pmamatis/The-Body-Synthesizer/UI/e-paper.JPG

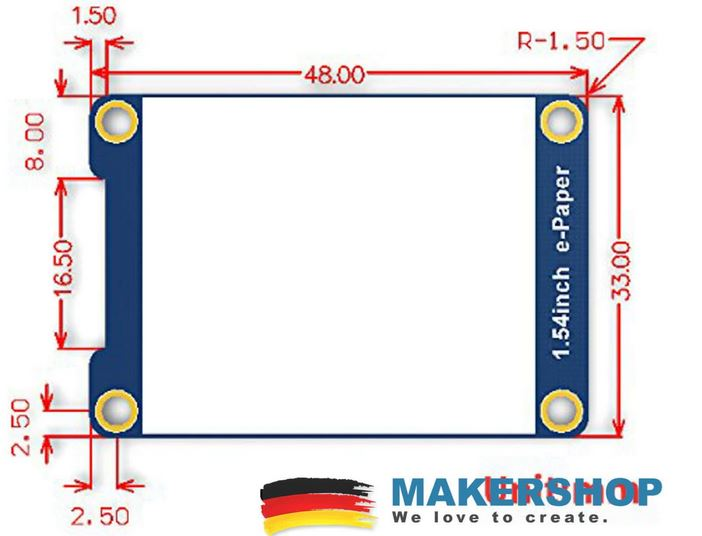
UI/e-paper.JPG
