pmamatis/The-Body-Synthesizer/EMG/pics/EMG_case_1.jpg

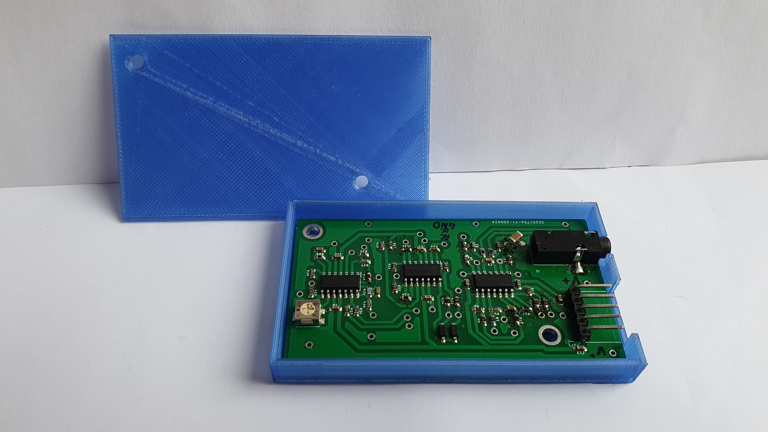
EMG/pics/EMG_case_1.jpg
