pmamatis/The-Body-Synthesizer/ACC/ACC.png

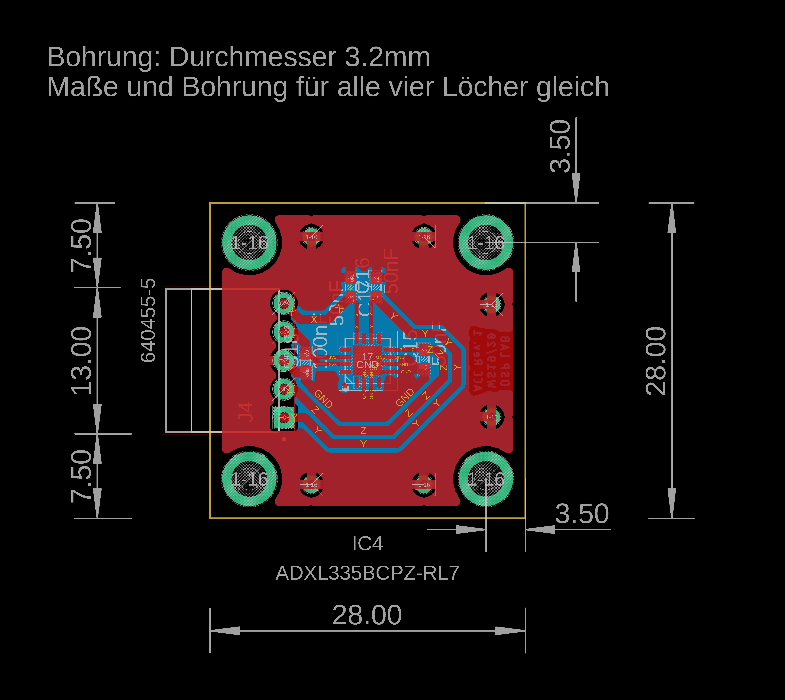
ACC/ACC.png
