pmamatis/The-Body-Synthesizer/EMG/pics/2.jpg

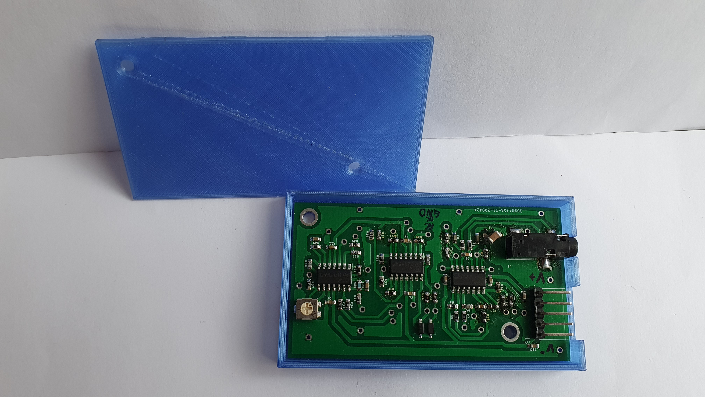
EMG/pics/2.jpg
