pmamatis/The-Body-Synthesizer/EMG/pics/EMG_board_brd_1.png

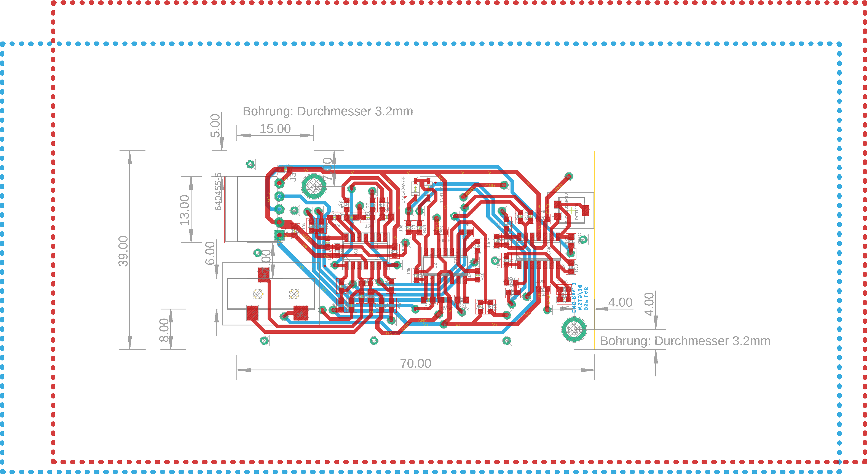
EMG/pics/EMG_board_brd_1.png
