pmamatis/The-Body-Synthesizer/EMG/pics/EMG_board_brd_1_small.png

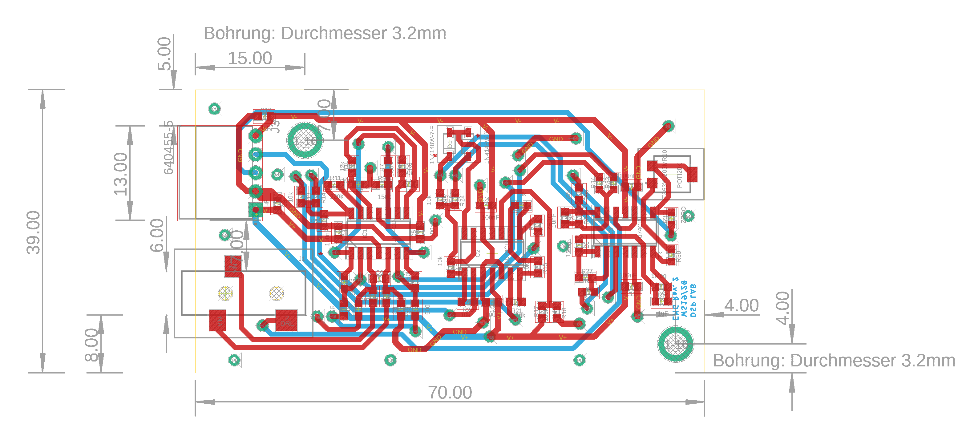
EMG/pics/EMG_board_brd_1_small.png
