pmamatis/The-Body-Synthesizer/EMG/pics/EMG_board_brd_2.png

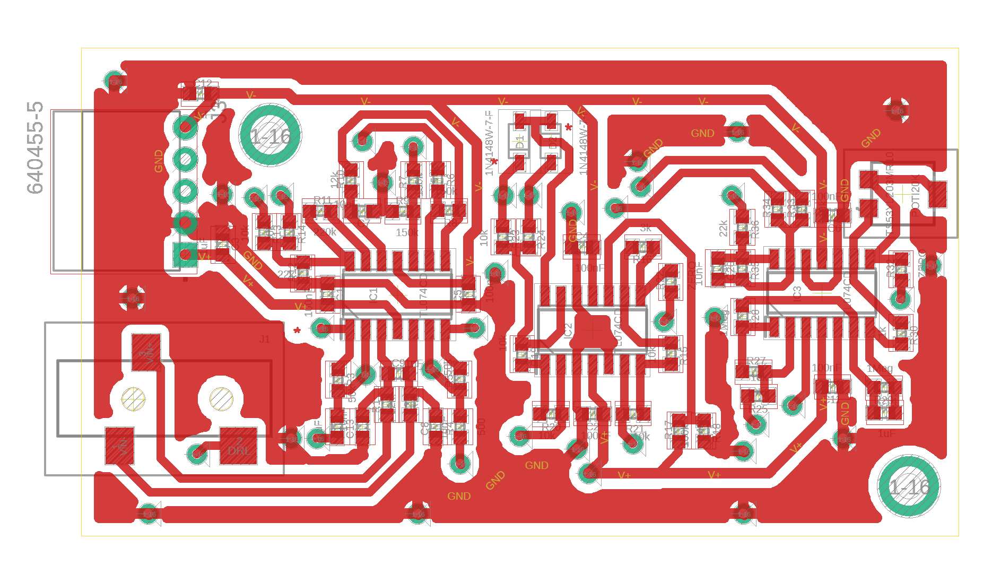
EMG/pics/EMG_board_brd_2.png
