pmamatis/The-Body-Synthesizer/EMG/pics/EMG_board_brd_3.png

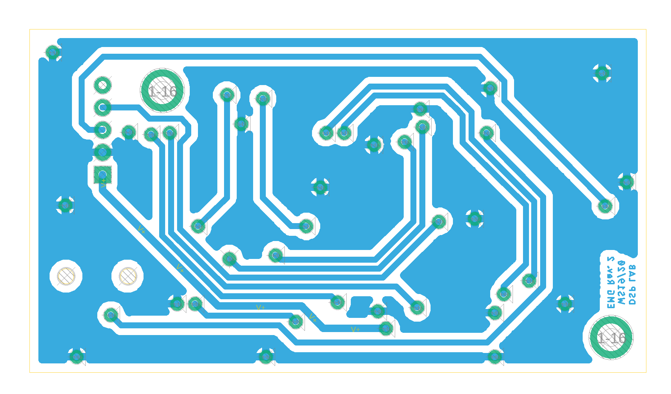
EMG/pics/EMG_board_brd_3.png
