pmamatis/The-Body-Synthesizer/EMG/pics/EMG_board_sch.png

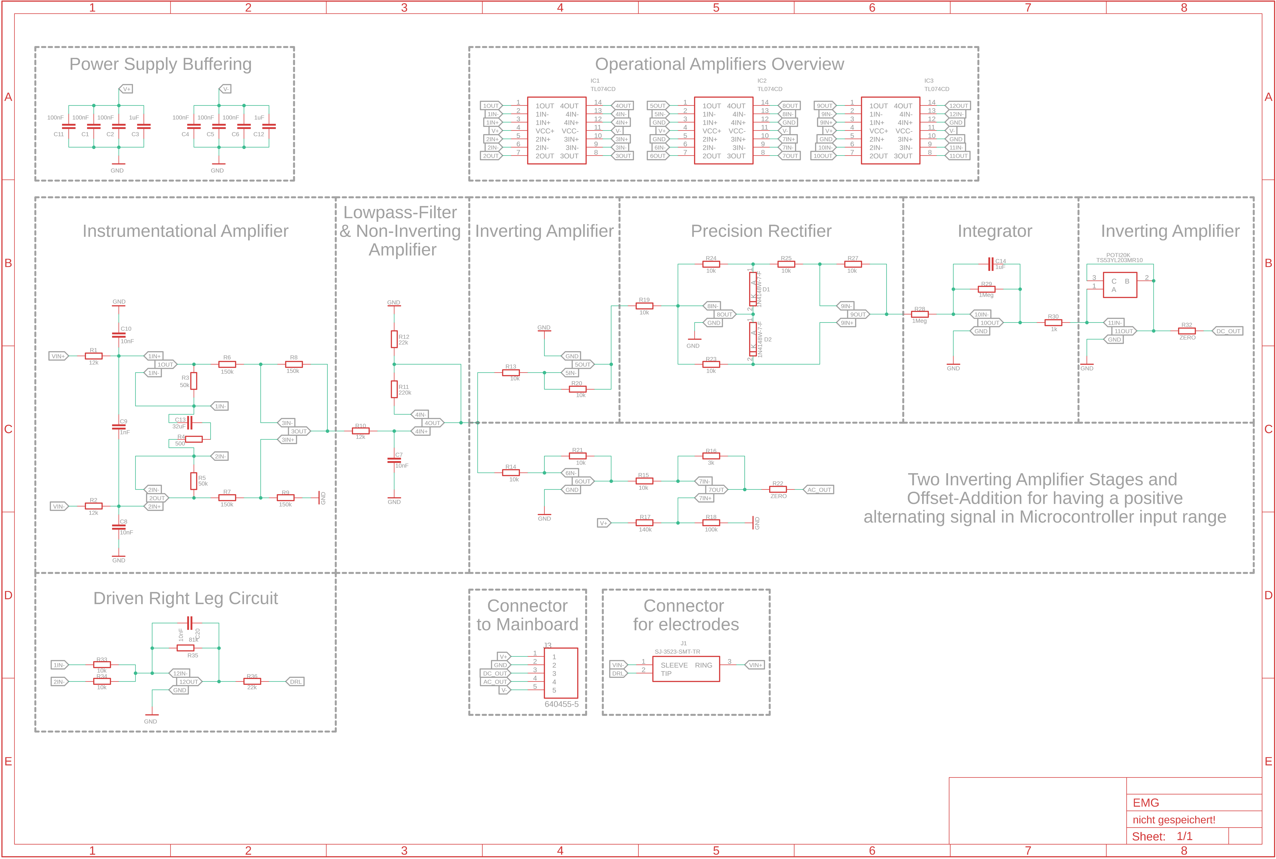
EMG/pics/EMG_board_sch.png
