pmamatis/The-Body-Synthesizer/EMG/pics/EMG_case_2.jpg

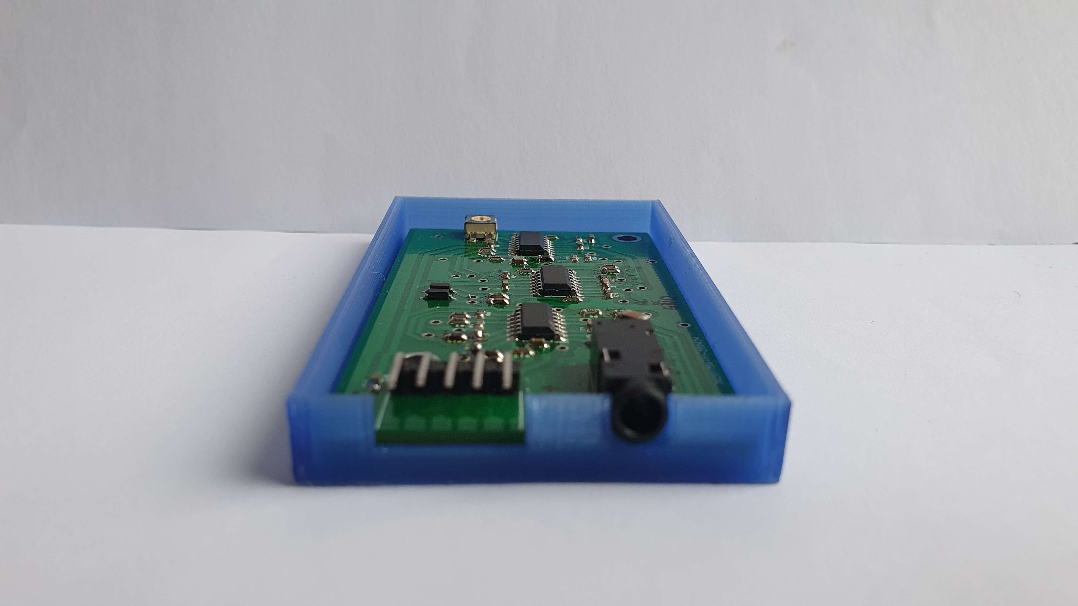
EMG/pics/EMG_case_2.jpg
