pmamatis/The-Body-Synthesizer/EMG/pics/EMG_case_3.jpg

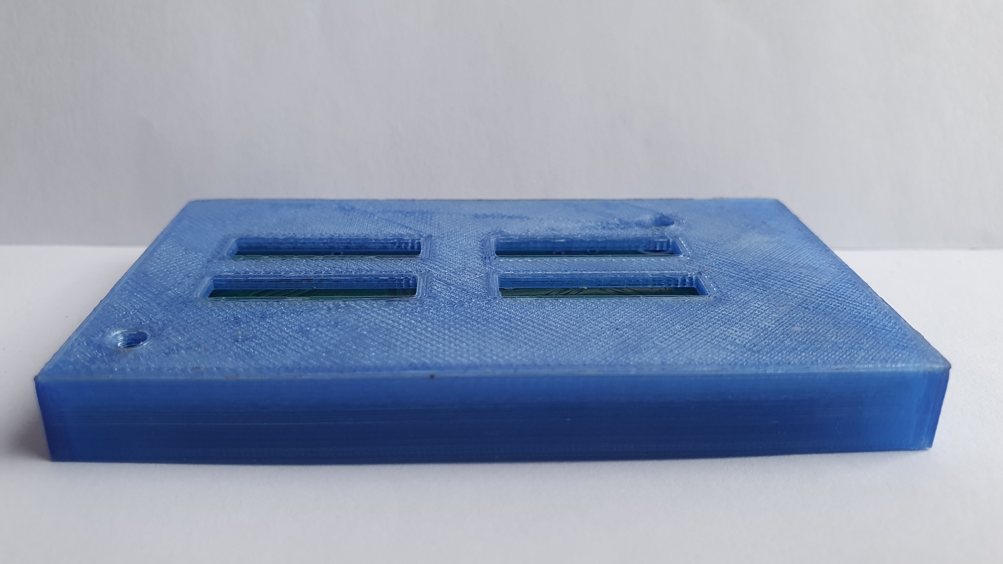
EMG/pics/EMG_case_3.jpg
