pmamatis/The-Body-Synthesizer/EMG/pics/Measurements/bericht/3_EMG_HB1.png

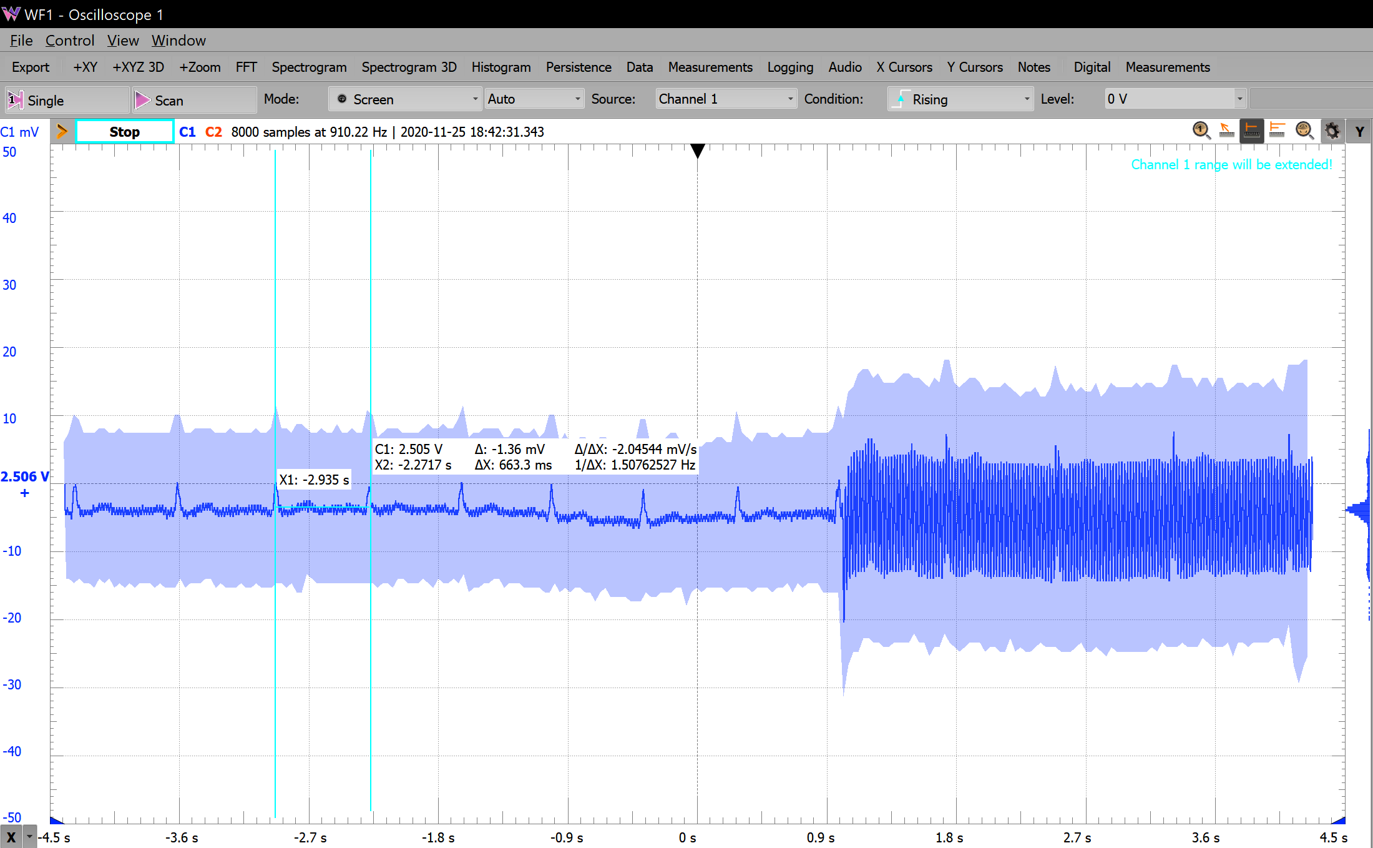
EMG/pics/Measurements/bericht/3_EMG_HB1.png
