pmamatis/The-Body-Synthesizer/EMG/pics/Measurements/bericht/3_EMG_Max_stress_2.png

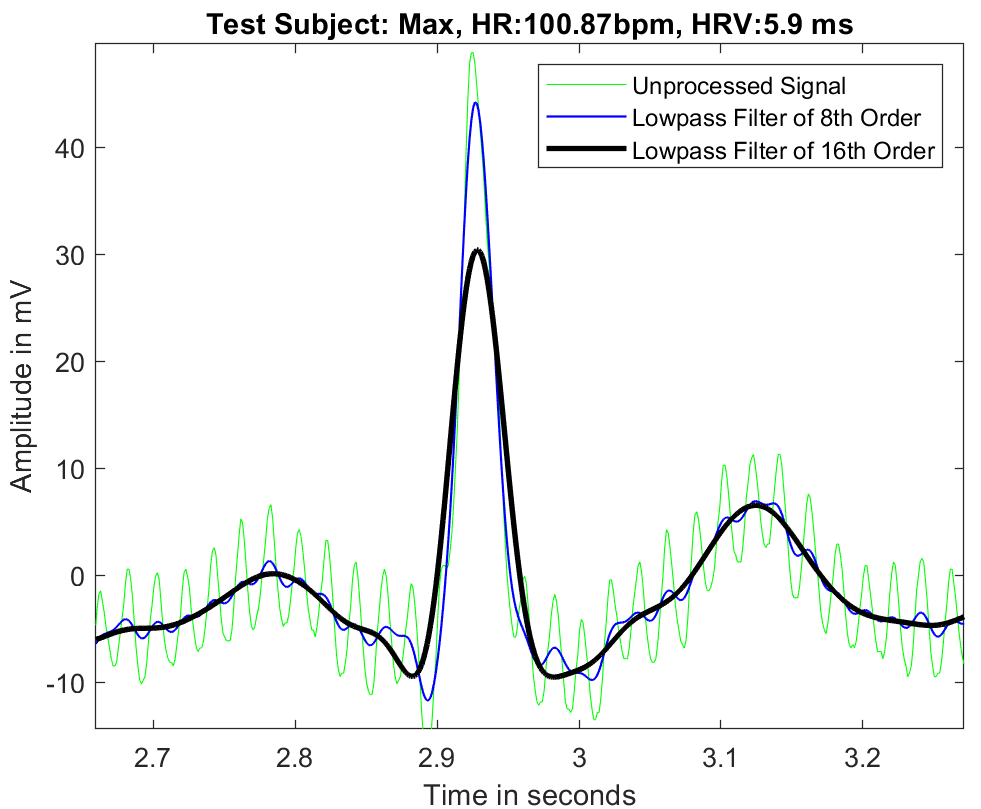
EMG/pics/Measurements/bericht/3_EMG_Max_stress_2.png
