pmamatis/The-Body-Synthesizer/EMG/pics/Measurements/bericht/3_EMG_PEAK.png

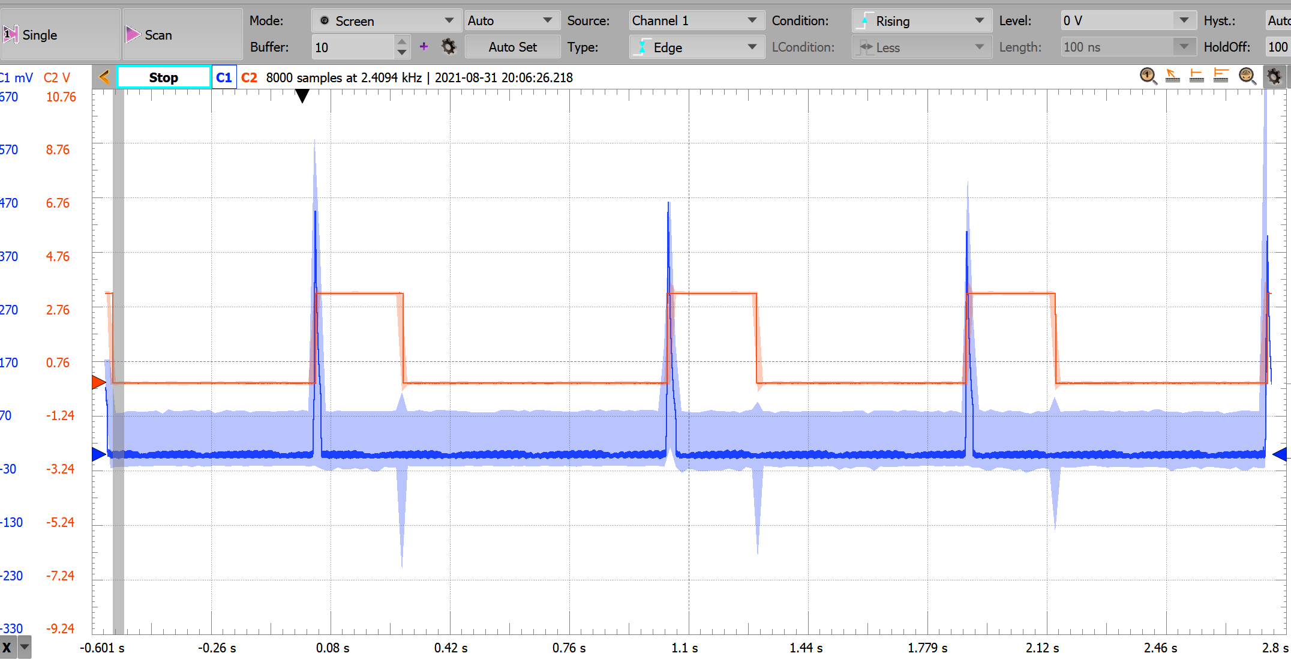
EMG/pics/Measurements/bericht/3_EMG_PEAK.png
