pmamatis/The-Body-Synthesizer/Keyboard/3_Keyboard_brd_V1.png

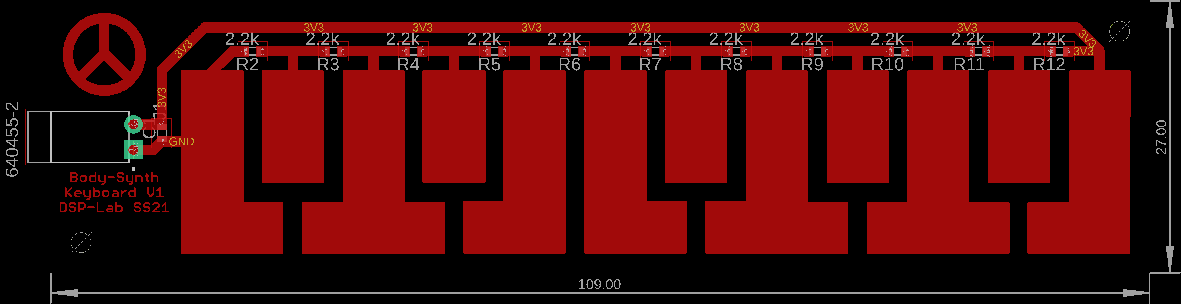
Keyboard/3_Keyboard_brd_V1.png
