pmamatis/The-Body-Synthesizer/Keyboard/3_Keyboard_brd_V2.png

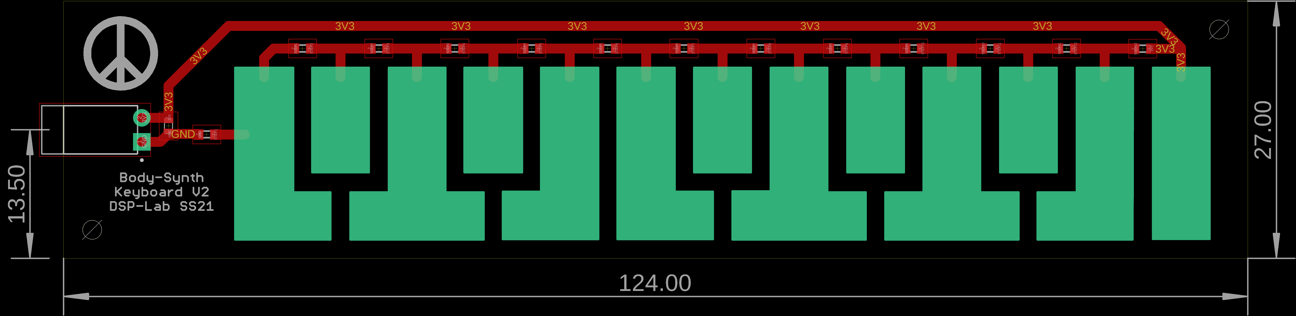
Keyboard/3_Keyboard_brd_V2.png
