pmamatis/The-Body-Synthesizer/Keyboard/3_Keyboard_sch_V2.png

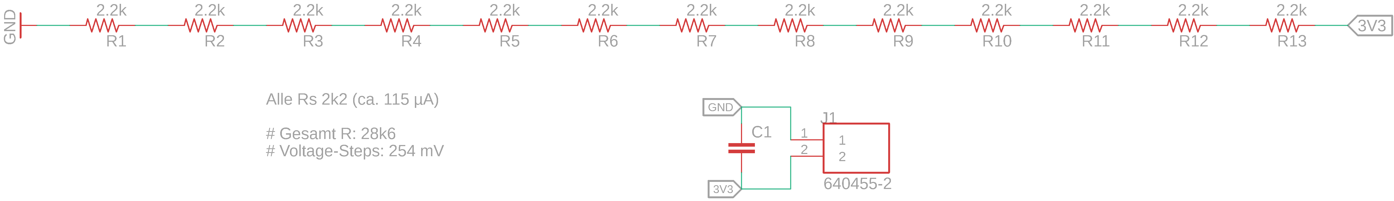
Keyboard/3_Keyboard_sch_V2.png
