pmamatis/The-Body-Synthesizer/Mainboard/pics/Gesamtsystem_pic.png

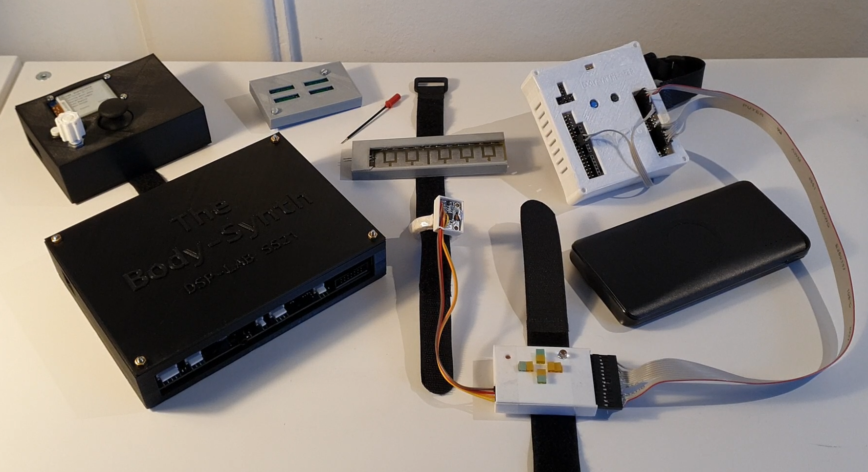
Mainboard/pics/Gesamtsystem_pic.png
