pmamatis/The-Body-Synthesizer/Mainboard/pics/Gyro_pic.png

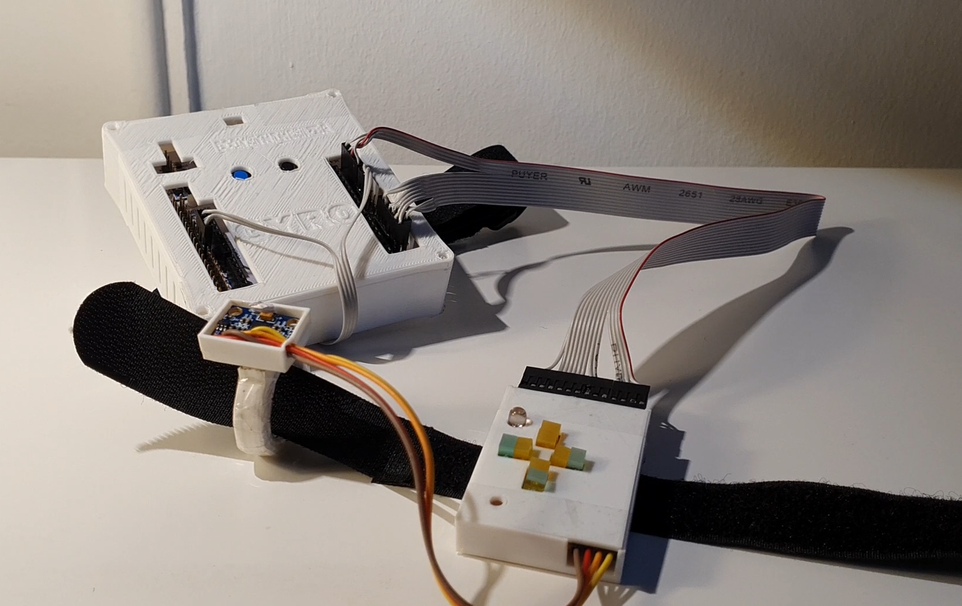
Mainboard/pics/Gyro_pic.png
