pmamatis/The-Body-Synthesizer/Mainboard/pics/Mainboard_brd_1.png

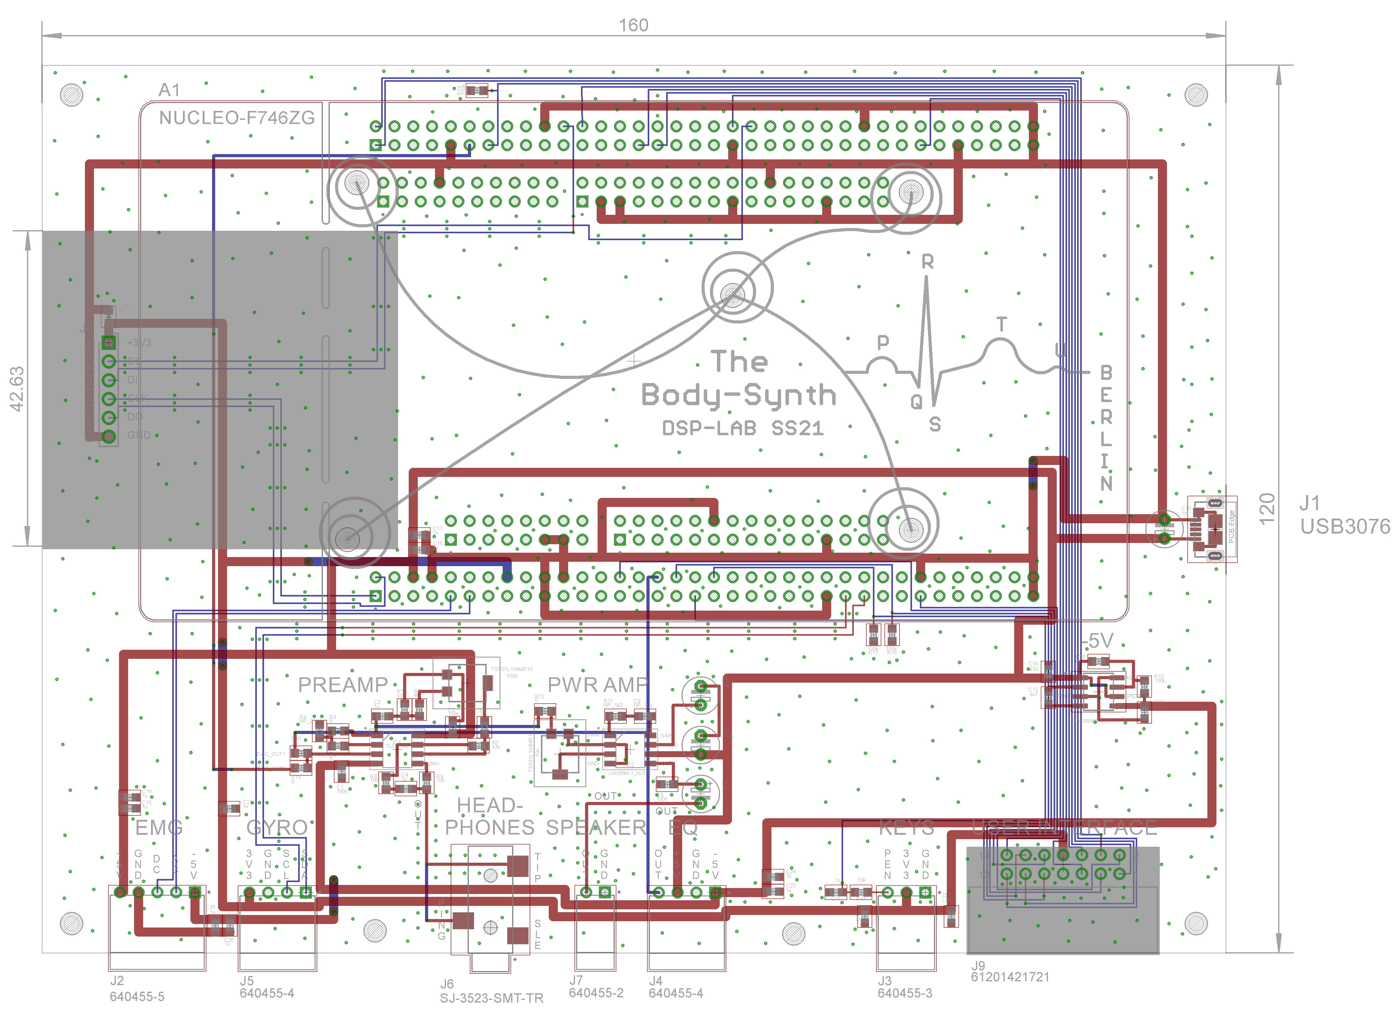
Mainboard/pics/Mainboard_brd_1.png
