pmamatis/The-Body-Synthesizer/Mainboard/pics/Mainboard_brd_2.png

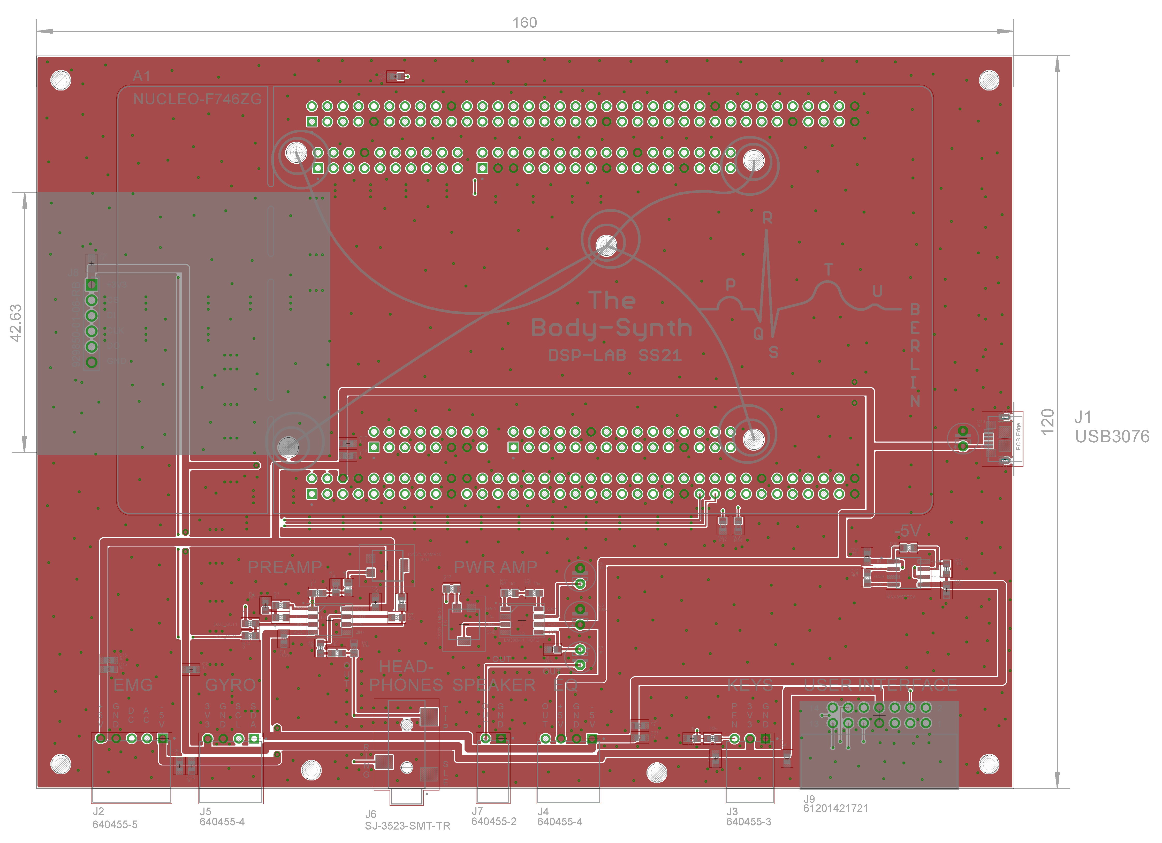
Mainboard/pics/Mainboard_brd_2.png
