pmamatis/The-Body-Synthesizer/Mainboard/pics/Mainboard_brd_3.png

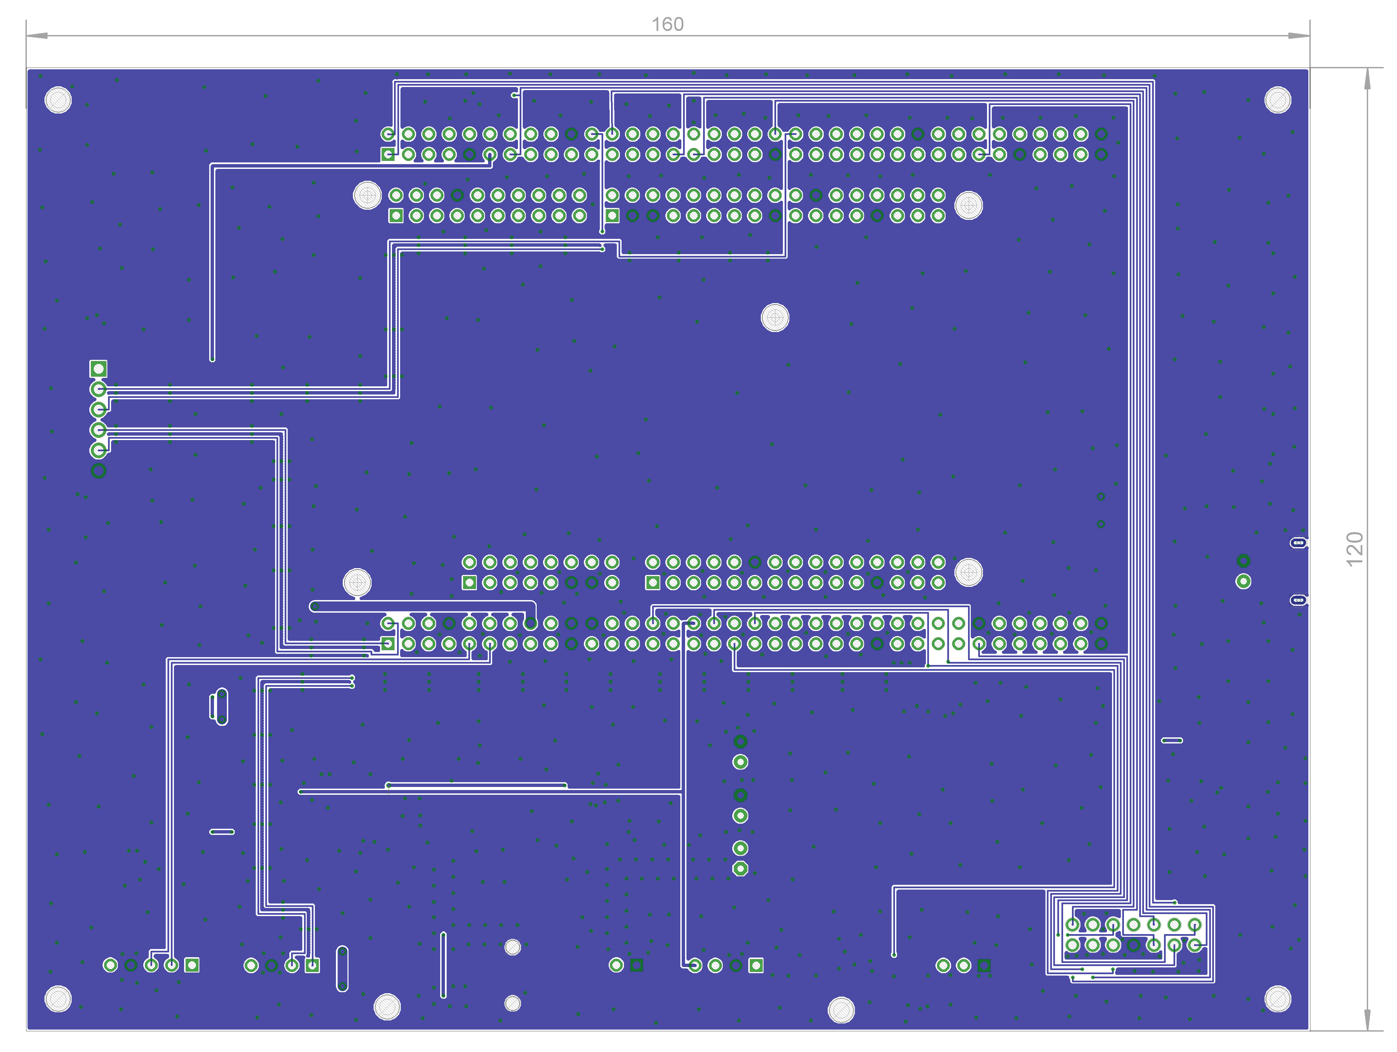
Mainboard/pics/Mainboard_brd_3.png
