pmamatis/The-Body-Synthesizer/Mainboard/pics/Mainboard_pic1.jpg

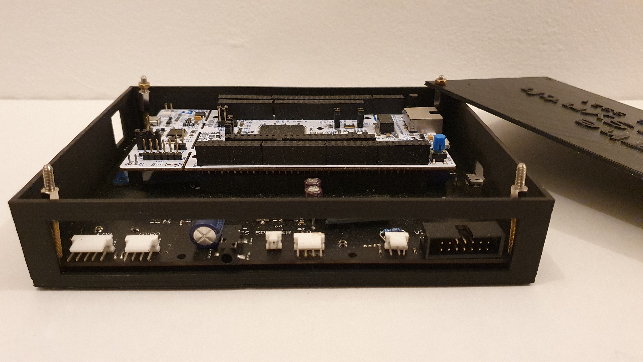
Mainboard/pics/Mainboard_pic1.jpg
