pmamatis/The-Body-Synthesizer/Mainboard/pics/Mainboard_sch_1.png

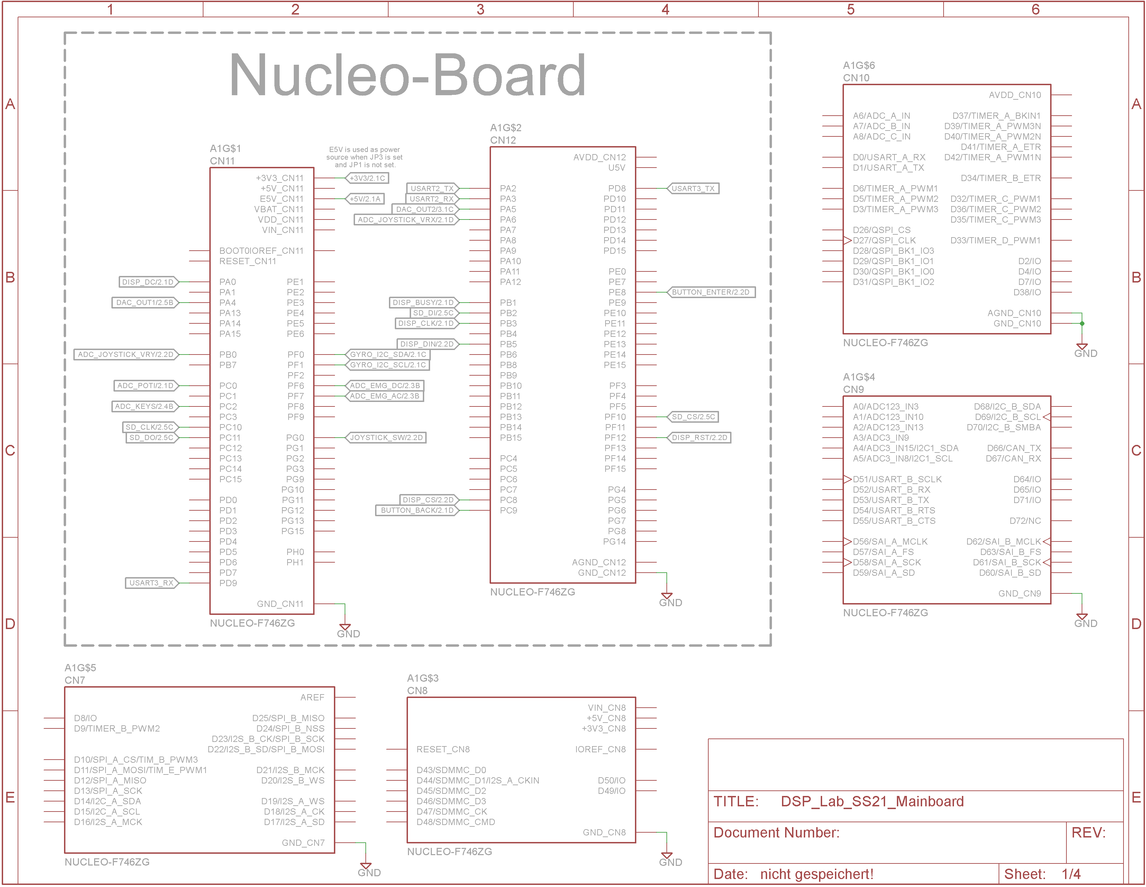
Mainboard/pics/Mainboard_sch_1.png
