pmamatis/The-Body-Synthesizer/Mainboard/pics/Mainboard_sch_2.png

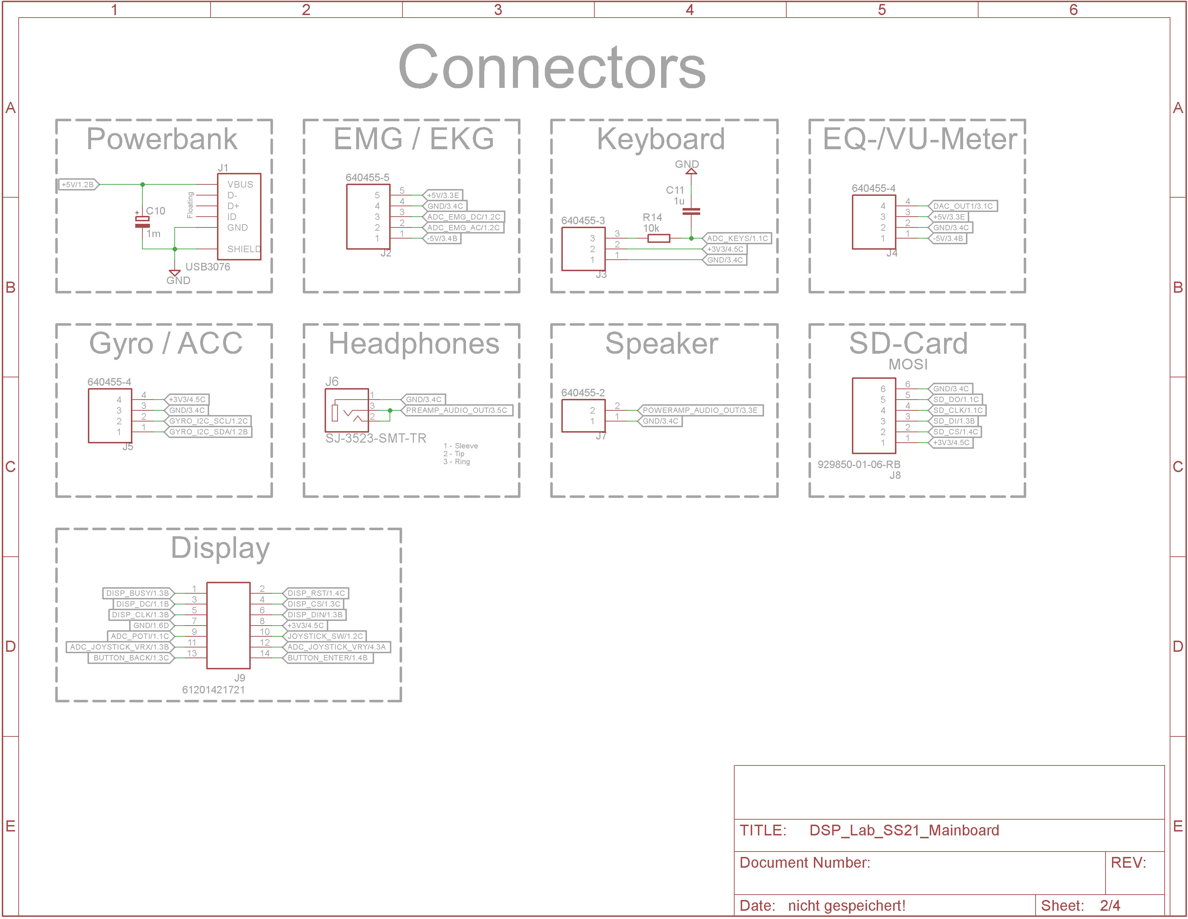
Mainboard/pics/Mainboard_sch_2.png
