pmamatis/The-Body-Synthesizer/Mainboard/pics/Mainboard_sch_3.png

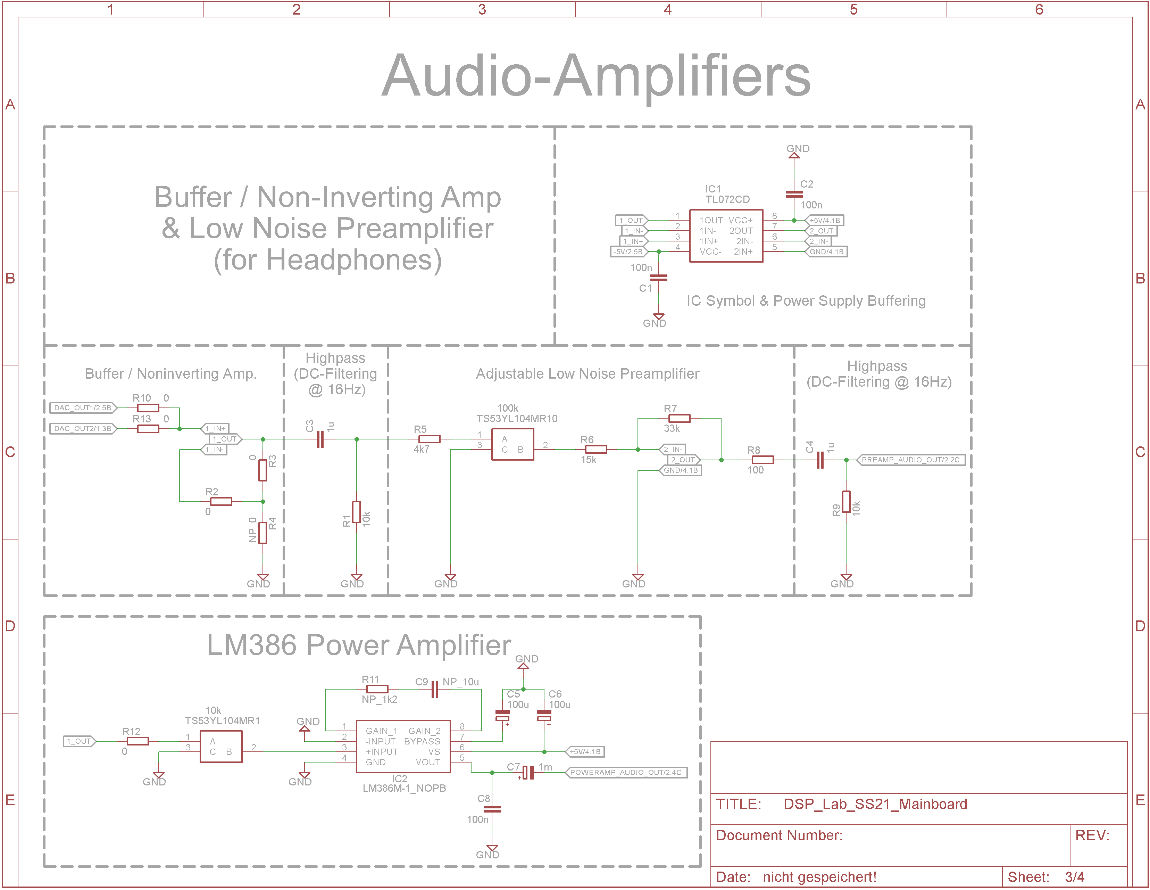
Mainboard/pics/Mainboard_sch_3.png
