pmamatis/The-Body-Synthesizer/Mainboard/pics/Mainboard_sch_4.png

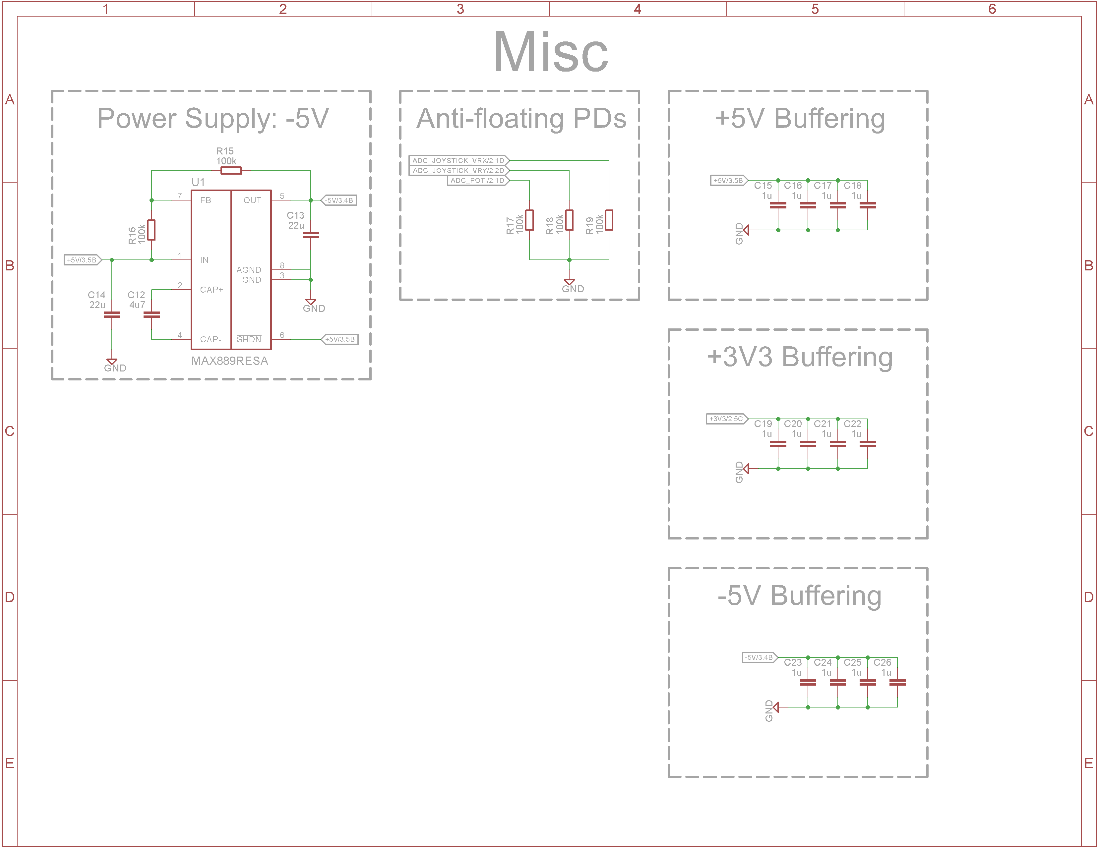
Mainboard/pics/Mainboard_sch_4.png
