pmamatis/The-Body-Synthesizer/UI/displaybild.JPG

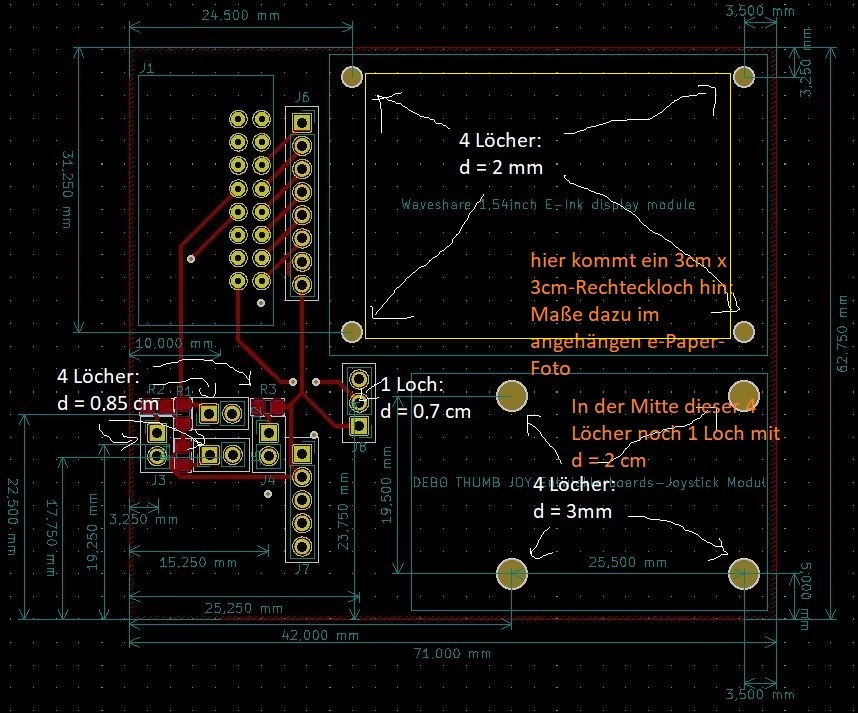
UI/displaybild.JPG
