pmamatis/The-Body-Synthesizer/210720_PRODUCTION/BOMs/BOM_DSP_Lab_SS21_Equalizer_VUMeter_fin.xlsx

Qty | Value | Device | Package | Parts | Description | AVAILABILITY | CENTERLINE_PITCH | COMMENT | DESCRIPTION | MF | MP | NUMBER_OF_POSITIONS | PACKAGE | POPULARITY | PRICE | PRODUCT_TYPE | PURCHASE-URL | SPICEPREFIX
30 |  | LEDCHIP-LED0603 | CHIP-LED0603 | LD1, LD2, LD3, LD4, LD5, LD6, LD7, LD8, LD9, LD10, LD11, LD12, LD13, LD14, LD15, LD16, LD17, LD18, LD19, LD20, LD21, LD22, LD23, LD24, LD25, LD26, LD27, LD28, LD29, LD30 | LED |  |  |  |  |  |  |  |  | 26
2 |  | MMSZ5226B-7-F | SOD3715X135L32X57N | D7, D14 | Diode Zener Single 3.3V 5% 500mW Automotive 2-Pin SOD-123 T/R Check prices | Good |  |  | Zener Diode 3.3V 500mW Â±5% Surface Mount SOD-123 | Diodes Inc. | MMSZ5226B-7-F |  | SOD-123 Diodes Inc. |  | None |  | https://pricing.snapeda.com/search/part/MMSZ5226B-7-F/?ref=eda
5 | 0 | R-EU_R0603 | R0603 | R26, R27, R103, R104, R105 | RESISTOR, European symbol
1 | 1 uF | C-EUC0603 | C0603 | CCUK | CAPACITOR, European symbol |  |  |  |  |  |  |  |  | 73 |  |  |  | C
1 | 1.13K | R-EU_R0603 | R0603 | R37 | RESISTOR, European symbol
1 | 1.54K | R-EU_R0603 | R0603 | R5 | RESISTOR, European symbol
1 | 1.62K | R-EU_R0603 | R0603 | R4 | RESISTOR, European symbol
1 | 1.82K | R-EU_R0603 | R0603 | R34 | RESISTOR, European symbol
3 | 10 uH | ASMCI-0603-100M-T | INDC1608X95N | L1, L2, L3 | MULTILAYER CHIP POWER INDUCTOR, 10UH, 50MA, CERAMIC, Â±20%, SHIELDED, 0.90 OHM, 20MHZ, 0603, SMD Check prices | Good |  |  | 10ÂµH Shielded Multilayer Inductor 50mA 900mOhm 0603 (1608 Metric) | Abracon LLC | ASMCI-0603-100M-T |  | 1608 Taiyo Yuden |  | None |  | https://pricing.snapeda.com/search/part/ASMCI-0603-100M-T/?ref=eda
1 | 10.2K | R-EU_R0603 | R0603 | R33 | RESISTOR, European symbol
1 | 100n | C-EUC0603 | C0603 | C38 | CAPACITOR, European symbol |  |  |  |  |  |  |  |  | 73 |  |  |  | C
18 | 100n | C-EUC0603 | C0603 | C3, C4, C6, C8, C9, C10, C11, C12, C13, C15, C16, C17, C18, C27, C28, C29, C32, C39 | CAPACITOR, European symbol
3 | 100u | C-EUC0603 | C0603 | C34, C35, C36 | CAPACITOR, European symbol
2 | 10K | R-EU_R0603 | R0603 | R7, R8 | RESISTOR, European symbol
8 | 10n | C-EUC0603 | C0603 | C19, C20, C21, C22, C23, C24, C25, C26 | CAPACITOR, European symbol
12 | 10u | C-EUC0603 | C0603 | C14, C40, C41, C42, C43, C44, C45, C46, C47, C48, C49, C50 | CAPACITOR, European symbol
1 | 120K | R-EU_R0603 | R0603 | R23 | RESISTOR, European symbol
1 | 12n | C-EUC0603 | C0603 | C30 | CAPACITOR, European symbol
1 | 13.3K | R-EU_R0603 | R0603 | R35 | RESISTOR, European symbol
1 | 13K | R-EU_R0603 | R0603 | R28 | RESISTOR, European symbol
1 | 15.5K | R-EU_R0603 | R0603 | R39 | RESISTOR, European symbol
1 | 15n | C-EUC0603 | C0603 | C31 | CAPACITOR, European symbol
2 | 18.2K | R-EU_R0603 | R0603 | R13, R38 | RESISTOR, European symbol
60 | 1K | R-EU_R0603 | R0603 | R43, R44, R45, R46, R47, R48, R49, R50, R51, R52, R53, R54, R55, R56, R57, R58, R59, R60, R61, R62, R63, R64, R65, R66, R67, R68, R69, R70, R71, R72, R73, R74, R75, R76, R77, R78, R79, R80, R81, R82, R83, R84, R85, R86, R87, R88, R89, R90, R91, R92, R93, R94, R95, R96, R97, R98, R99, R100, R101, R102 | RESISTOR, European symbol
30 | 1N4148WS | 1N4148WS | SODFL2512X100N | D1, D2, D3, D4, D5, D6, D8, D9, D10, D11, D12, D13, D15, D16, D17, D18, D19, D20, D22, D23, D24, D25, D26, D27, D29, D30, D31, D32, D33, D34 | 1N4148WS Series 75 V 300 mA Surface Mount Small Signal Diodes - SOD-323F Check prices | Good |  |  | Diode Standard 75V 150mA Surface Mount SOD-323F | ON Semiconductor | 1N4148WS |  | SOD-323FL-2 ON Semiconductor |  | None |  | https://pricing.snapeda.com/search/part/1N4148WS/?ref=eda
1 | 2.2 uF | C-EUC0603 | C0603 | C5 | CAPACITOR, European symbol |  |  |  |  |  |  |  |  | 73 |  |  |  | C
2 | 200u | C-EUC0603 | C0603 | C33, C37 | CAPACITOR, European symbol
1 | 20K | R-EU_R0603 | R0603 | R30 | RESISTOR, European symbol
2 | 22 uF | C-EUC0603 | C0603 | CIN, COUT | CAPACITOR, European symbol |  |  |  |  |  |  |  |  | 73 |  |  |  | C
1 | 220 pF | C-EUC0603 | C0603 | CF | CAPACITOR, European symbol |  |  |  |  |  |  |  |  | 73 |  |  |  | C
2 | 220n | C-EUC0603 | C0603 | C1, C2 | CAPACITOR, European symbol
1 | 22K | R-EU_R0603 | R0603 | R24 | RESISTOR, European symbol
1 | 23.2K | R-EU_R0603 | R0603 | R10 | RESISTOR, European symbol
1 | 29.1K | R-EU_R0603 | R0603 | R18 | RESISTOR, European symbol
2 | 29.4K | R-EU_R0603 | R0603 | R40, RFB1 | RESISTOR, European symbol
1 | 2K | R-EU_R0603 | R0603 | R21 | RESISTOR, European symbol
1 | 3,3K | R-EU_R0603 | R0603 | R22 | RESISTOR, European symbol
1 | 3.16K | R-EU_R0603 | R0603 | R17 | RESISTOR, European symbol
4 | 3.3k | R-EU_R0603 | R0603 | R3, R11, R19, R41 | RESISTOR, European symbol
1 | 3.7K | R-EU_R0603 | R0603 | R2 | RESISTOR, European symbol
1 | 3.9K | R-EU_R0603 | R0603 | R1 | RESISTOR, European symbol
1 | 330 pF | C-EUC0603 | C0603 | CFF | CAPACITOR, European symbol |  |  |  |  |  |  |  |  | 73 |  |  |  | C
4 | 35K | R-EU_R0603 | R0603 | R6, R12, R25, R42 | RESISTOR, European symbol
1 | 3K | R-EU_R0603 | R0603 | R9 | RESISTOR, European symbol
1 | 4.7 uF | C-EUC0603 | C0603 | C7 | CAPACITOR, European symbol |  |  |  |  |  |  |  |  | 73 |  |  |  | C
1 | 4K | R-EU_R0603 | R0603 | R20 | RESISTOR, European symbol
1 | 5.23K | R-EU_R0603 | R0603 | R29 | RESISTOR, European symbol
1 | 5.76K | R-EU_R0603 | R0603 | RFB2 | RESISTOR, European symbol
1 | 5.9K | R-EU_R0603 | R0603 | R14 | RESISTOR, European symbol
1 | 51K | R-EU_R0603 | R0603 | R32 | RESISTOR, European symbol
1 | 53,6K | R-EU_R0603 | R0603 | R15 | RESISTOR, European symbol
1 | 6.2K | R-EU_R0603 | R0603 | R36 | RESISTOR, European symbol
1 | 640455-4 | 640455-4 | TE_640455-4 | J2 | Check prices | In Stock | 2.54 mm[.1 in] | 640455-4 | Headers & Receptacles cable a placa 8 POS MONO SHAPE MKII TAB ASS'Y GW 750.N TYCO / TE CONNECTIVITY | TE Connectivity | 640455-4 | 4 | None |  | None | Connector | https://pricing.snapeda.com/search/part/640455-4/?ref=eda
1 | 68 K | R-EU_R0603 | R0603 | R31 | RESISTOR, European symbol
1 | 9.76K | R-EU_R0603 | R0603 | R16 | RESISTOR, European symbol
29 | BC846A | BC846A | SOT23-3 | T1, T2, T3, T4, T5, T6, T7, T8, T9, T11, T12, T13, T14, T15, T16, T17, T18, T19, T20, T21, T22, T23, T24, T25, T26, T27, T28, T29, T30 |  | Unavailable |  |  | Bipolar (BJT) Transistor NPN 65V 100mA 100MHz 300mW Surface Mount SOT-23-3 (TO-236) | ON Semiconductor | BC846A |  | SOT-23-3 Motorola |  | None
1 | BC846A | BC846A | SOT23-3 | T10 |  | Unavailable |  |  | Bipolar (BJT) Transistor NPN 65V 100mA 100MHz 300mW Surface Mount SOT-23-3 (TO-236) | ON Semiconductor | BC846A |  | SOT-23-3 Motorola |  | None |  |  | J
1 | LM2611 | LM2611BMFX/NOPB | SOT95P280X145-5N | U1 | Check prices | Good |  |  | 1.4MHz Cuk Converter 5-SOT-23 -40 to 125 | Texas Instruments | LM2611BMFX/NOPB |  | SOT-23-5 Texas Instruments |  | None |  | https://pricing.snapeda.com/search/part/LM2611BMFX/NOPB/?ref=eda
1 | LMR62014 | LMR62014XMF/NOPB | SOT95P280X145-5N | U2 | Check prices | Good |  |  | SIMPLE SWITCHER&reg | 2.7V to 14V, 1.4A Step-Up Regulator in SOT-23 Package 5-SOT-23 -40 to 125 | Texas Instruments | LMR62014XMF/NOPB |  | SOT-23-5 Texas Instruments |  | None |  | https://pricing.snapeda.com/search/part/LMR62014XMF/NOPB/?ref=eda
5 | MMSZ5226B-7-F | MMSZ5226B-7-F | SOD3715X135L32X57N | D100, D101, D102, D103, D104 | Diode Zener Single 3.3V 5% 500mW Automotive 2-Pin SOD-123 T/R Check prices | Good |  |  | Zener Diode 3.3V 500mW Â±5% Surface Mount SOD-123 | Diodes Inc. | MMSZ5226B-7-F |  | SOD-123 Diodes Inc. |  | None |  | https://pricing.snapeda.com/search/part/MMSZ5226B-7-F/?ref=eda
3 | TL072D | TL072D | SO08 | IC1, IC5, IC7 | OP AMP |  |  |  |  |  |  |  |  | 0
3 | TL074D | TL074D | SO14 | IC2, IC3, IC4 | OP AMP |  |  |  |  |  |  |  |  | 0
