pmamatis/The-Body-Synthesizer/210720_PRODUCTION/BOMs/BOM_DSP_Lab_SS21_Keyboard_V2.xlsx

Qty | Value | Device | Package | Parts | Description | AVAILABILITY | COMMENT | DESCRIPTION | EU_ROHS_COMPLIANCE | MF | MP | PACKAGE | POPULARITY | PRICE | SPICEPREFIX | TE_PURCHASE_URL
1 |  | C-EUC0603 | C0603 | C1 | CAPACITOR, European symbol |  |  |  |  |  |  |  | 73 |  | C
13 | 2.2k | R-US_R0603 | R0603 | R1, R2, R3, R4, R5, R6, R7, R8, R9, R10, R11, R12, R13 | RESISTOR, American symbol
1 | 640455-2 | 640455-2 | TE_640455-2 | J1 |  | Unavailable | 640455-2 | MTA-100 2 Position 2.54 mm Single Row Right Angle Wire to Board Header | Compliant | TE Connectivity | 640455-2 | None |  | None |  | https://www.te.com/usa-en/product-640455-2.html?te_bu=Cor&te_type=disp&elqCampaignId=32493
