pmamatis/The-Body-Synthesizer/210720_PRODUCTION/BOMs/BOM_DSP_Lab_SS21_Mainboard.xlsx

Qty | Value | Device | Package | Parts | Description | AVAILABILITY | COMMENT | CUI_PURCHASE_URL | DESCRIPTION | DIGI-KEY_PART_NUMBER | DIGI-KEY_PURCHASE_URL | EU_ROHS_COMPLIANCE | HEIGHT | MANUFACTURER_NAME | MANUFACTURER_PART_NUMBER | MF | MOUSER_PART_NUMBER | MOUSER_PRICE-STOCK | MP | PACKAGE | PRICE | PURCHASE-URL | TE_PURCHASE_URL
5 | 0 | R-EU_R0603 | R0603 | R2, R3, R10, R12, R13 | RESISTOR, European symbol
1 | 100 | R-EU_R0603 | R0603 | R8 | RESISTOR, European symbol
2 | 100k | R-EU_R0603 | R0603 | R15, R16 | RESISTOR, European symbol
1 | 100k | TS53YL203MR10 | TS53YL203MR10 | TS53YL104MR10 | Vishay TS53YL Series SMD Trimmer Resistor with Gull Wing Terminations, 20k +/-20% 1/4W +/-100ppm/C Top Adjust |  |  |  | Vishay TS53YL Series SMD Trimmer Resistor with Gull Wing Terminations, 20k +/-20% 1/4W +/-100ppm/C Top Adjust |  |  |  | 2.7mm | Vishay | TS53YL203MR10 |  | 72-TS53YL-20K | https://www.mouser.com/Search/Refine.aspx?Keyword=72-TS53YL-20K
3 | 100n | C-EUC0603 | C0603 | C1, C2, C8 | CAPACITOR, European symbol
2 | 100u | CPOL-EUE2.5-5 | E2,5-5 | C5, C6 | POLARIZED CAPACITOR, European symbol
3 | 10k | R-EU_R0603 | R0603 | R1, R9, R14 | RESISTOR, European symbol
1 | 10k | TS53YL203MR10 | TS53YL203MR10 | TS53YL104MR1 | Vishay TS53YL Series SMD Trimmer Resistor with Gull Wing Terminations, 20k +/-20% 1/4W +/-100ppm/C Top Adjust |  |  |  | Vishay TS53YL Series SMD Trimmer Resistor with Gull Wing Terminations, 20k +/-20% 1/4W +/-100ppm/C Top Adjust |  |  |  | 2.7mm | Vishay | TS53YL203MR10 |  | 72-TS53YL-20K | https://www.mouser.com/Search/Refine.aspx?Keyword=72-TS53YL-20K
1 | 15k | R-EU_R0603 | R0603 | R6 | RESISTOR, European symbol
3 | 1Meg | R-EU_R0603 | R0603 | R17, R18, R19 | RESISTOR, European symbol
2 | 1m | CPOL-EUE2.5-5 | E2,5-5 | C7, C10 | POLARIZED CAPACITOR, European symbol
15 | 1u | C-EUC0603 | C0603 | C3, C4, C11, C15, C16, C17, C18, C19, C20, C21, C22, C23, C24, C25, C26 | CAPACITOR, European symbol
2 | 22u | C-EUC0603 | C0603 | C13, C14 | CAPACITOR, European symbol
1 | 33k | R-EU_R0603 | R0603 | R7 | RESISTOR, European symbol
1 | 4k7 | R-EU_R0603 | R0603 | R5 | RESISTOR, European symbol
1 | 4u7 | C-EUC0603 | C0603 | C12 | CAPACITOR, European symbol
1 | 61201421721 | 61201421721 | 61201421721 | J9 | WR-BHD 2.54mm Male Angled Box Header, 14 Pins=>Code : Con_WTB_BHD_2.54_Male_THT_WS_61201421721 | In Stock |  |  | Connector Header Through Hole, Right Angle 14 position 0.100 (2.54mm) |  |  |  |  |  |  | Würth Elektronik |  |  | 61201421721 | None | None
1 | 640455-2 | 640455-2 | TE_640455-2 | J7 | Check prices | In Stock | 640455-2 |  | MTA-100 2 Position 2.54 mm Single Row Right Angle Wire to Board Header |  |  | Compliant |  |  |  | TE Connectivity |  |  | 640455-2 | None | None | https://pricing.snapeda.com/search/part/640455-2/?ref=eda
1 | 640455-3 | 640455-3 | TE_640455-3 | J3 | Check prices | In Stock | 640455-3 |  | Connector Header Through Hole, Right Angle 3 position 0.100 (2.54mm) |  |  | Compliant |  |  |  | TE Connectivity |  |  | 640455-3 | None | None | https://pricing.snapeda.com/search/part/640455-3/?ref=eda
2 | 640455-4 | 640455-4 | TE_640455-4 | J4, J5 | Check prices | In Stock | 640455-4 |  | Headers & Receptacles cable a placa 8 POS MONO SHAPE MKII TAB ASS'Y GW 750.N TYCO / TE CONNECTIVITY |  |  | Compliant |  |  |  | TE Connectivity |  |  | 640455-4 | None | None
1 | 640455-5 | 640455-5 | TE_640455-5 | J2 |  |  | 640455-5 |  | MTA-100 5 Position Through Hole Single Row Right Angle Wire to Board Header | A19453-ND | https://www.digikey.de/product-detail/en/te-connectivity-amp-connectors/640455-5/A19453-ND/259000 |  |  |  |  | TE Connectivity |  |  | 640455-5 | None |  |  | https://www.te.com/usa-en/product-640455-5.html?te_bu=Cor&te_type=disp&elqCampaignId=32493
1 | 929850-01-06-RB | 929850-01-06-RB | RHDR6W76P0X254_1X6_1524X254X82 | J8 | Headers & Wire Housings 6P STRT BRD MNT SKT 1 ROW 30MICRO AU" |  |  |  | Headers & Wire Housings 6P STRT BRD MNT SKT 1 ROW 30MICRO AU" |  |  |  | 8.26mm | 3M | 929850-01-06-RB |  | 517-929850-01-06-RB | https://www.mouser.co.uk/ProductDetail/3M-Electronic-Solutions-Division/929850-01-06-RB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
1 | LM386M-1_NOPB | LM386M-1_NOPB | SOIC127P600X175-8N | IC2 | Wide Input Voltage Low Power Audio Amplifier with Internal Gain |  |  |  | Wide Input Voltage Low Power Audio Amplifier with Internal Gain |  |  |  | 1.75mm | Texas Instruments | LM386M-1/NOPB |  | 926-LM386M-1/NOPB | https://www.mouser.co.uk/ProductDetail/Texas-Instruments/LM386M-1-NOPB?qs=QbsRYf82W3GaJvrwUmrW3g%3D%3D
1 | MAX889RESA | MAX889RESA | SOIC127P600X175-8N | U1 | Check prices | In Stock |  |  | Charge Pump Switching Regulator IC Negative Adjustable -2.5V 1 Output 200mA 8-SOIC (0.154, 3.90mm Width) |  |  |  |  |  |  | Maxim Integrated |  |  | MAX889RESA+ | SOIC-8 Maxim | None
1 | NP_0 | R-EU_R0603 | R0603 | R4 | RESISTOR, European symbol
1 | NP_10u | C-EUC0603 | C0603 | C9 | CAPACITOR, European symbol
1 | NP_1k2 | R-EU_R0603 | R0603 | R11 | RESISTOR, European symbol
1 | NUCLEO-F746ZG | NUCLEO-F746ZG | MODULE_NUCLEO-F746ZG | A1 | STM32 Nucleo-144 development board with STM32F746ZG MCU, supports Arduino, ST Zio and morpho connectivity Check prices | In Stock |  |  | STM32F746ZG, mbed-Enabled Development Nucleo-144 STM32F7 ARM® Cortex®-M7 MCU 32-Bit Embedded Evaluation Board |  |  |  |  |  |  | STMicroelectronics |  |  | NUCLEO-F746ZG | None | None
1 | SJ-3523-SMT-TR | SJ-3523-SMT-TR | CUI_SJ-3523-SMT-TR | J6 | Audio Jack Connector 3.5 mm Low Profile Surface Mount Stereo Jack, 3 Pin Right-Angle Check prices | In Stock |  | https://www.cuidevices.com/product/interconnect/connectors/audio-connectors/jacks/sj-352x-smt-series | 3.5 mm, Stereo, Right Angle, Surface Mount (SMT), 3 Conductors, 0~1 Internal Switches, Audio Jack Connector |  |  |  |  |  |  | CUI Devices |  |  | SJ-3523-SMT-TR | LGA-10 STMicroelectronics | None
1 | TL072CD | TL072CD | SOIC127P600X175-8N | IC1 | Dual Low-Noise JFET-Input General-Purpose Operational Amplifier |  |  |  | Dual Low-Noise JFET-Input General-Purpose Operational Amplifier |  |  |  | 1.75mm | Texas Instruments | TL072CD |  | 595-TL072CD | https://www.mouser.com/Search/Refine.aspx?Keyword=595-TL072CD
1 | USB3076 | USB3076-XX-X_REVC | GCT_USB3076-XX-X_REVC | J1 | Micro USB Receptacle, Type B, SMT, Horizontal, Bottom Mount w/out Peg, w/out Shell Stakes, w/out Mating Face Lead-In Check prices | In Stock |  |  | USB - micro B USB 2.0 Receptacle Connector 5 Position Surface Mount, Right Angle | Through Hole, 2.35mm profile, 5 Pins, Horizontal, Bottom mount |  |  |  |  |  |  | Global Connector Technology |  |  | USB3076-30-A | None | None
