pmamatis/The-Body-Synthesizer/Mainboard/Case/Mainboard Bottom.stl

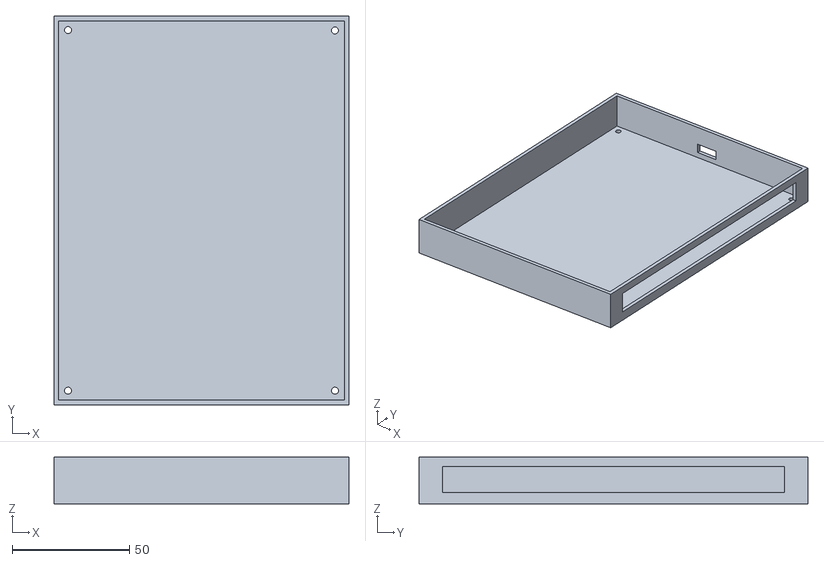
[picture p33: CAD file, 2021-08-12]
Mainboard/Case/Mainboard Bottom.stl
126.0 x 166.0 x 20.0
