pmamatis/The-Body-Synthesizer/Mainboard/Case/Mainboard Top.stl

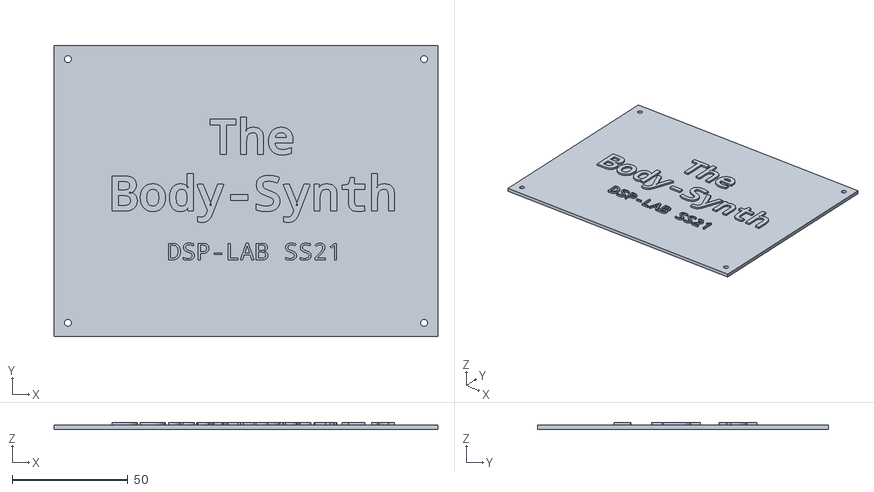
[picture p34: CAD file, 2021-08-12]
Mainboard/Case/Mainboard Top.stl
166.0 x 126.0 x 3.00
