pmamatis/The-Body-Synthesizer/EMG/pics/Measurements/7_stefan_1.png

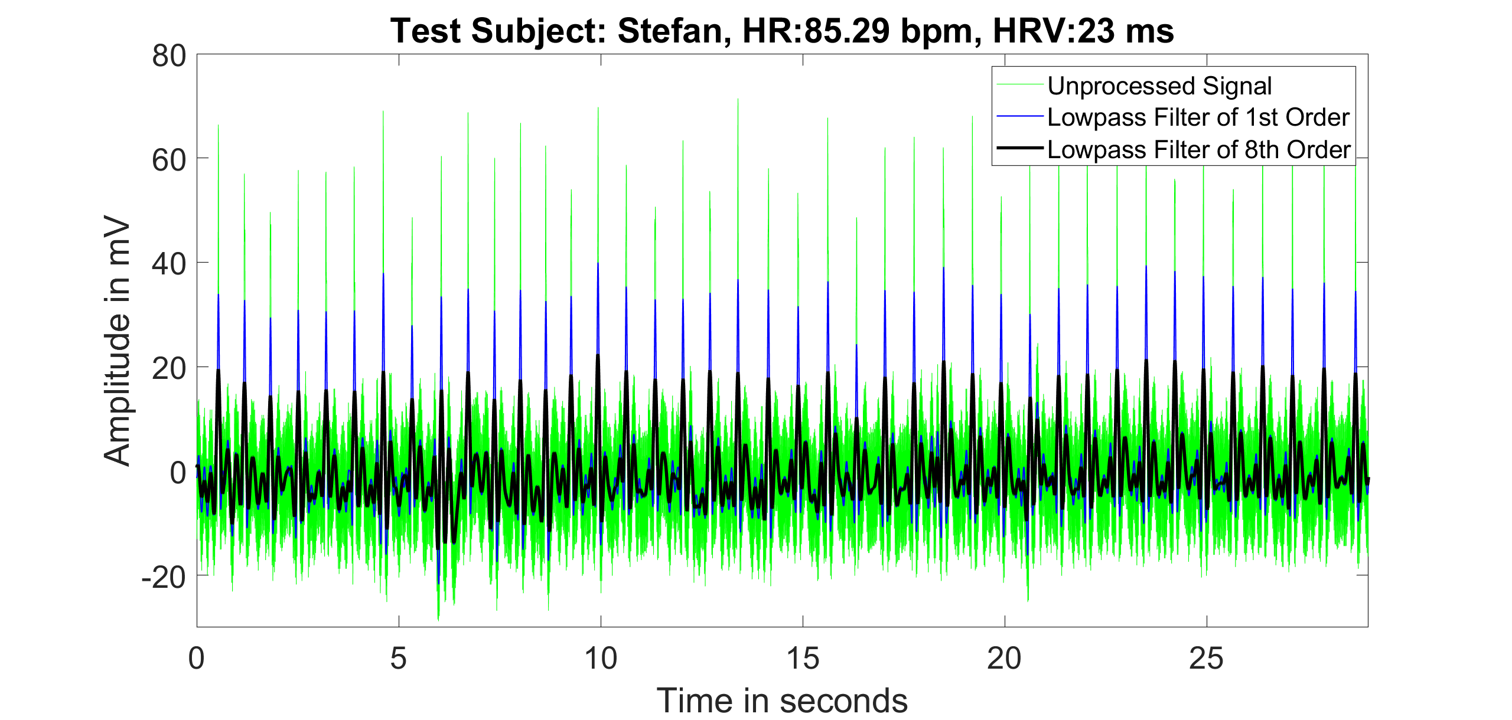
EMG/pics/Measurements/7_stefan_1.png
