pmamatis/The-Body-Synthesizer/EMG/pics/Measurements/heartbeat.png

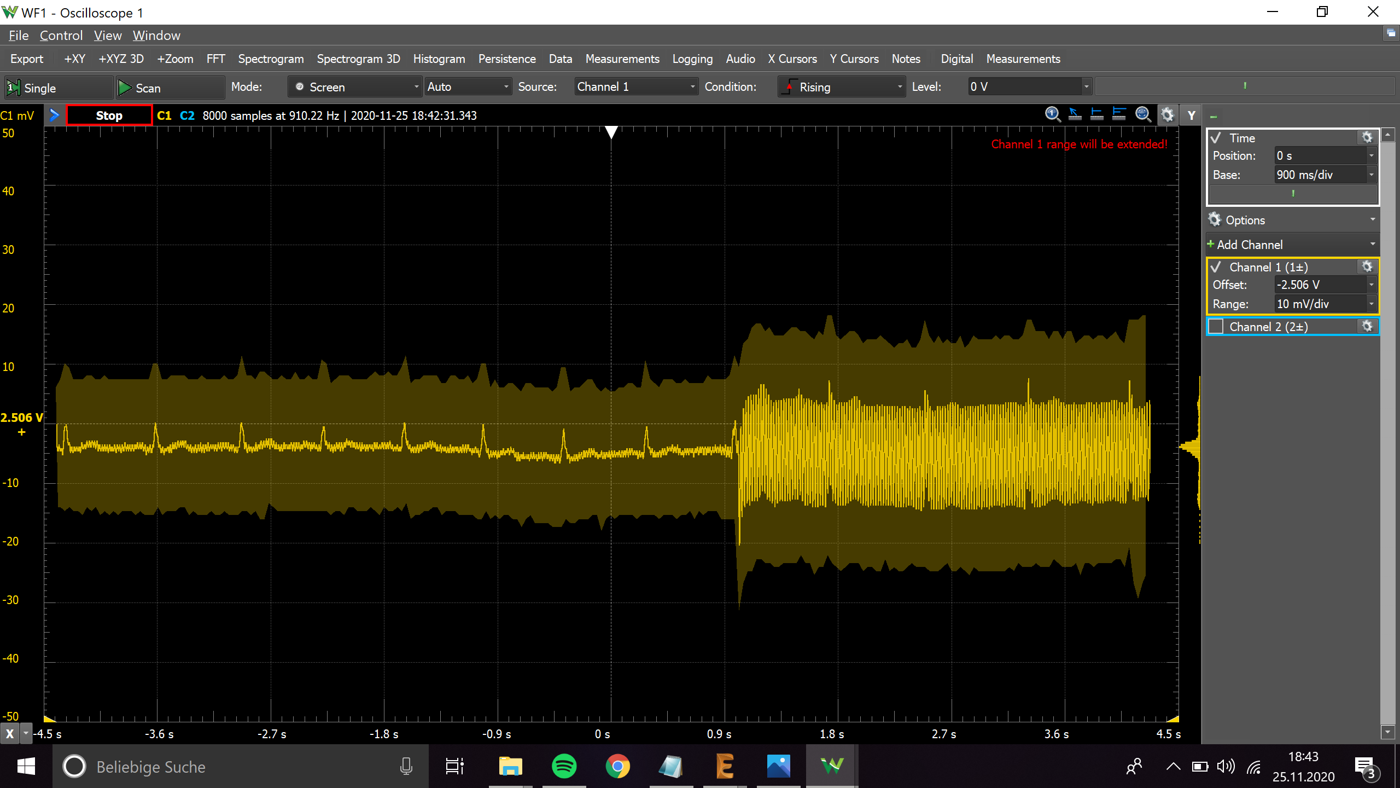
EMG/pics/Measurements/heartbeat.png
