pmamatis/The-Body-Synthesizer/EMG/pics/Measurements/heartbeat_3.png

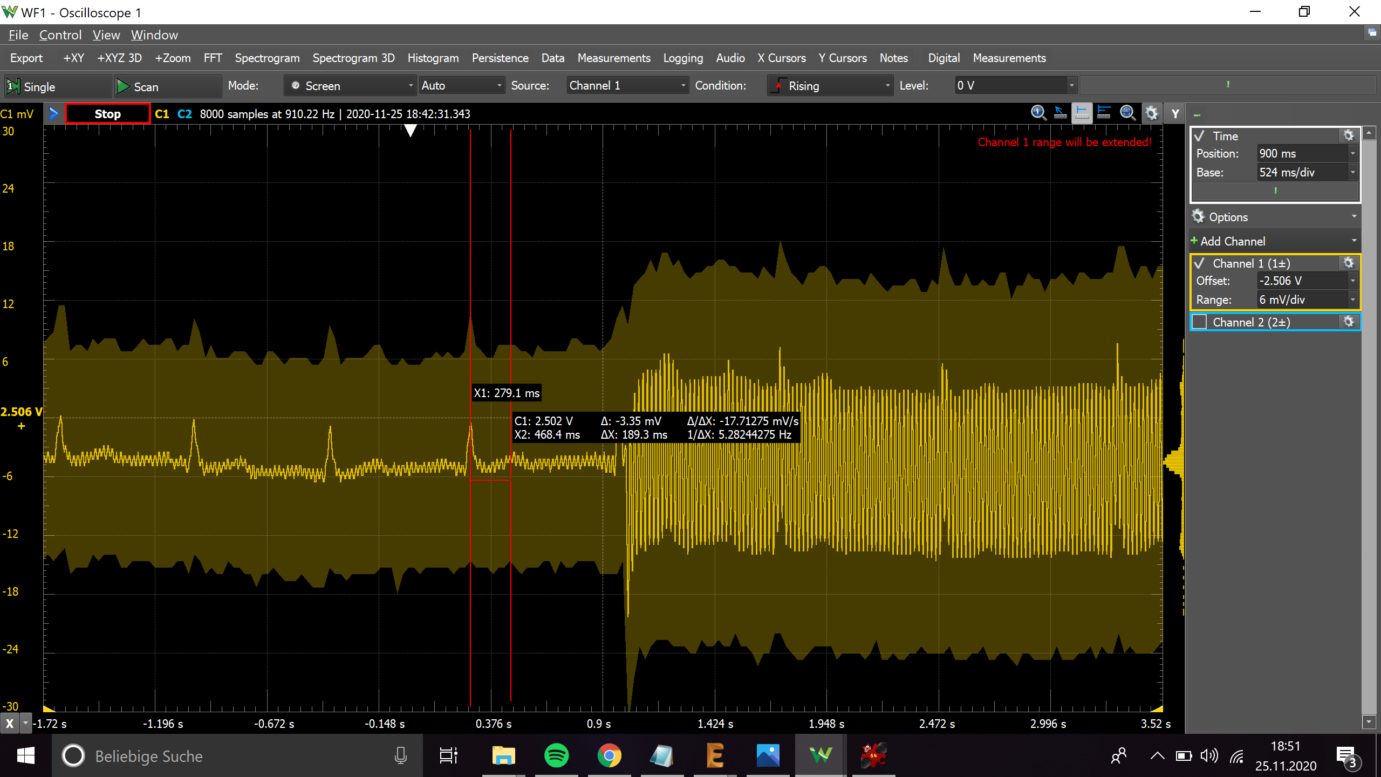
EMG/pics/Measurements/heartbeat_3.png
