pmamatis/The-Body-Synthesizer/EMG/pics/Measurements/heartbeat_dsp_1.png

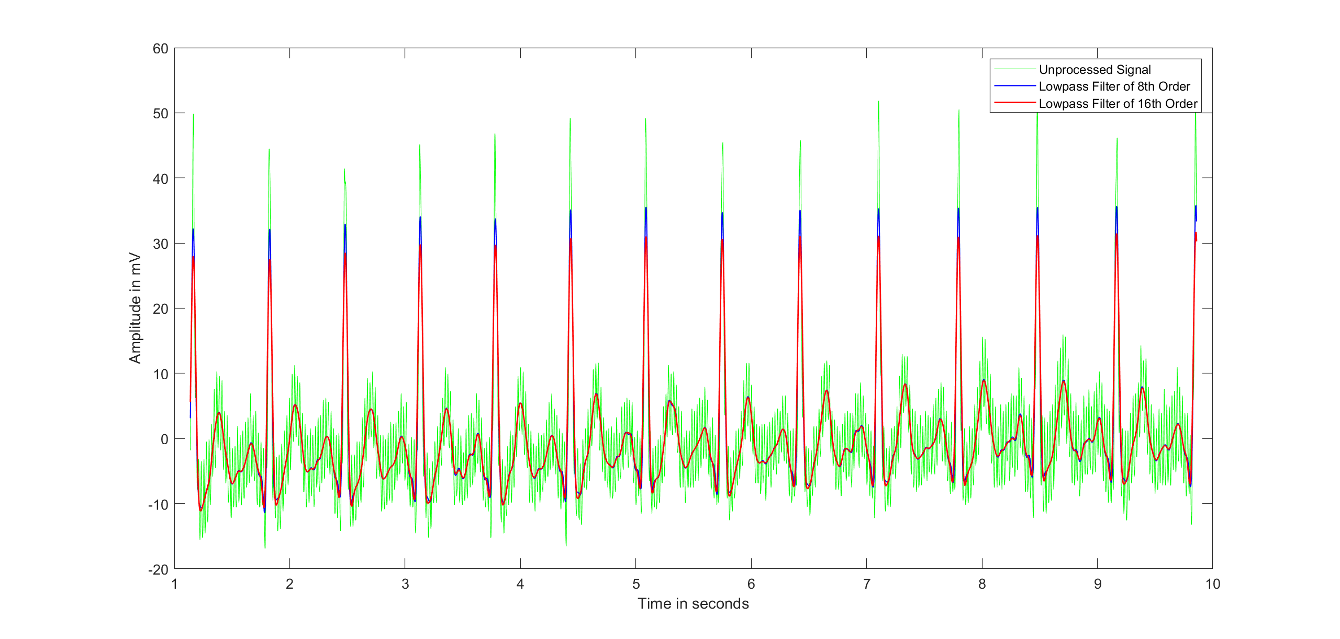
EMG/pics/Measurements/heartbeat_dsp_1.png
