pmamatis/The-Body-Synthesizer/EMG/pics/Measurements/heartbeat_dsp_2.png

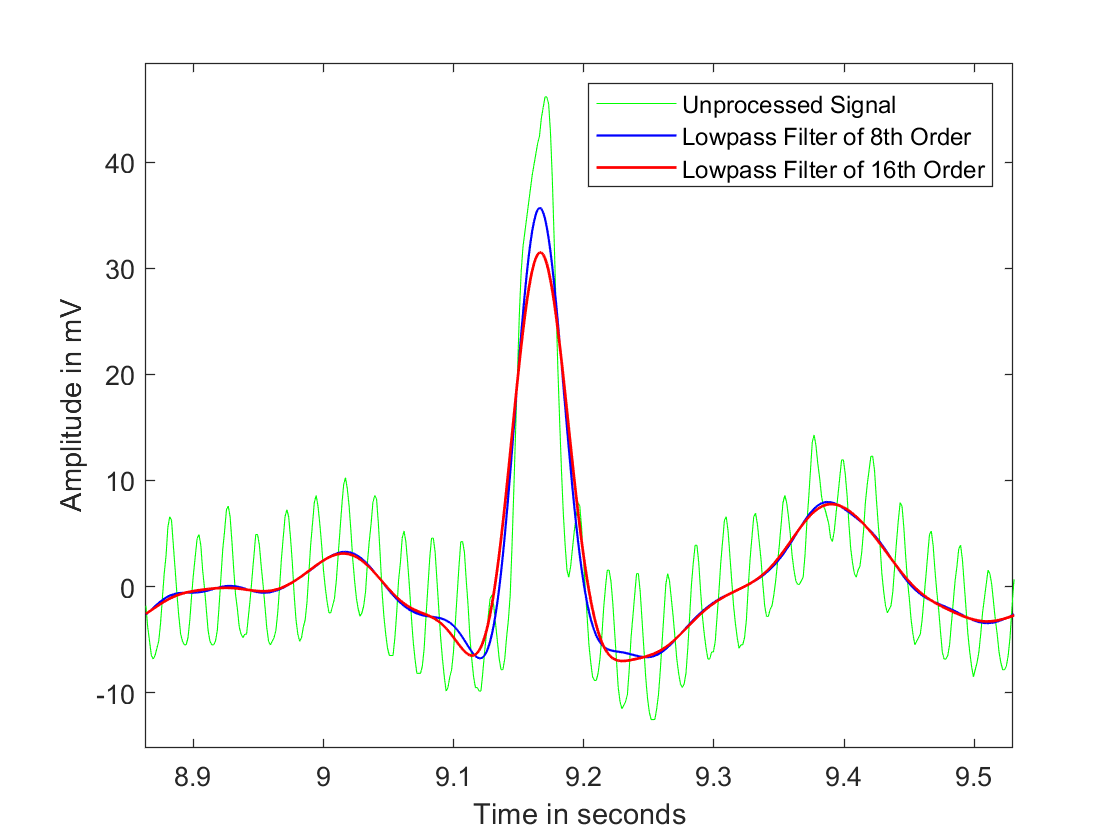
EMG/pics/Measurements/heartbeat_dsp_2.png
