pmamatis/The-Body-Synthesizer/EMG/pics/Measurements/heartbeat_lp2nd.png

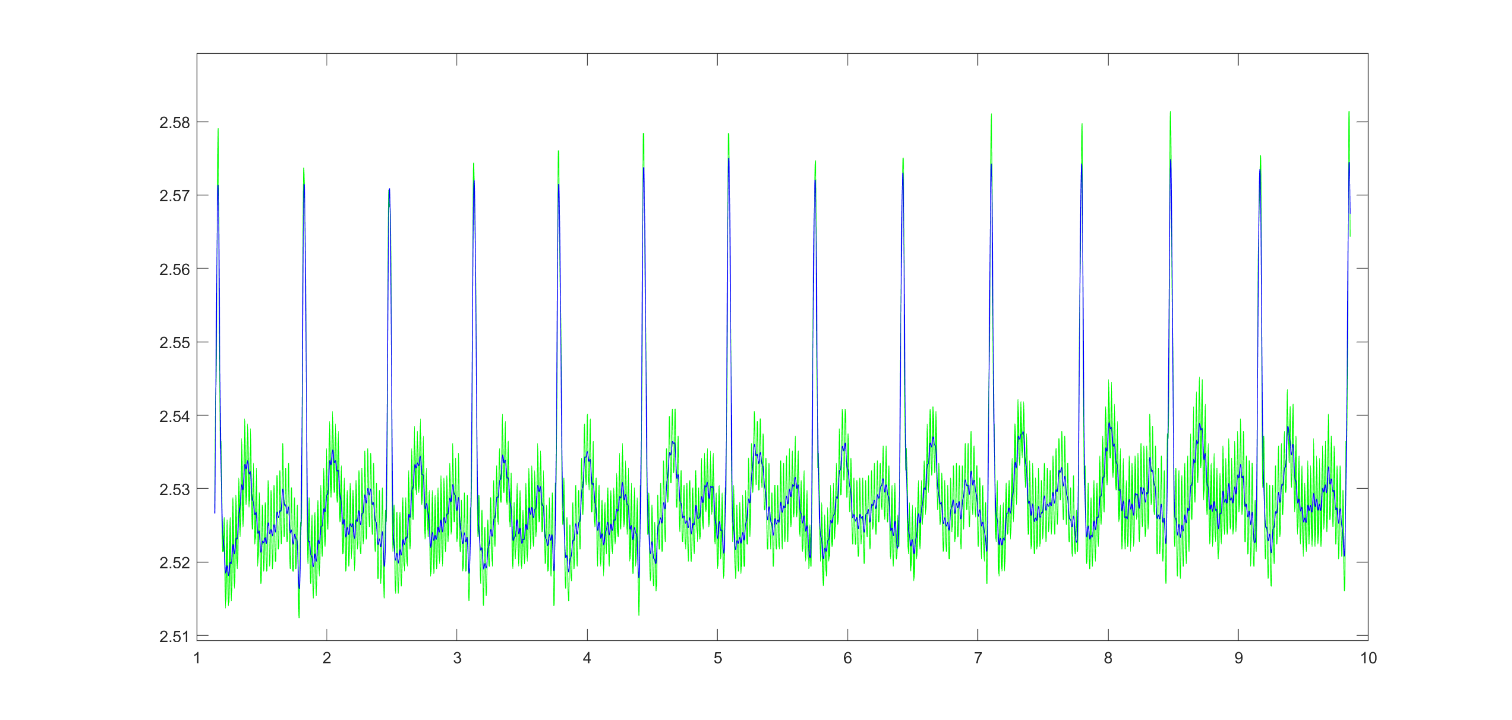
EMG/pics/Measurements/heartbeat_lp2nd.png
