pmamatis/The-Body-Synthesizer/EMG/pics/Measurements/heartbeat_lp2nd_2.png

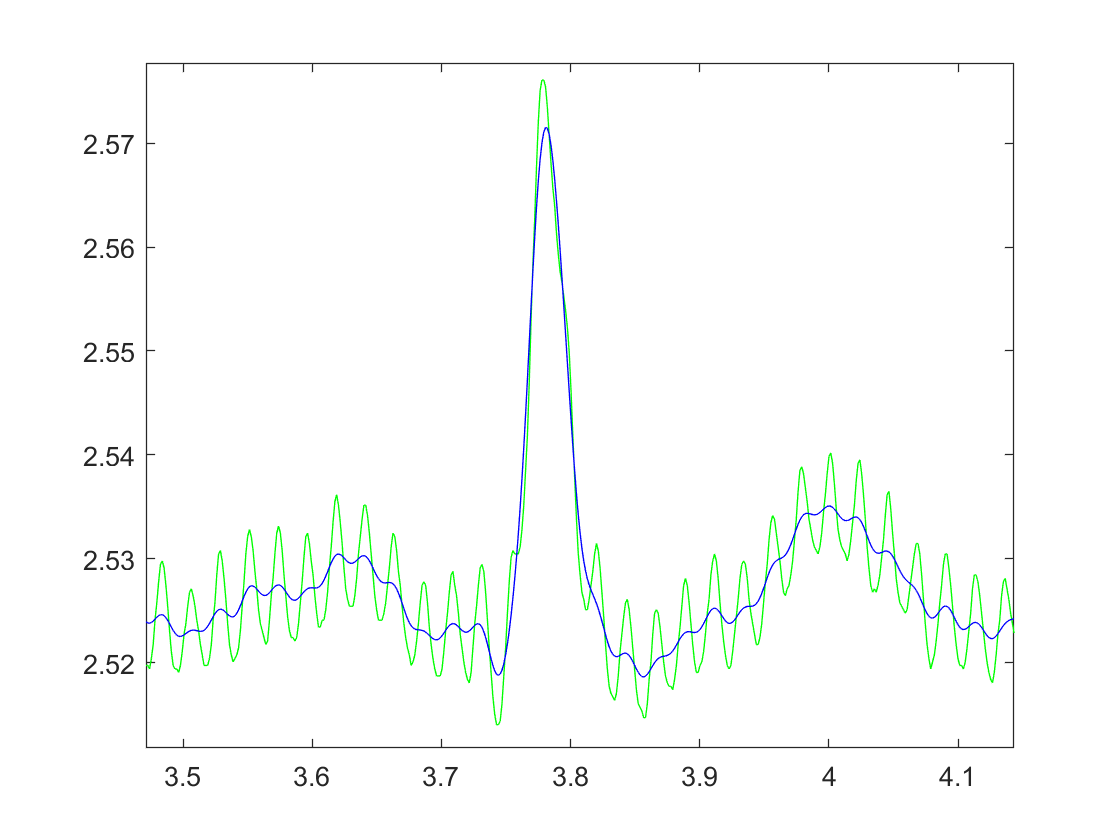
EMG/pics/Measurements/heartbeat_lp2nd_2.png
