pmamatis/The-Body-Synthesizer/EMG/pics/Measurements/heartbeat_lp16.png

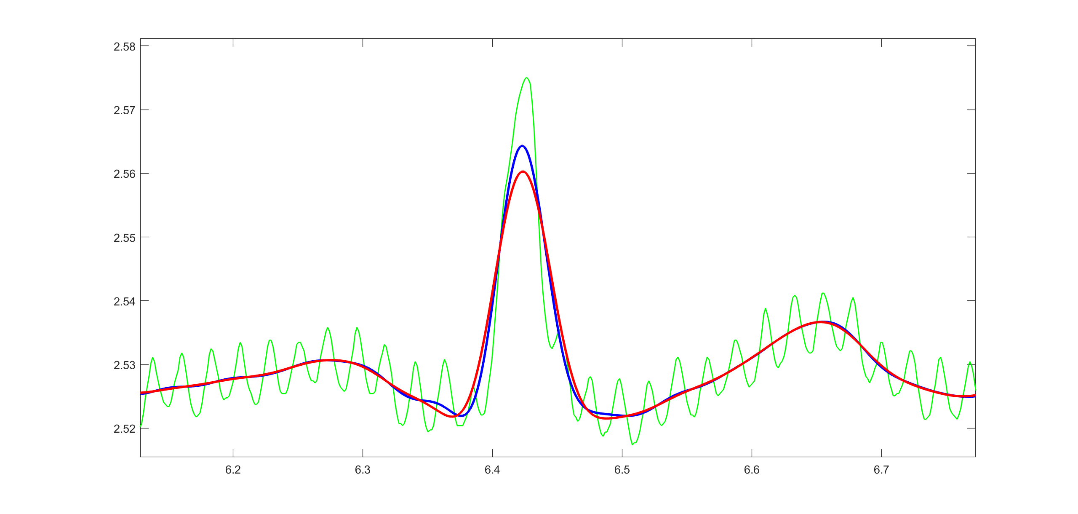
EMG/pics/Measurements/heartbeat_lp16.png
