pmamatis/The-Body-Synthesizer/EMG/pics/Measurements/Marco_nostress_1.png

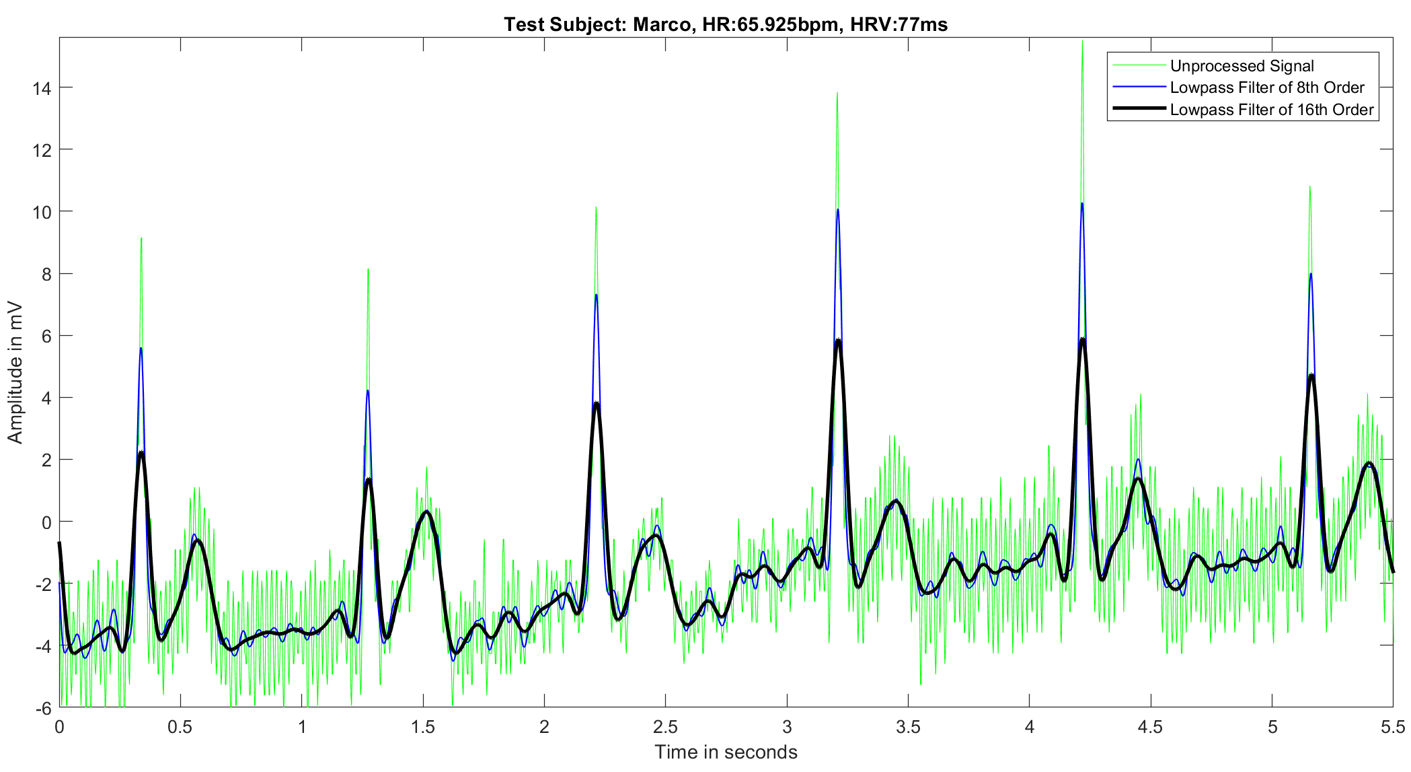
EMG/pics/Measurements/Marco_nostress_1.png
