pmamatis/The-Body-Synthesizer/EMG/pics/Measurements/Marco_nostress_2.png

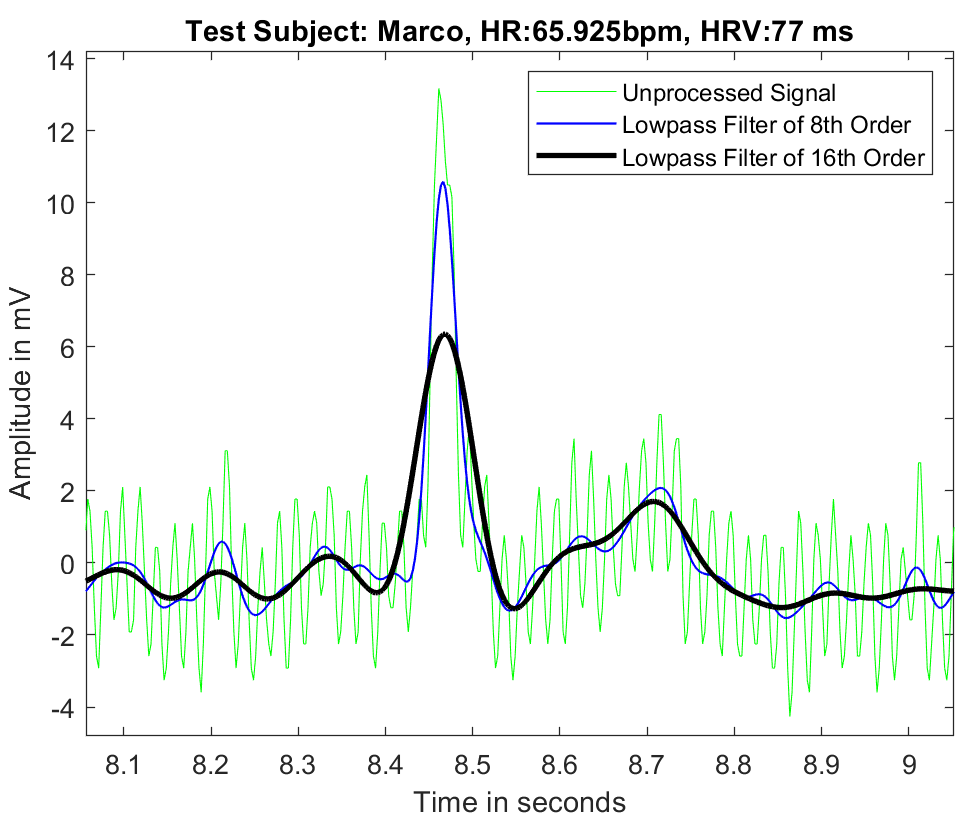
EMG/pics/Measurements/Marco_nostress_2.png
