pmamatis/The-Body-Synthesizer/EMG/pics/Measurements/mybeat.png

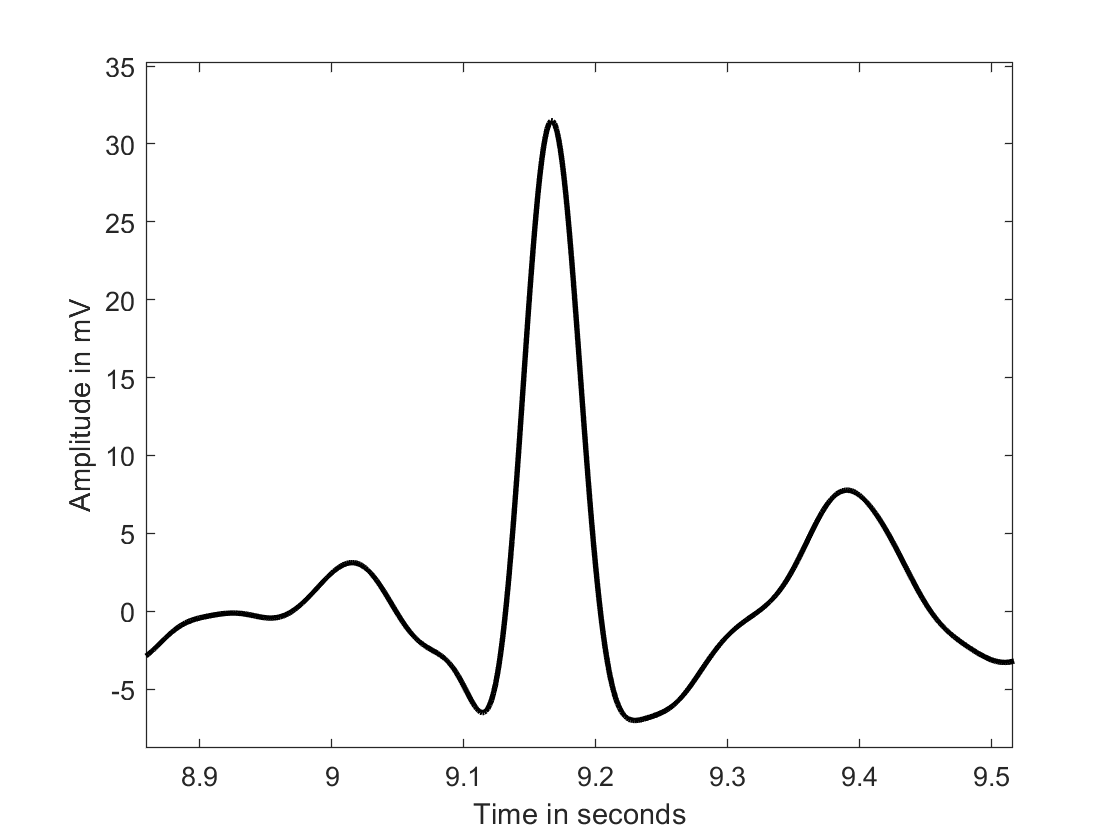
EMG/pics/Measurements/mybeat.png
