pmamatis/The-Body-Synthesizer/EQ + VU-Meter/DSP_Lab_SS21_Equalizer_VUMeter_fin.pdf

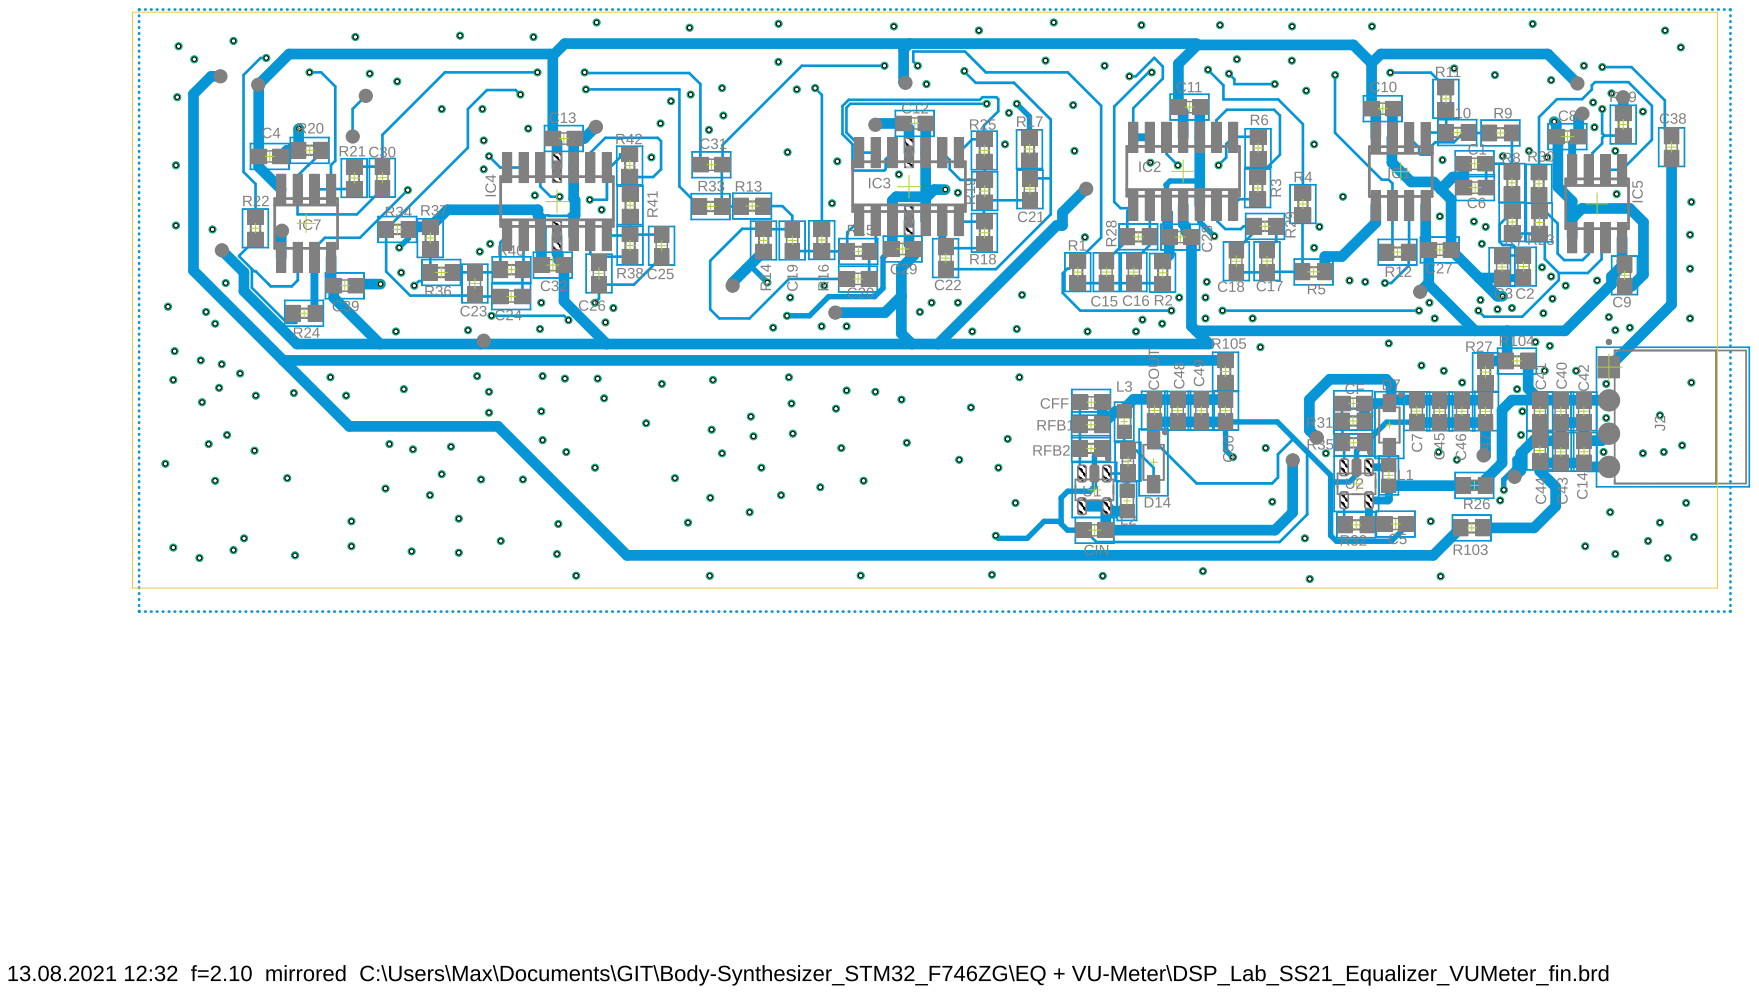
[picture p46: page 1]
