pmamatis/The-Body-Synthesizer/UI/Kicad/User_Interface_Board.kicad_pcb

## KiCad design UI/Kicad/User_Interface_Board.kicad_pcb (2021-06-28)

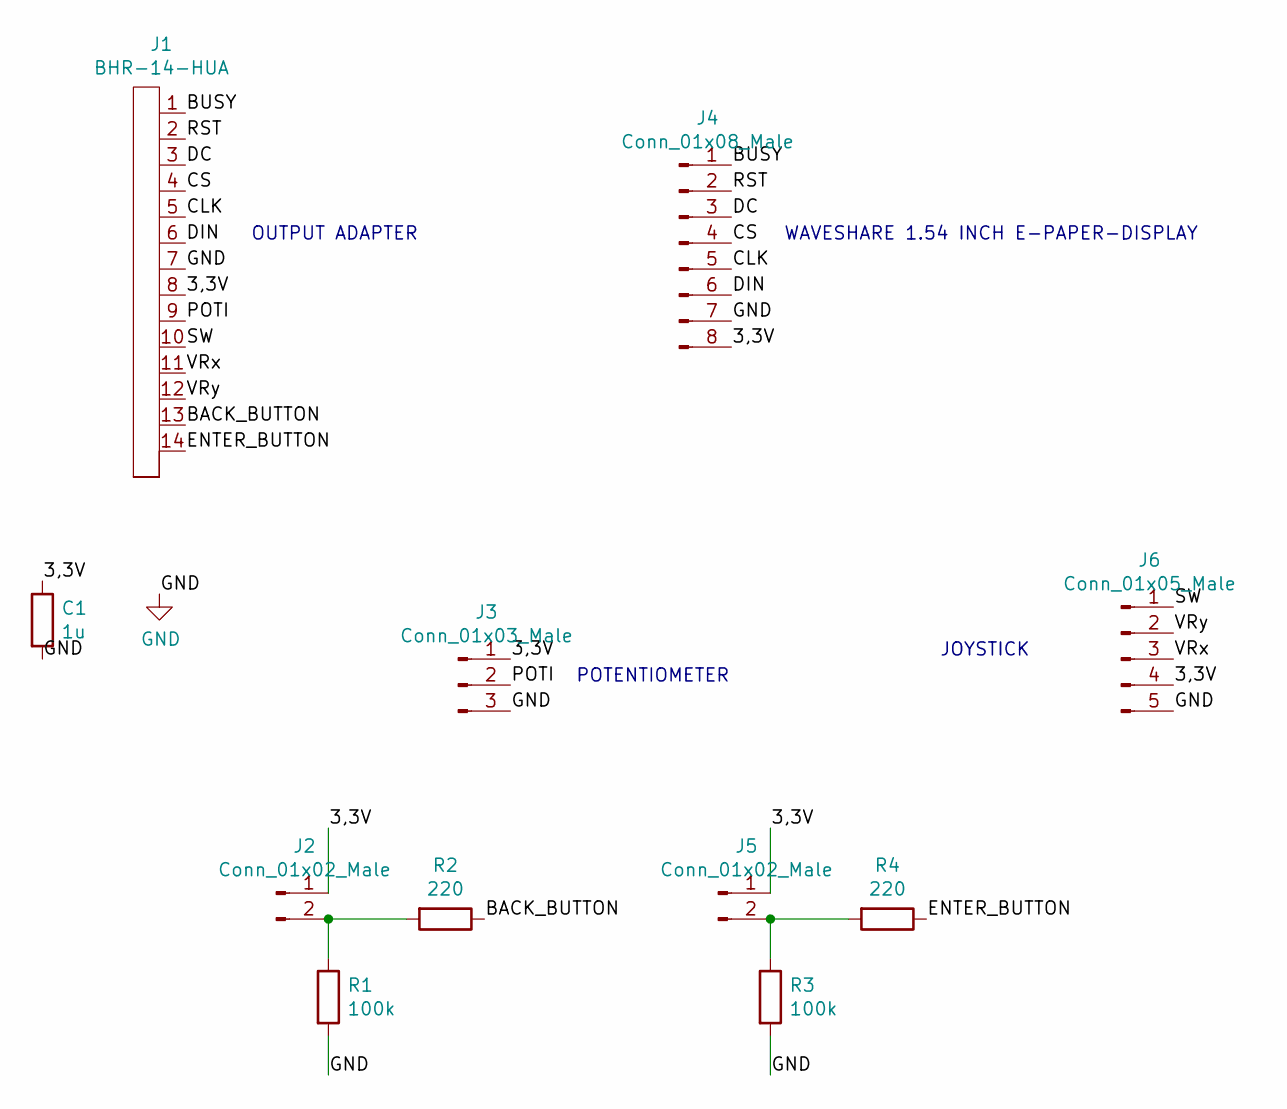
[picture p47: schematic User_Interface_Board.sch]

Parts:
C1: 1u; C_0805_2012Metric
J1: BHR-14-HUA
J2, J5: Conn_01x02_Male; PinHeader_1x02_P2.54mm_Vertical
J3: Conn_01x03_Male; PinHeader_1x03_P2.54mm_Vertical
J4: Conn_01x08_Male; PinSocket_1x08_P2.54mm_Vertical
J6: Conn_01x05_Male; PinSocket_1x05_P2.54mm_Vertical
R1, R3: 100k; R_0805_2012Metric
R2, R4: 220; R_0805_2012Metric

Connections:
/3,3V: C1.1, J1.8, J2.1, J3.1, J4.8, J5.1, J6.4
/BACK_BUTTON: J1.13, R2.1
/BUSY: J1.1, J4.1
/CLK: J1.5, J4.5
/CS: J1.4, J4.4
/DC: J1.3, J4.3
/DIN: J1.6, J4.6
/ENTER_BUTTON: J1.14, R4.1
/POTI: J1.9, J3.2
/RST: J1.2, J4.2
/SW: J1.10, J6.1
/VRx: J1.11, J6.3
/VRy: J1.12, J6.2
GND: C1.2, J1.7, J3.3, J4.7, J6.5, R1.2, R3.2
unnamed: J2.2, R1.1, R2.2
unnamed: J5.2, R3.1, R4.2

Notes on the sheet:
WAVESHARE 1.54 INCH E-PAPER-DISPLAY
JOYSTICK
POTENTIOMETER
OUTPUT ADAPTER

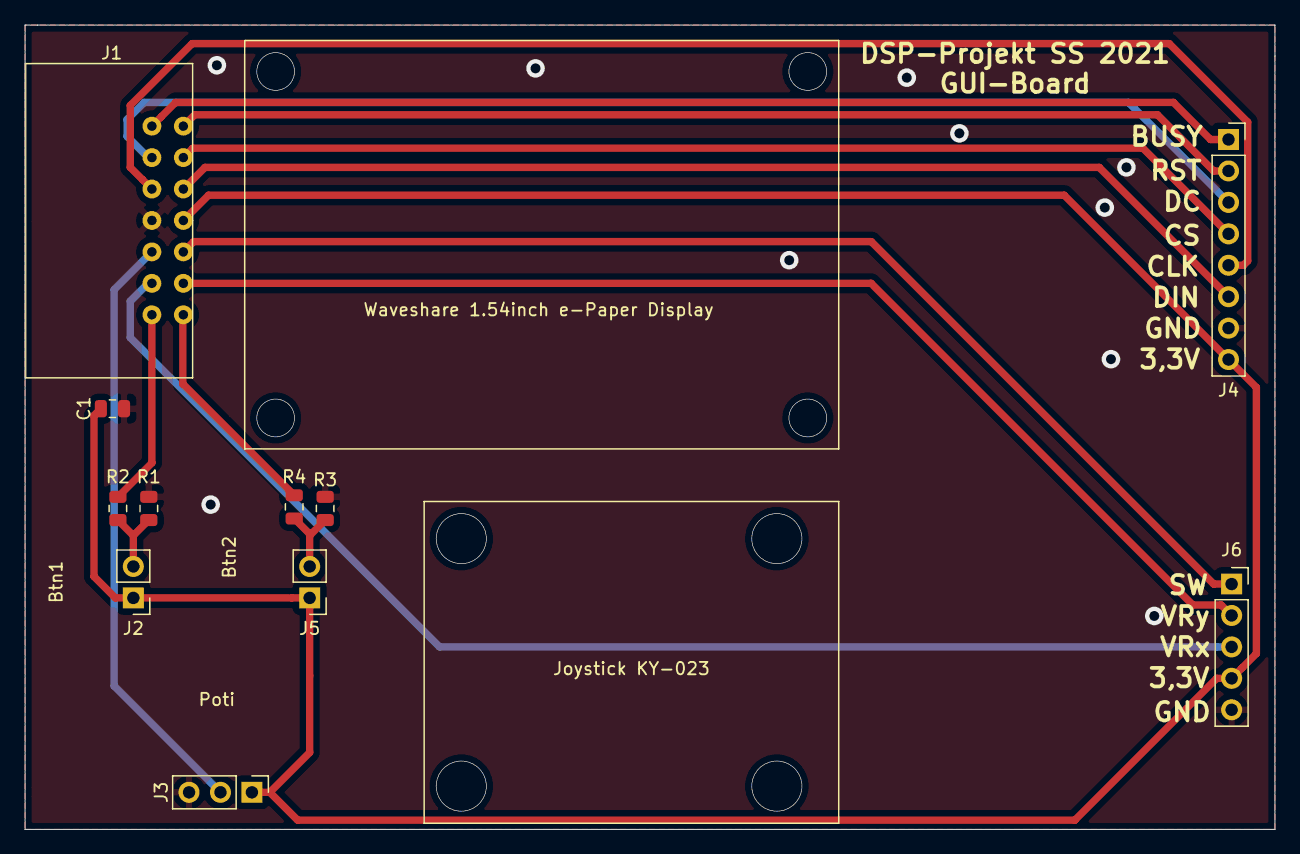
[picture p48: board User_Interface_Board.kicad_pcb from above]

Board: 2 copper layers, 101.0 x 65.0 mm, 11 parts (0 on the bottom side), 16 nets.
