pmamatis/The-Body-Synthesizer/EMG/EMG.brd

## EAGLE design EMG/EMG.brd (2021-09-02)

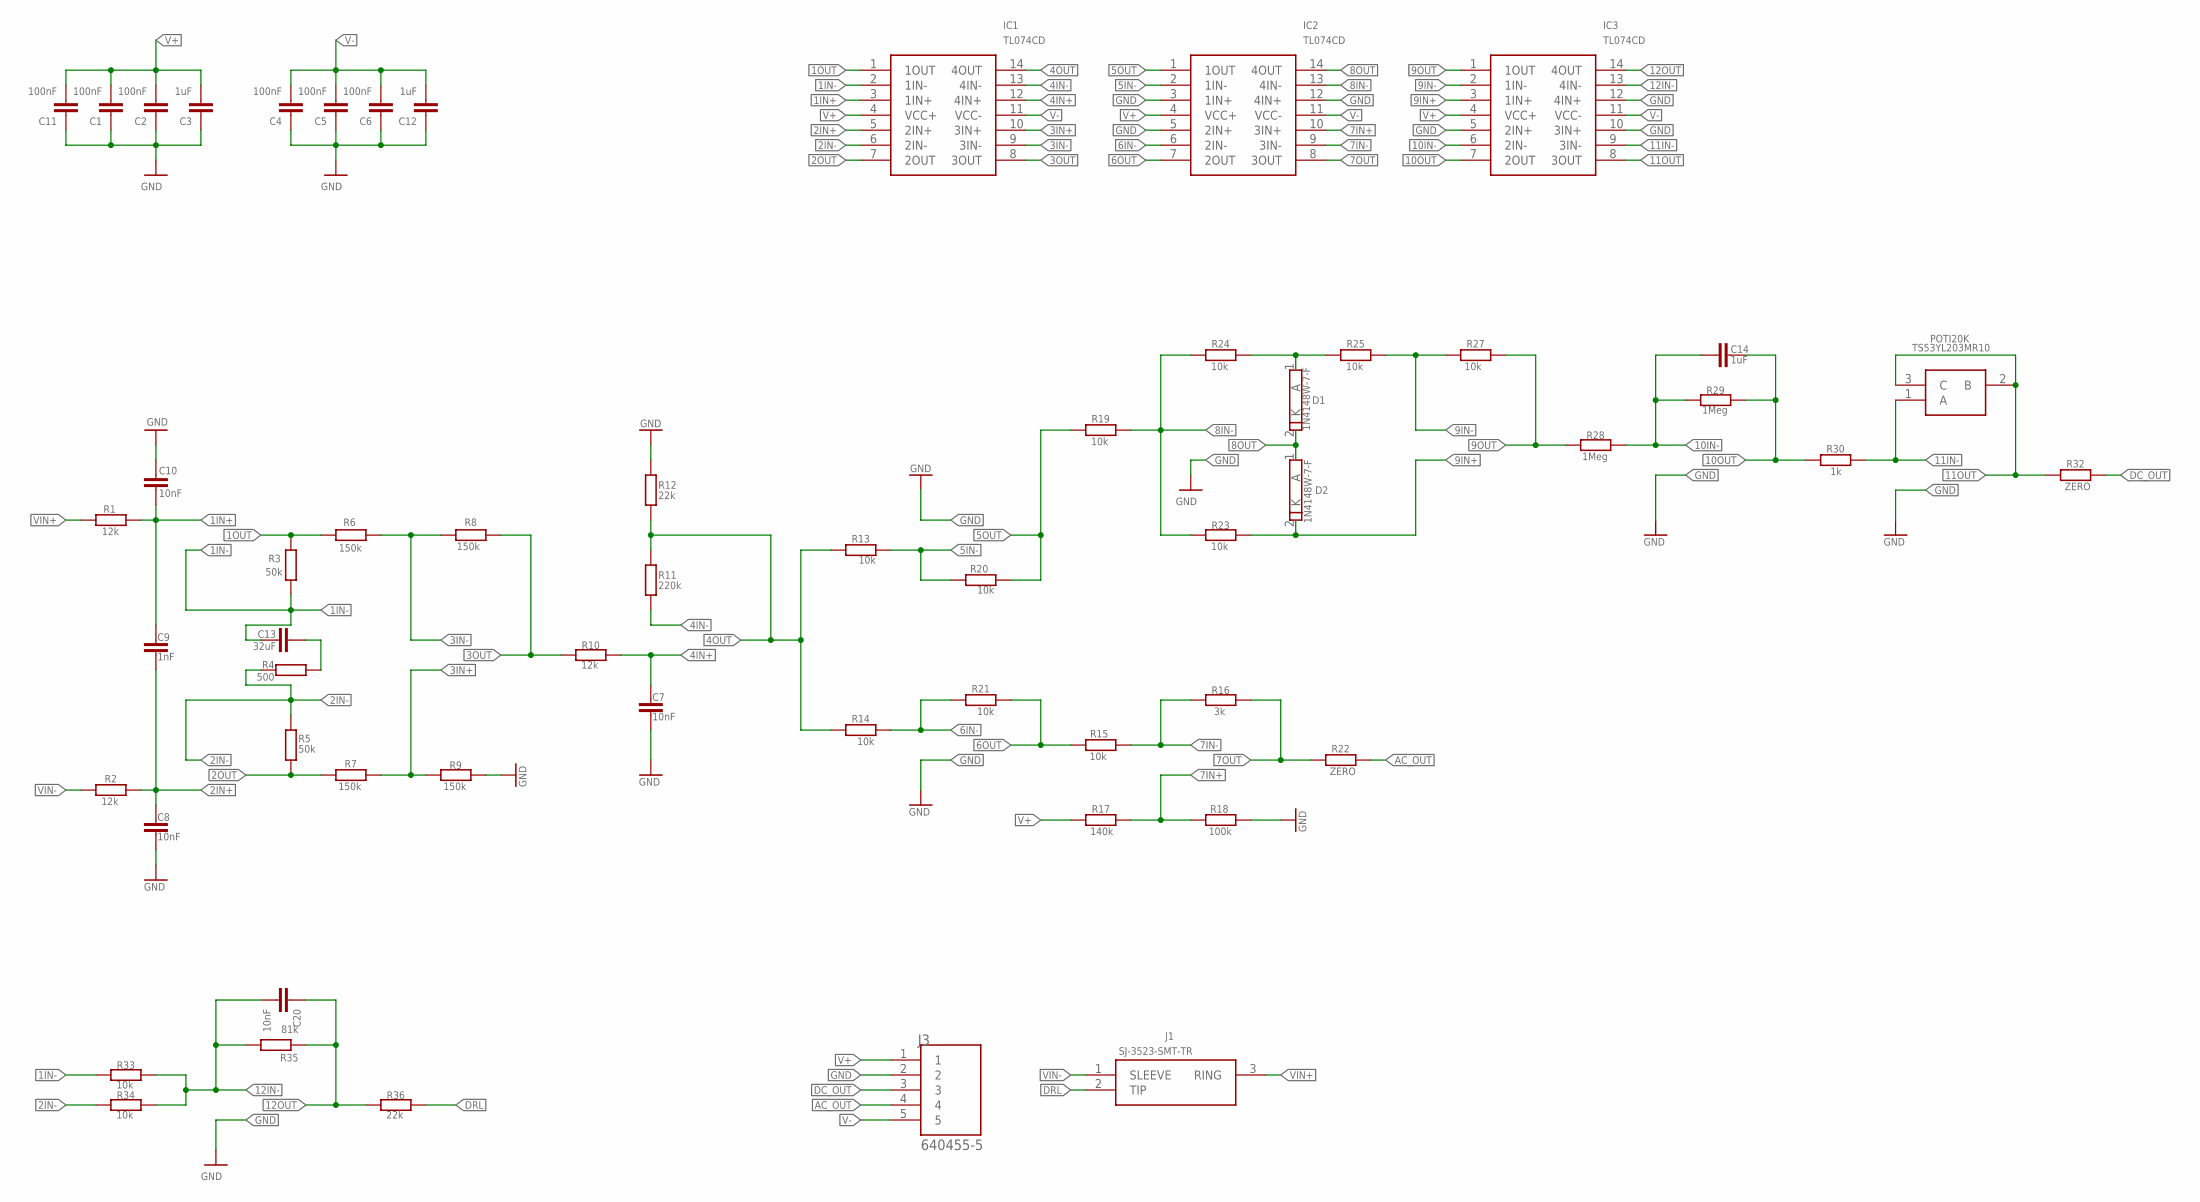
[picture p49: schematic EMG.sch]

Parts:
C1, C2, C4, C5, C6, C11: 100nF; C0603
C3, C12, C14: 1uF; C0603
C7, C8, C10, C20: 10nF; C0603
C9: 1nF; C0603
C13: 32uF; C0603
D1, D2: 1N4148W-7-F; SOD3716X115N
IC1, IC2, IC3: TL074CD; SOIC127P600X175-14N
J1: SJ-3523-SMT-TR; SJ3523SMTTR
J3: 640455-5; TE_640455-5
POTI20K: TS53YL203MR10
R1, R2, R10: 12k; R0603
R3, R5: 50k; R0603
R4: 500; R0603
R6, R7, R8, R9: 150k; R0603
R11: 220k; R0603
R12, R36: 22k; R0603
R13, R14, R15, R19, R20, R21, R23, R24, R25, R27, R33, R34: 10k; R0603
R16: 3k; R0603
R17: 140k; R0603
R18: 100k; R0603
R22, R32: ZERO; R0603
R28, R29: 1Meg; R0603
R30: 1k; R0603
R35: 81k; R0603

Connections:
1IN+: C9.1, C10.1, IC1.3 (1IN+), R1.2
1IN-: C13.1, IC1.2 (1IN-), R3.2, R33.2
1OUT: IC1.1 (1OUT), R3.1, R6.1
2IN+: C8.2, C9.2, IC1.5 (2IN+), R2.1
2IN-: IC1.6 (2IN-), R4.2, R5.1, R34.2
2OUT: IC1.7 (2OUT), R5.2, R7.2
3IN+: IC1.10 (3IN+), R7.1, R9.2
3IN-: IC1.9 (3IN-), R6.2, R8.2
3OUT: IC1.8 (3OUT), R8.1, R10.2
4IN+: C7.2, IC1.12 (4IN+), R10.1
4IN-: IC1.13 (4IN-), R11.2
4OUT: IC1.14 (4OUT), R11.1, R12.2, R13.2, R14.2
5IN-: IC2.2 (1IN-), R13.1, R20.2
5OUT: IC2.1 (1OUT), R19.2, R20.1
6IN-: IC2.6 (2IN-), R14.1, R21.2
6OUT: IC2.7 (2OUT), R15.2, R21.1
7IN+: IC2.10 (3IN+), R17.2, R18.1
7IN-: IC2.9 (3IN-), R15.1, R16.2
7OUT: IC2.8 (3OUT), R16.1, R22.2
8IN-: IC2.13 (4IN-), R19.1, R23.2, R24.2
8OUT: D1.2 (K), D2.1 (A), IC2.14 (4OUT)
9IN+: D2.2 (K), IC3.3 (1IN+), R23.1
9IN-: IC3.2 (1IN-), R25.1, R27.2
9OUT: IC3.1 (1OUT), R27.1, R28.2
10IN-: C14.1, IC3.6 (2IN-), R28.1, R29.2
10OUT: C14.2, IC3.7 (2OUT), R29.1, R30.2
11IN-: IC3.9 (3IN-), POTI20K.1 (A), R30.1
11OUT: IC3.8 (3OUT), POTI20K.2 (B), POTI20K.3 (C), R32.2
12IN-: C20.2, IC3.13 (4IN-), R33.1, R34.1, R35.2
12OUT: C20.1, IC3.14 (4OUT), R35.1, R36.2
AC_OUT: J3.4, R22.1
DC_OUT: J3.3, R32.1
DRL: J1.2 (TIP), R36.1
GND: C1.1, C2.1, C3.1, C4.1, C5.1, C6.1, C7.1, C8.1, C10.2, C11.1, C12.1, IC2.3 (1IN+), IC2.5 (2IN+), IC2.12 (4IN+), IC3.5 (2IN+), IC3.10 (3IN+), IC3.12 (4IN+), J3.2, R9.1, R12.1, R18.2
unnamed: D1.1 (A), R24.1, R25.2
unnamed: C13.2, R4.1
V+: C1.2, C2.2, C3.2, C11.2, IC1.4 (VCC+), IC2.4 (VCC+), IC3.4 (VCC+), J3.1, R17.1
V-: C4.2, C5.2, C6.2, C12.2, IC1.11 (VCC-), IC2.11 (VCC-), IC3.11 (VCC-), J3.5
VIN+: J1.3 (RING), R1.1
VIN-: J1.1 (SLEEVE), R2.2

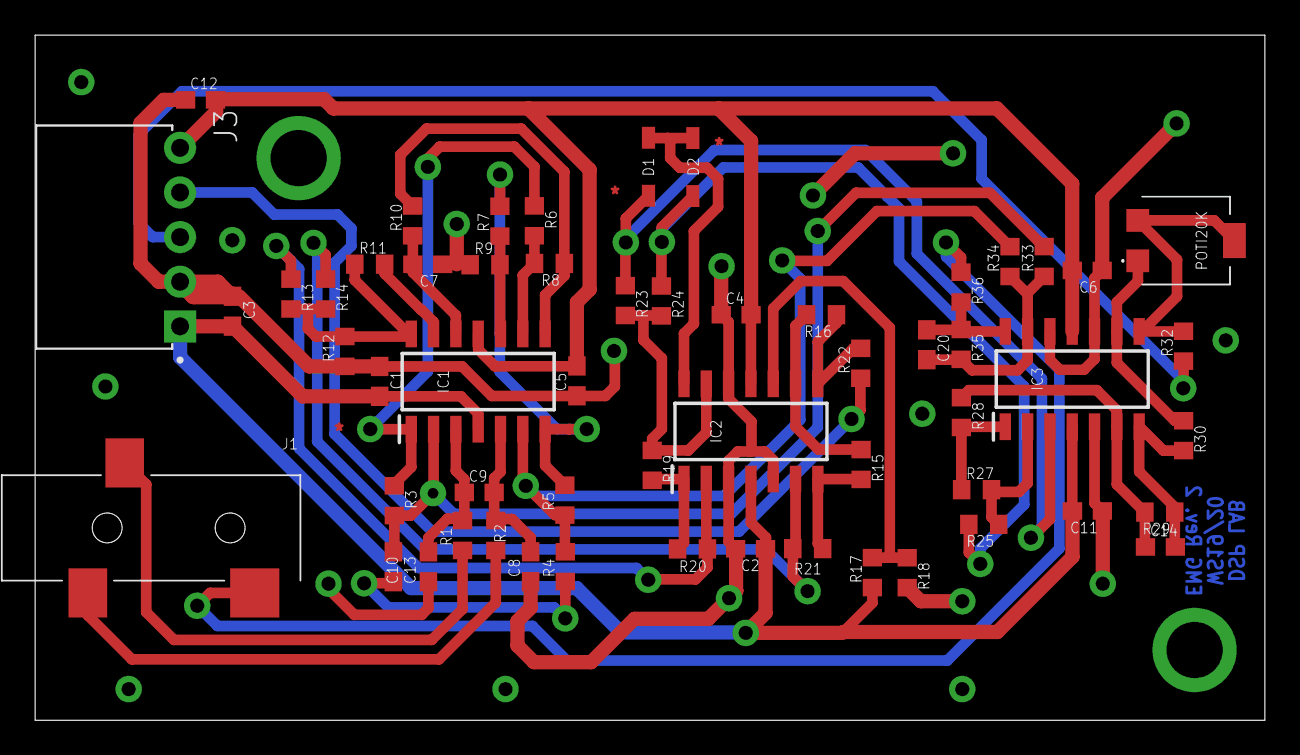
[picture p50: board EMG.brd from above]

Board: 2 copper layers, 70.0 x 39.0 mm, 57 parts (0 on the bottom side), 40 nets.
