pmamatis/The-Body-Synthesizer/Mainboard/DSP_Lab_SS21_Mainboard.brd

## EAGLE design Mainboard/DSP_Lab_SS21_Mainboard.brd (2021-09-02)

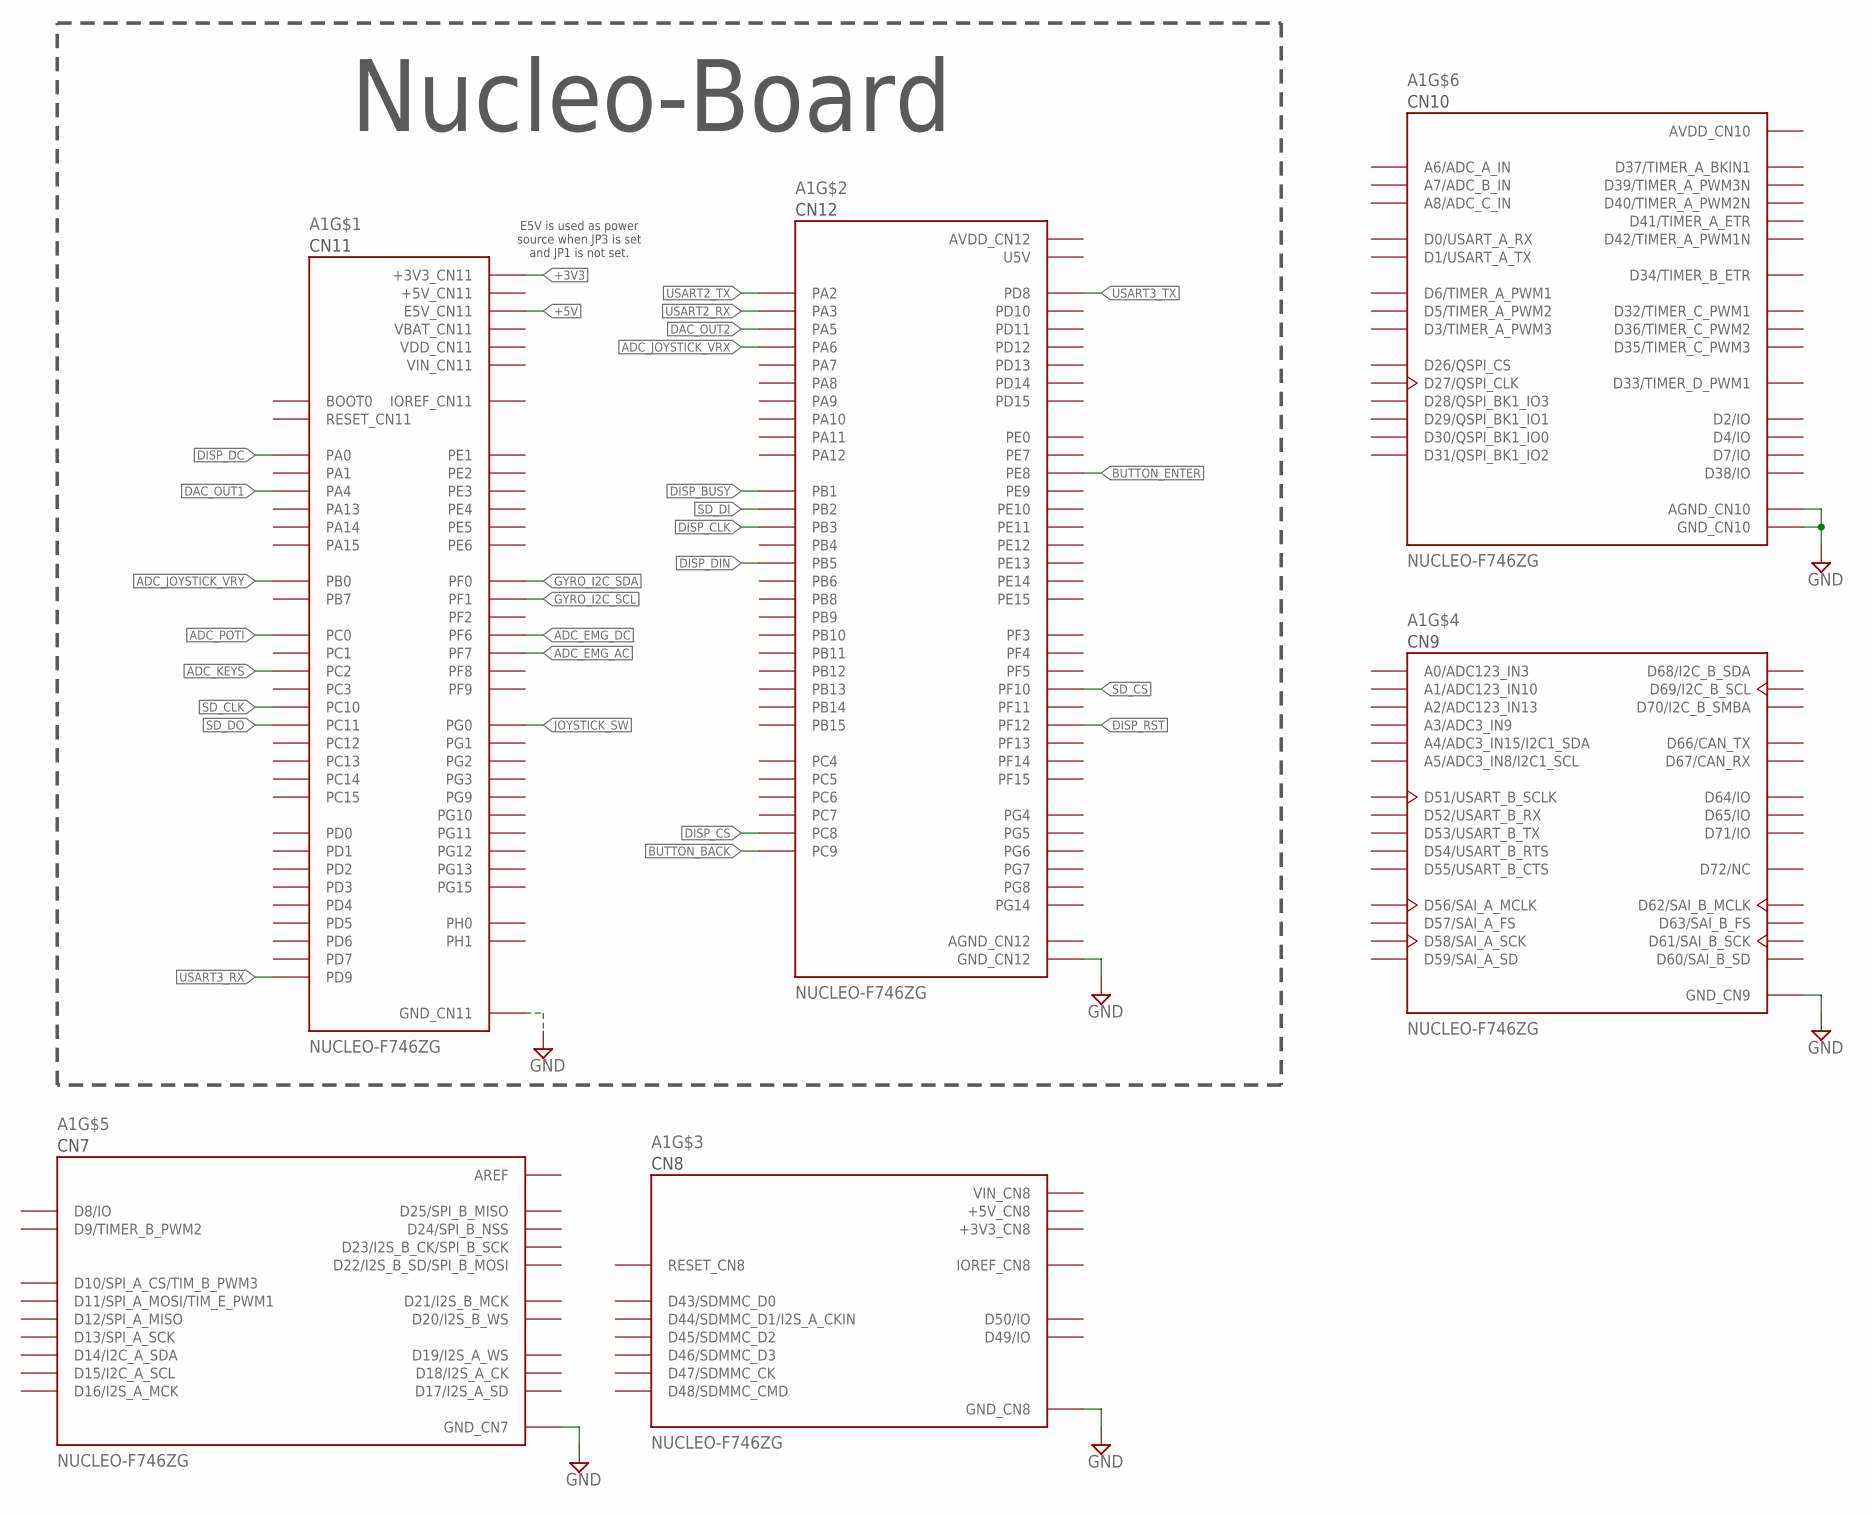
[picture p51: schematic DSP_Lab_SS21_Mainboard.sch, sheet 1]

Parts:
A1: NUCLEO-F746ZG; MODULE_NUCLEO-F746ZG

Connections:
+3V3: A1.CN11_16 (+3V3_CN11); also elsewhere on the board
+3V3_CN8: A1.CN8_7 (+3V3_CN8)
+5V: A1.CN11_6 (E5V_CN11); also elsewhere on the board
+5V_CN8: A1.CN8_9 (+5V_CN8)
+5V_CN11: A1.CN11_18 (+5V_CN11)
ADC_EMG_AC: A1.CN11_11 (PF7); also elsewhere on the board
ADC_EMG_DC: A1.CN11_9 (PF6); also elsewhere on the board
ADC_JOYSTICK_VRX: A1.CN12_13 (PA6); also elsewhere on the board
ADC_JOYSTICK_VRY: A1.CN11_34 (PB0); also elsewhere on the board
ADC_KEYS: A1.CN11_35 (PC2); also elsewhere on the board
ADC_POTI: A1.CN11_38 (PC0); also elsewhere on the board
AGND_CN12: A1.CN12_32 (AGND_CN12)
AREF: A1.CN7_6 (AREF)
AVDD_CN10: A1.CN10_1 (AVDD_CN10)
AVDD_CN12: A1.CN12_7 (AVDD_CN12)
BUTTON_BACK: A1.CN12_1 (PC9); also elsewhere on the board
BUTTON_ENTER: A1.CN12_40 (PE8); also elsewhere on the board
DAC_OUT1: A1.CN11_32 (PA4); also elsewhere on the board
DAC_OUT2: A1.CN12_11 (PA5); also elsewhere on the board
DISP_BUSY: A1.CN12_24 (PB1); also elsewhere on the board
DISP_CLK: A1.CN12_31 (PB3); also elsewhere on the board
DISP_CS: A1.CN12_2 (PC8); also elsewhere on the board
DISP_DC: A1.CN11_28 (PA0); also elsewhere on the board
DISP_DIN: A1.CN12_29 (PB5); also elsewhere on the board
DISP_RST: A1.CN12_59 (PF12); also elsewhere on the board
GND: A1.CN7_8 (GND_CN7), A1.CN8_11 (GND_CN8), A1.CN8_13 (GND_CN8), A1.CN9_12 (GND_CN9), A1.CN9_23 (GND_CN9), A1.CN10_3 (AGND_CN10), A1.CN10_5 (GND_CN10), A1.CN10_17 (GND_CN10), A1.CN10_22 (GND_CN10), A1.CN10_27 (GND_CN10), A1.CN11_8 (GND_CN11), A1.CN11_19 (GND_CN11), A1.CN11_20 (GND_CN11), A1.CN11_22 (GND_CN11), A1.CN11_49 (GND_CN11), A1.CN11_60 (GND_CN11), A1.CN11_71 (GND_CN11), A1.CN11_72 (GND_CN11), A1.CN12_9 (GND_CN12), A1.CN12_20 (GND_CN12), A1.CN12_39 (GND_CN12), A1.CN12_54 (GND_CN12), A1.CN12_63 (GND_CN12), A1.CN12_71 (GND_CN12), A1.CN12_72 (GND_CN12); also elsewhere on the board
GYRO_I2C_SCL: A1.CN11_51 (PF1); also elsewhere on the board
GYRO_I2C_SDA: A1.CN11_53 (PF0); also elsewhere on the board
JOYSTICK_SW: A1.CN11_59 (PG0); also elsewhere on the board
SD_CLK: A1.CN11_1 (PC10); also elsewhere on the board
SD_CS: A1.CN12_42 (PF10); also elsewhere on the board
SD_DI: A1.CN12_22 (PB2); also elsewhere on the board
SD_DO: A1.CN11_2 (PC11); also elsewhere on the board
U5V: A1.CN12_8 (U5V)
USART2_RX: A1.CN12_37 (PA3)
USART2_TX: A1.CN12_35 (PA2)
USART3_RX: A1.CN11_69 (PD9)
USART3_TX: A1.CN12_10 (PD8)
VBAT_CN11: A1.CN11_33 (VBAT_CN11)
VDD_CN11: A1.CN11_5 (VDD_CN11)
VIN_CN8: A1.CN8_15 (VIN_CN8)
VIN_CN11: A1.CN11_24 (VIN_CN11)

Notes on the sheet:
Nucleo-Board
E5V is used as power source when JP3 is set and JP1 is not set.

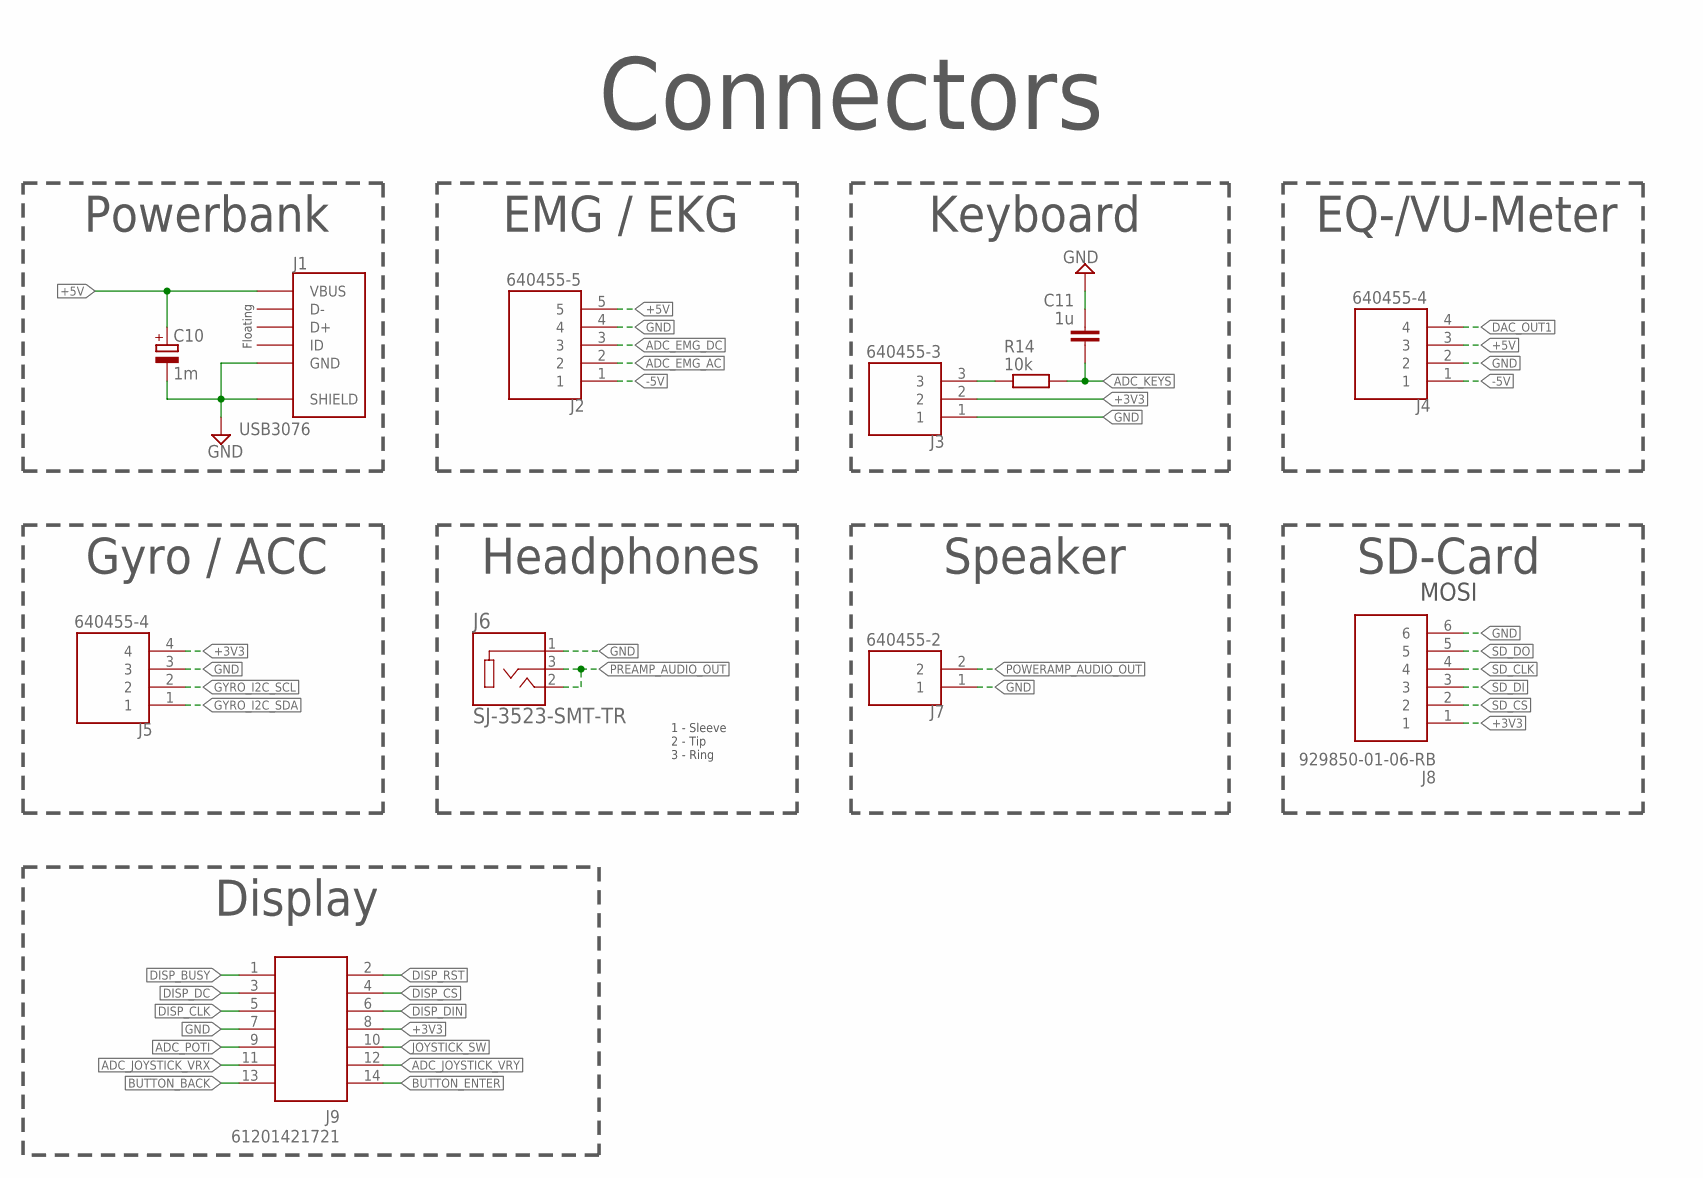
[picture p52: schematic DSP_Lab_SS21_Mainboard.sch, sheet 2]

Parts:
C10: 1m; E2,5-5
C11: 1u; C0603
J1: USB3076; GCT_USB3076-XX-X_REVC
J2: 640455-5; TE_640455-5
J3: 640455-3; TE_640455-3
J4, J5: 640455-4; TE_640455-4
J6: SJ-3523-SMT-TR; CUI_SJ-3523-SMT-TR
J7: 640455-2; TE_640455-2
J8: 929850-01-06-RB; RHDR6W76P0X254_1X6_1524X254X82
J9: 61201421721
R14: 10k; R0603

Connections:
+3V3: J3.2, J5.4, J8.1, J9.8; also elsewhere on the board
+5V: C10.+, J1.1 (VBUS), J2.5, J4.3; also elsewhere on the board
-5V: J2.1, J4.1; also elsewhere on the board
ADC_EMG_AC: J2.2; also elsewhere on the board
ADC_EMG_DC: J2.3; also elsewhere on the board
ADC_JOYSTICK_VRX: J9.11; also elsewhere on the board
ADC_JOYSTICK_VRY: J9.12; also elsewhere on the board
ADC_KEYS: C11.1, R14.2; also elsewhere on the board
ADC_POTI: J9.9; also elsewhere on the board
BUTTON_BACK: J9.13; also elsewhere on the board
BUTTON_ENTER: J9.14; also elsewhere on the board
DAC_OUT1: J4.4; also elsewhere on the board
DISP_BUSY: J9.1; also elsewhere on the board
DISP_CLK: J9.5; also elsewhere on the board
DISP_CS: J9.4; also elsewhere on the board
DISP_DC: J9.3; also elsewhere on the board
DISP_DIN: J9.6; also elsewhere on the board
DISP_RST: J9.2; also elsewhere on the board
GND: C10.-, C11.2, J1.5 (GND), J1.6 (SHIELD), J1.7 (SHIELD), J1.8 (SHIELD), J1.9 (SHIELD), J1.10 (SHIELD), J1.11 (SHIELD), J2.4, J3.1, J4.2, J5.3, J6.1, J7.1, J8.6, J9.7; also elsewhere on the board
GYRO_I2C_SCL: J5.2; also elsewhere on the board
GYRO_I2C_SDA: J5.1; also elsewhere on the board
JOYSTICK_SW: J9.10; also elsewhere on the board
unnamed: J3.3, R14.1
POWERAMP_AUDIO_OUT: J7.2; also elsewhere on the board
PREAMP_AUDIO_OUT: J6.2, J6.3; also elsewhere on the board
SD_CLK: J8.4; also elsewhere on the board
SD_CS: J8.2; also elsewhere on the board
SD_DI: J8.3; also elsewhere on the board
SD_DO: J8.5; also elsewhere on the board

Notes on the sheet:
Floating
Connectors
Powerbank
Display
EMG / EKG
Keyboard
EQ-/VU-Meter
Gyro / ACC
Headphones
Speaker
SD-Card
1 - Sleeve 2 - Tip 3 - Ring
MOSI

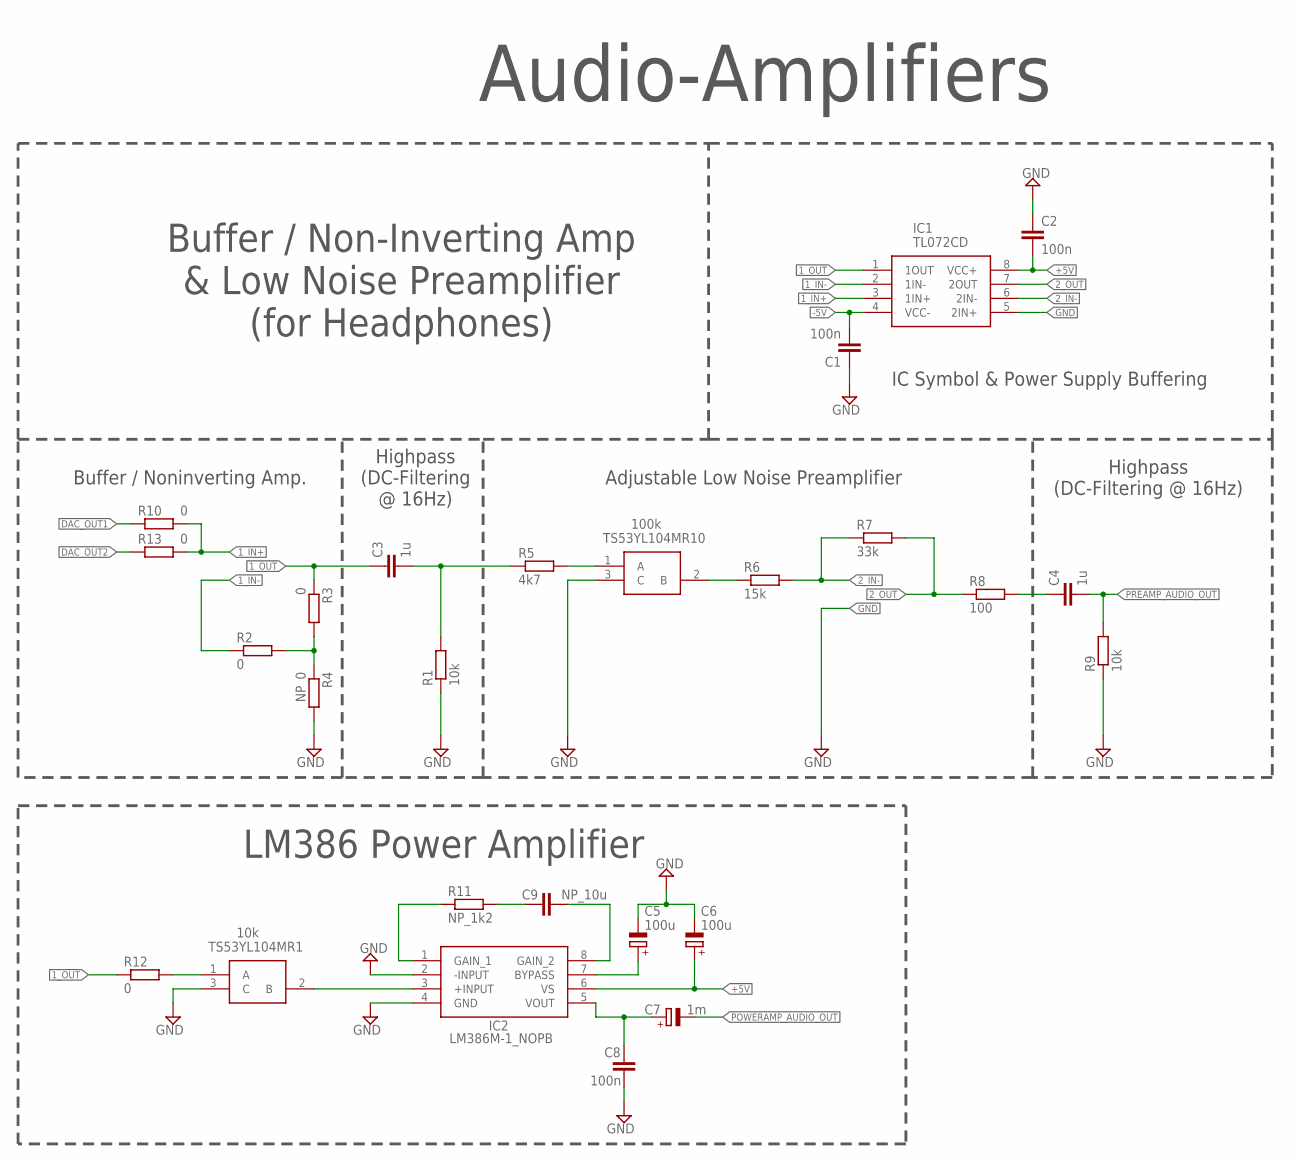
[picture p53: schematic DSP_Lab_SS21_Mainboard.sch, sheet 3]

Parts:
C1, C2, C8: 100n; C0603
C3, C4: 1u; C0603
C5, C6: 100u; E2,5-5
C7: 1m; E2,5-5
C9: NP_10u; C0603
IC1: TL072CD; SOIC127P600X175-8N
IC2: LM386M-1_NOPB; SOIC127P600X175-8N
R1, R9: 10k; R0603
R2, R3, R10, R12, R13: 0; R0603
R4: NP_0; R0603
R5: 4k7; R0603
R6: 15k; R0603
R7: 33k; R0603
R8: 100; R0603
R11: NP_1k2; R0603
TS53YL104MR1: 10k; TS53YL203MR10
TS53YL104MR10: 100k; TS53YL203MR10

Connections:
1_IN+: IC1.3 (1IN+), R10.2, R13.2
1_IN-: IC1.2 (1IN-), R2.1
1_OUT: C3.1, IC1.1 (1OUT), R3.1, R12.1
2_IN-: IC1.6 (2IN-), R6.2, R7.1
2_OUT: IC1.7 (2OUT), R7.2, R8.1
+5V: C2.2, C6.+, IC1.8 (VCC+), IC2.6 (VS); also elsewhere on the board
-5V: C1.2, IC1.4 (VCC-); also elsewhere on the board
DAC_OUT1: R10.1; also elsewhere on the board
DAC_OUT2: R13.1; also elsewhere on the board
GND: C1.1, C2.1, C5.-, C6.-, C8.2, IC1.5 (2IN+), IC2.2 (-INPUT), IC2.4 (GND), R1.1, R4.2, R9.1, TS53YL104MR1.3 (C), TS53YL104MR10.3 (C); also elsewhere on the board
unnamed: C3.2, R1.2, R5.1
unnamed: R2.2, R3.2, R4.1
unnamed: R5.2, TS53YL104MR10.1 (A)
unnamed: R6.1, TS53YL104MR10.2 (B)
unnamed: C4.1, R8.2
unnamed: IC2.1 (GAIN_1), R11.1
unnamed: IC2.3 (+INPUT), TS53YL104MR1.2 (B)
unnamed: C9.1, R11.2
unnamed: C9.2, IC2.8 (GAIN_2)
unnamed: R12.2, TS53YL104MR1.1 (A)
unnamed: C5.+, IC2.7 (BYPASS)
unnamed: C7.+, C8.1, IC2.5 (VOUT)
POWERAMP_AUDIO_OUT: C7.-; also elsewhere on the board
PREAMP_AUDIO_OUT: C4.2, R9.2; also elsewhere on the board

Notes on the sheet:
Audio-Amplifiers
Buffer / Non-Inverting Amp & Low Noise Preamplifier (for Headphones)
Highpass (DC-Filtering @ 16Hz)
Highpass (DC-Filtering @ 16Hz)
Buffer / Noninverting Amp.
Adjustable Low Noise Preamplifier
IC Symbol & Power Supply Buffering
LM386 Power Amplifier

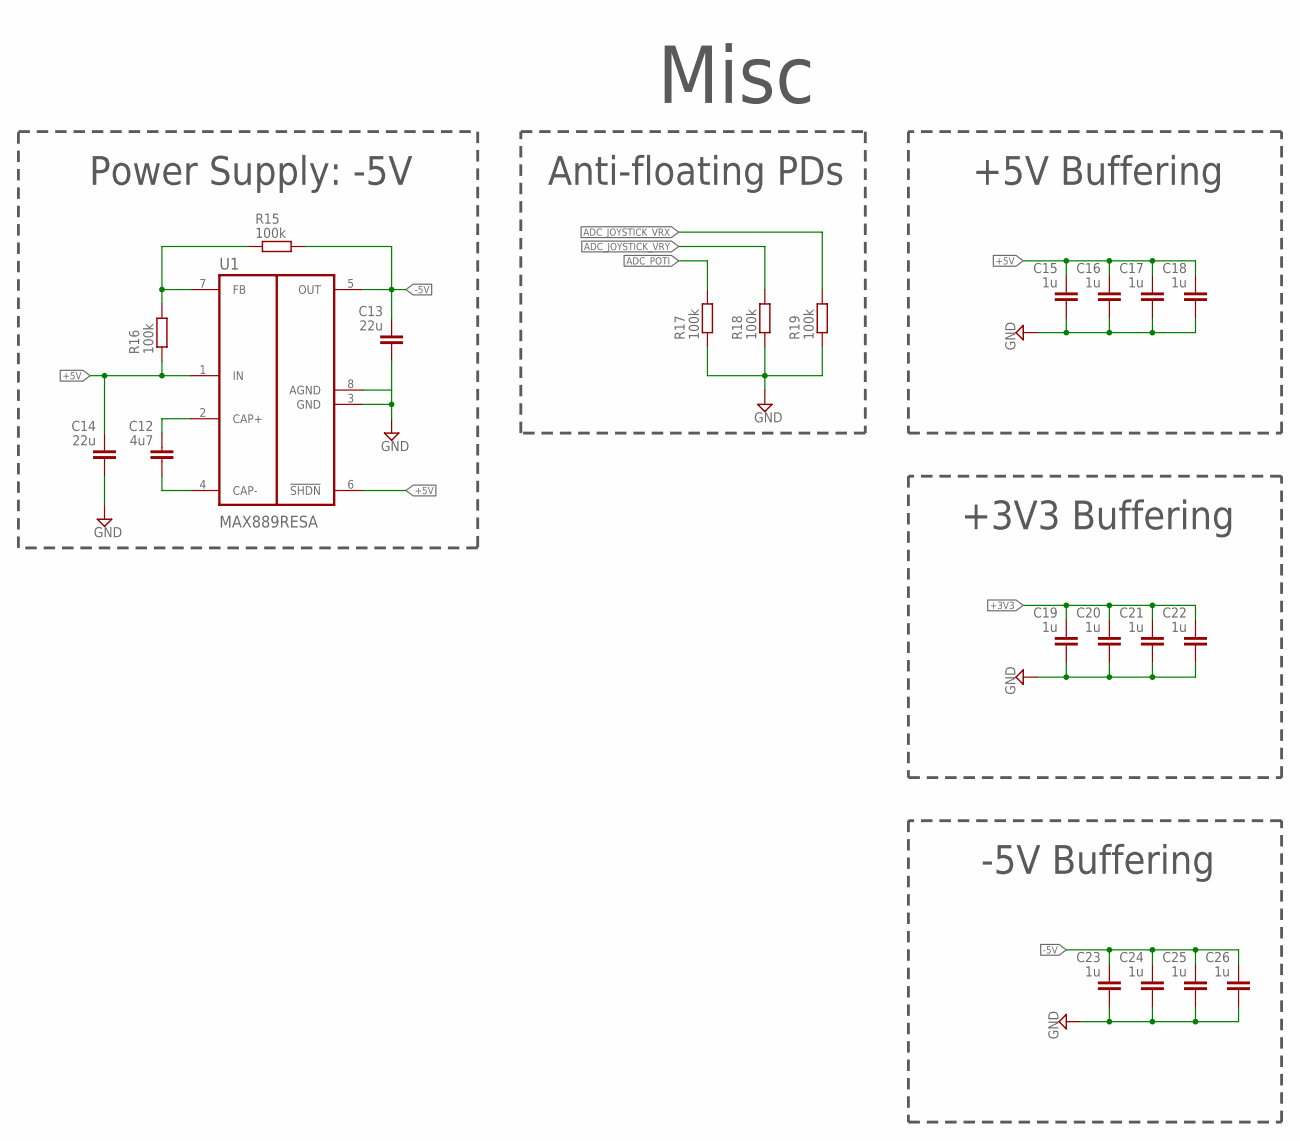
[picture p54: schematic DSP_Lab_SS21_Mainboard.sch, sheet 4]

Parts:
C12: 4u7; C0603
C13, C14: 22u; C0603
C15, C16, C17, C18, C19, C20, C21, C22, C23, C24, C25, C26: 1u; C0603
R15, R16, R17, R18, R19: 100k; R0603
U1: MAX889RESA; SOIC127P600X175-8N

Connections:
+3V3: C19.2, C20.2, C21.2, C22.2; also elsewhere on the board
+5V: C14.2, C15.2, C16.2, C17.2, C18.2, R16.1, U1.1 (IN), U1.6 (!SHDN); also elsewhere on the board
-5V: C13.2, C23.2, C24.2, C25.2, C26.2, R15.2, U1.5 (OUT); also elsewhere on the board
ADC_JOYSTICK_VRX: R19.2; also elsewhere on the board
ADC_JOYSTICK_VRY: R18.2; also elsewhere on the board
ADC_POTI: R17.2; also elsewhere on the board
GND: C13.1, C14.1, C15.1, C16.1, C17.1, C18.1, C19.1, C20.1, C21.1, C22.1, C23.1, C24.1, C25.1, C26.1, R17.1, R18.1, R19.1, U1.3 (GND), U1.8 (AGND); also elsewhere on the board
unnamed: R15.1, R16.2, U1.7 (FB)
unnamed: C12.2, U1.2 (CAP+)
unnamed: C12.1, U1.4 (CAP-)

Notes on the sheet:
Anti-floating PDs
Misc
Power Supply: -5V
+5V Buffering
+3V3 Buffering
-5V Buffering

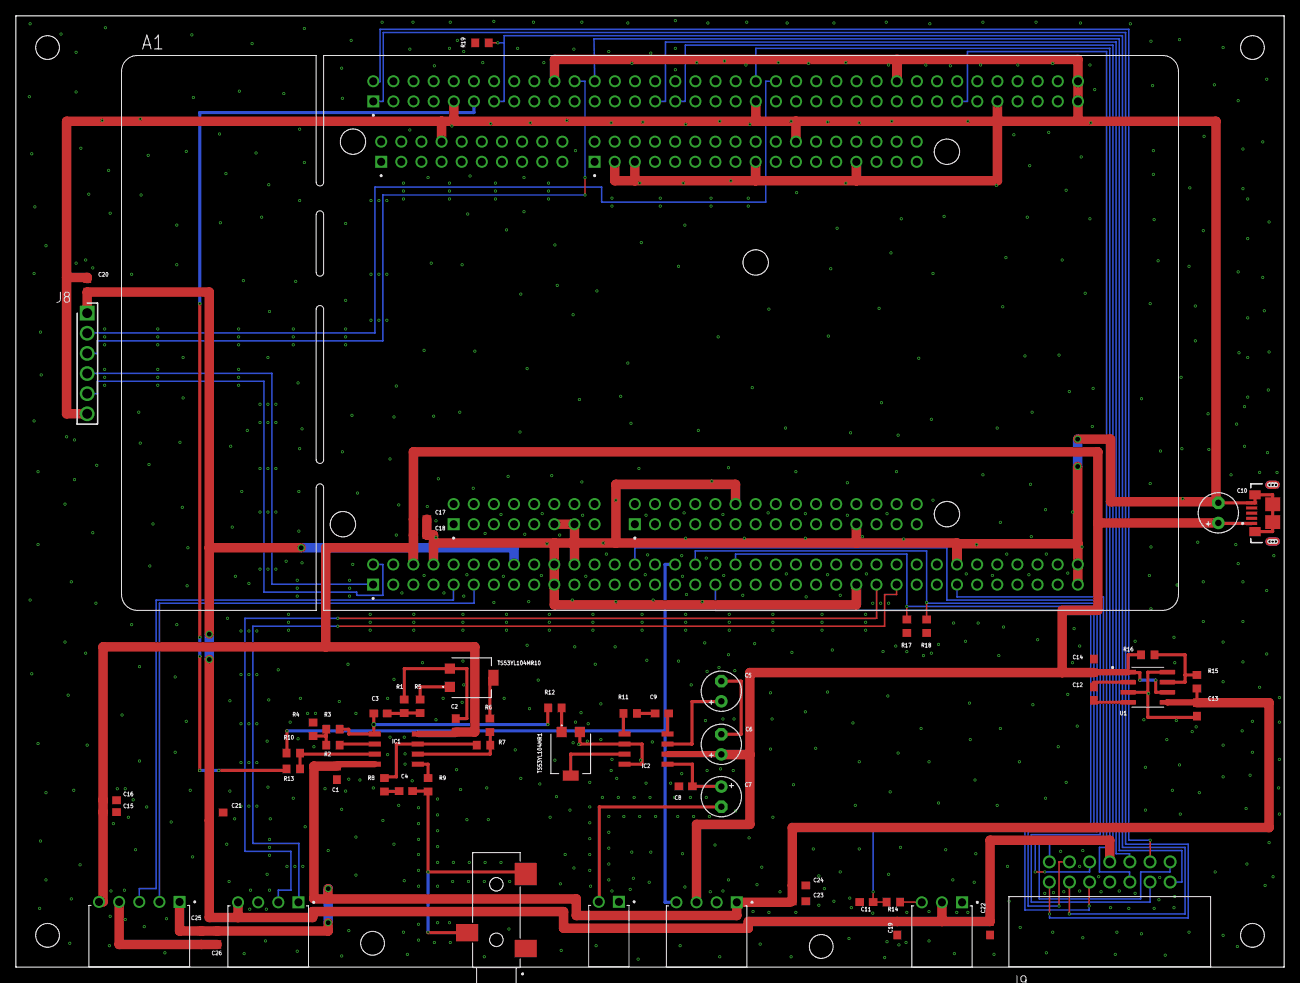
[picture p55: board DSP_Lab_SS21_Mainboard.brd from above]

Board: 2 copper layers, 160.0 x 120.0 mm, 60 parts (0 on the bottom side), 50 nets.
