pmamatis/The-Body-Synthesizer/EQ + VU-Meter/DSP_Lab_SS21_Equalizer_VUMeter_fin.brd

## EAGLE design EQ + VU-Meter/DSP_Lab_SS21_Equalizer_VUMeter_fin.brd (2021-08-13)

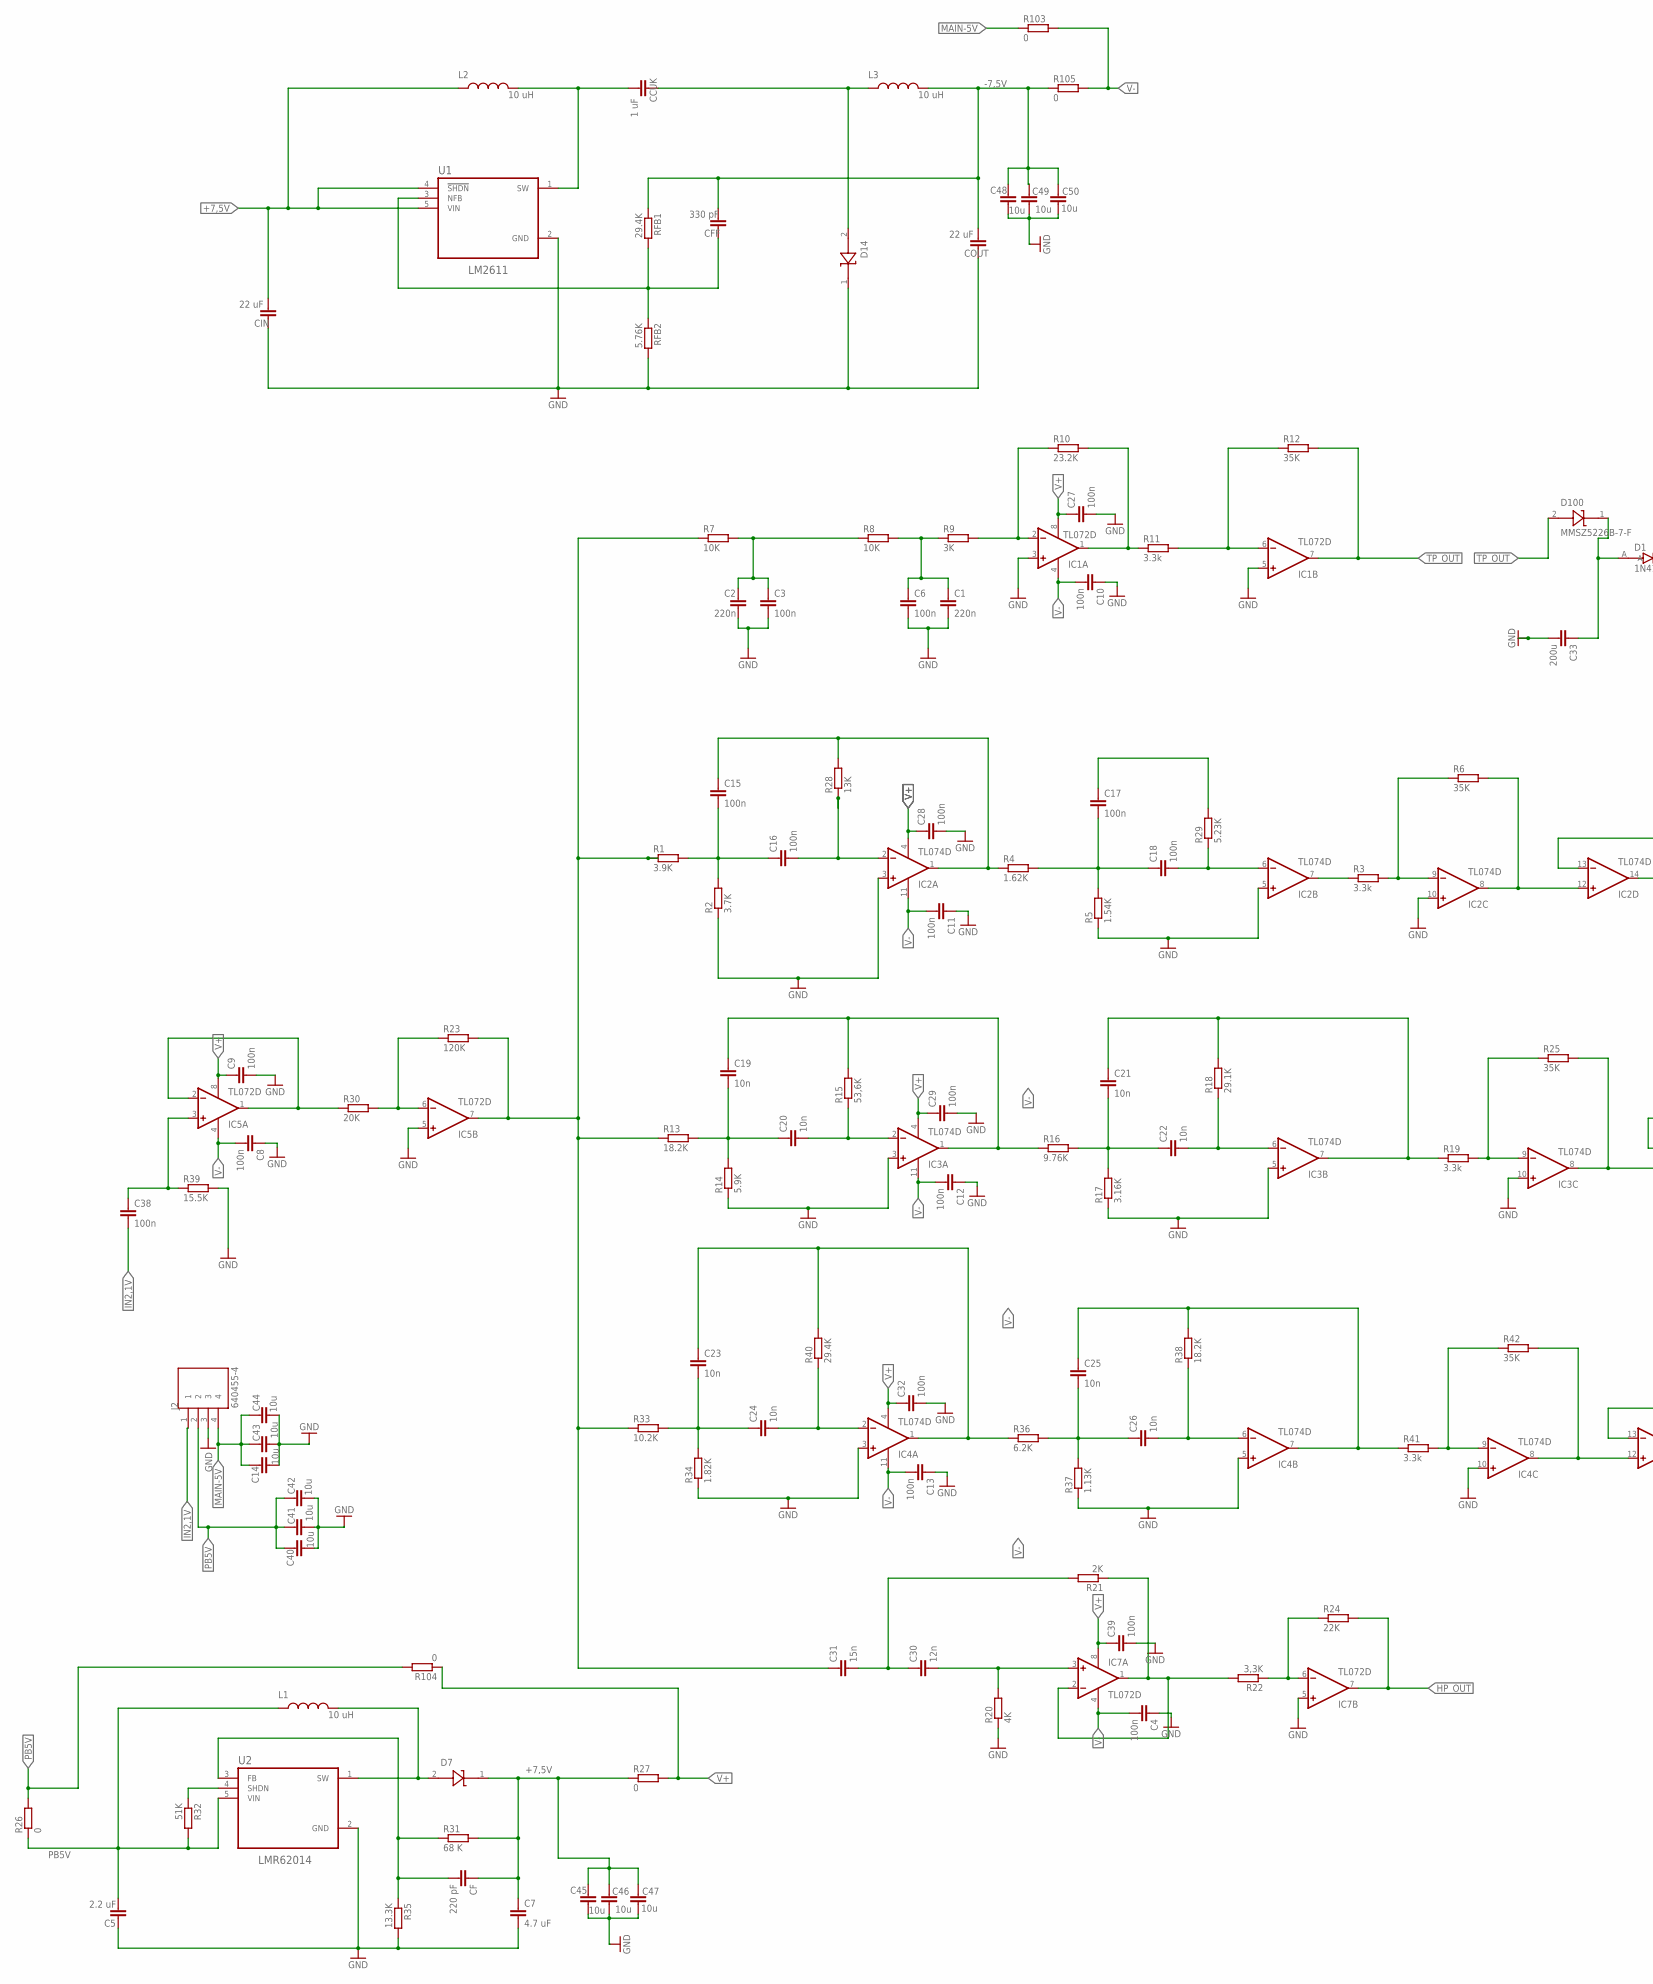
[picture p56: schematic DSP_Lab_SS21_Equalizer_VUMeter_fin.sch, part in row 1, column 1]

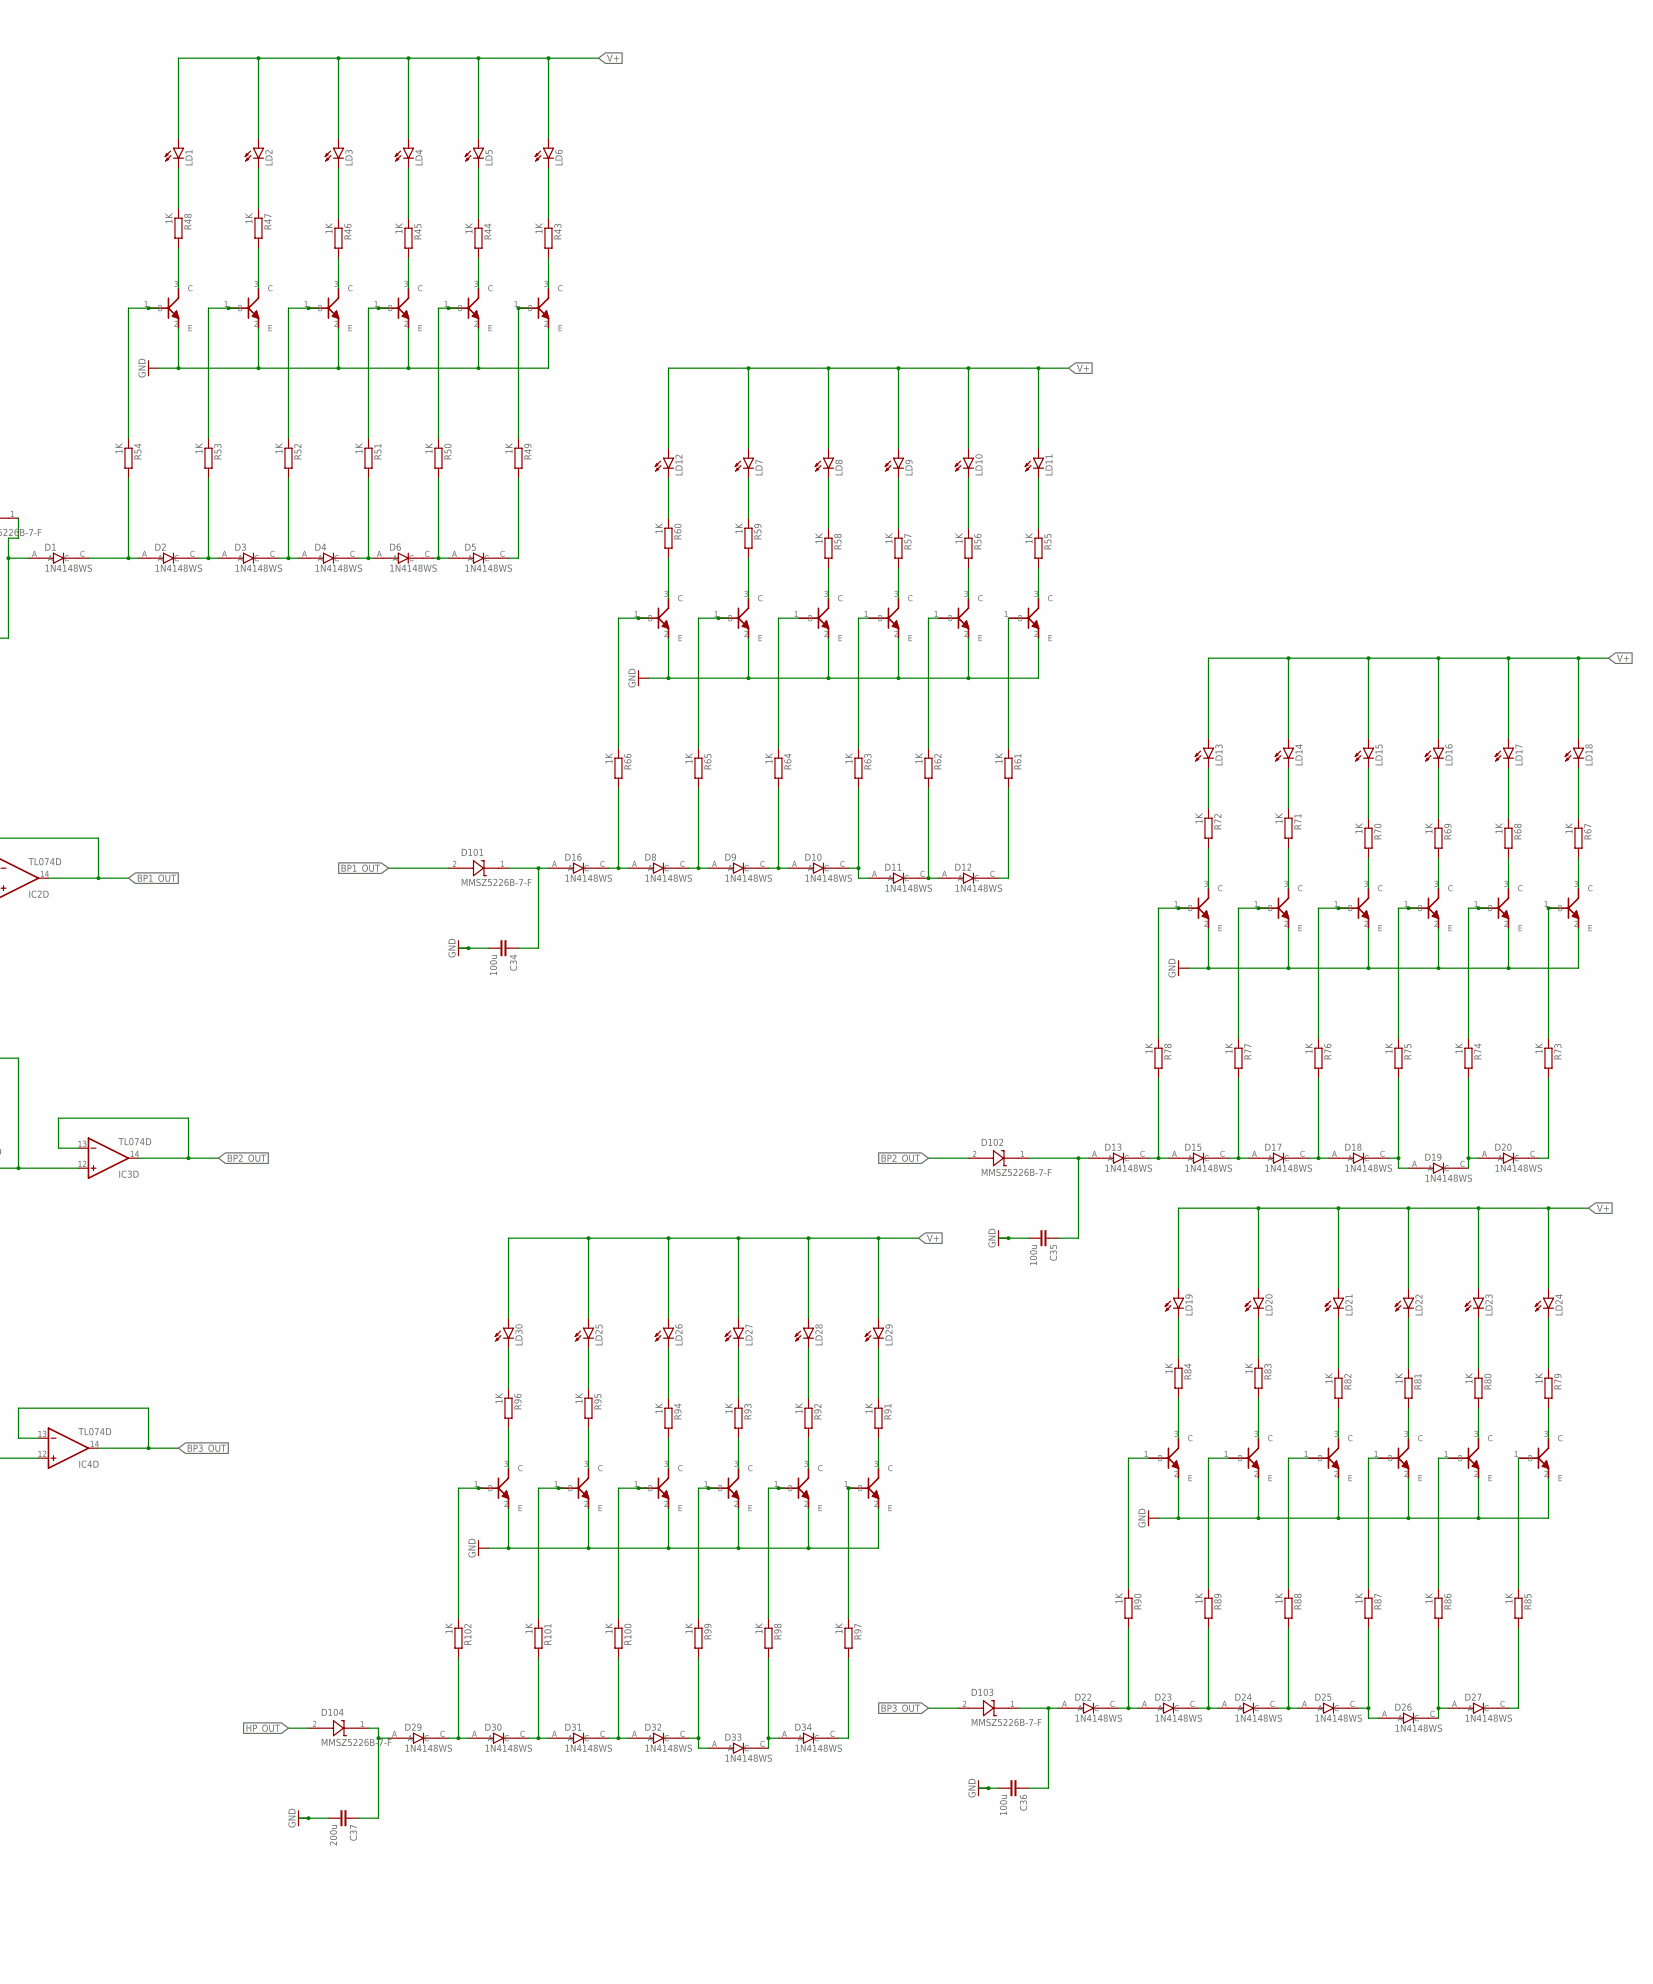
[picture p57: schematic DSP_Lab_SS21_Equalizer_VUMeter_fin.sch, part in row 1, column 2]

Parts:
C1, C2: 220n; C0603
C3, C4, C6, C8, C9, C10, C11, C12, C13, C15, C16, C17, C18, C27, C28, C29, C32, C38, C39: 100n; C0603
C5: 2.2 uF; C0603
C7: 4.7 uF; C0603
C14, C40, C41, C42, C43, C44, C45, C46, C47, C48, C49, C50: 10u; C0603
C19, C20, C21, C22, C23, C24, C25, C26: 10n; C0603
C30: 12n; C0603
C31: 15n; C0603
C33, C37: 200u; C0603
C34, C35, C36: 100u; C0603
CCUK: 1 uF; C0603
CF: 220 pF; C0603
CFF: 330 pF; C0603
CIN: 22 uF; C0603
COUT: 22 uF; C0603
D1, D2, D3, D4, D5, D6, D8, D9, D10, D11, D12, D13, D15, D16, D17, D18, D19, D20, D22, D23, D24, D25, D26, D27, D29, D30, D31, D32, D33, D34: 1N4148WS; SODFL2512X100N
D7, D14, D100, D101, D102, D103, D104: MMSZ5226B-7-F; SOD3715X135L32X57N
IC1, IC5, IC7: TL072D; SO08
IC2, IC3, IC4: TL074D; SO14
J2: 640455-4; TE_640455-4
L1, L2, L3: 10 uH; INDC1608X95N
LD1, LD2, LD3, LD4, LD5, LD6, LD7, LD8, LD9, LD10, LD11, LD12, LD13, LD14, LD15, LD16, LD17, LD18, LD19, LD20, LD21, LD22, LD23, LD24, LD25, LD26, LD27, LD28, LD29, LD30: LEDCHIP-LED0603; CHIP-LED0603
R1: 3.9K; R0603
R2: 3.7K; R0603
R3, R11, R19, R41: 3.3k; R0603
R4: 1.62K; R0603
R5: 1.54K; R0603
R6, R12, R25, R42: 35K; R0603
R7, R8: 10K; R0603
R9: 3K; R0603
R10: 23.2K; R0603
R13, R38: 18.2K; R0603
R14: 5.9K; R0603
R15: 53,6K; R0603
R16: 9.76K; R0603
R17: 3.16K; R0603
R18: 29.1K; R0603
R20: 4K; R0603
R21: 2K; R0603
R22: 3,3K; R0603
R23: 120K; R0603
R24: 22K; R0603
R26, R27, R103, R104, R105: 0; R0603
R28: 13K; R0603
R29: 5.23K; R0603
R30: 20K; R0603
R31: 68 K; R0603
R32: 51K; R0603
R33: 10.2K; R0603
R34: 1.82K; R0603
R35: 13.3K; R0603
R36: 6.2K; R0603
R37: 1.13K; R0603
R39: 15.5K; R0603
R40: 29.4K; R0603
R43, R44, R45, R46, R47, R48, R49, R50, R51, R52, R53, R54, R55, R56, R57, R58, R59, R60, R61, R62, R63, R64, R65, R66, R67, R68, R69, R70, R71, R72, R73, R74, R75, R76, R77, R78, R79, R80, R81, R82, R83, R84, R85, R86, R87, R88, R89, R90, R91, R92, R93, R94, R95, R96, R97, R98, R99, R100, R101, R102: 1K; R0603
RFB1: 29.4K; R0603
RFB2: 5.76K; R0603
T1, T2, T3, T4, T5, T6, T7, T8, T9, T10, T11, T12, T13, T14, T15, T16, T17, T18, T19, T20, T21, T22, T23, T24, T25, T26, T27, T28, T29, T30: BC846A; SOT23-3
U1: LM2611; SOT95P280X145-5N
U2: LMR62014; SOT95P280X145-5N

Connections:
+7,5V: C7.1, C45.2, C46.1, C47.1, CF.1, CIN.1, D7.1 (C), L2.1, R27.1, R31.2, U1.4 (!SHDN), U1.5 (VIN)
-7,5V: C48.2, C49.1, C50.1, CFF.1, COUT.1, L3.2, R105.1, RFB1.1
BP1_OUT: D101.2 (A), IC2.13 (-IN), IC2.14 (OUT)
BP2_OUT: D102.2 (A), IC3.13 (-IN), IC3.14 (OUT)
BP3_OUT: D103.2 (A), IC4.13 (-IN), IC4.14 (OUT)
GND: C1.2, C2.2, C3.2, C4.1, C5.2, C6.2, C7.2, C8.1, C9.2, C10.1, C11.1, C12.1, C13.1, C14.1, C27.2, C28.2, C29.2, C32.2, C33.2, C34.2, C35.2, C36.2, C37.2, C39.2, C40.1, C41.2, C42.2, C43.2, C44.2, C45.1, C46.2, C47.2, C48.1, C49.2, C50.2, CIN.2, COUT.2, D14.1 (C), IC1.3 (+IN), IC1.5 (+IN), IC2.3 (+IN), IC2.5 (+IN), IC2.10 (+IN), IC3.3 (+IN), IC3.5 (+IN), IC3.10 (+IN), IC4.3 (+IN), IC4.5 (+IN), IC4.10 (+IN), IC5.5 (+IN), IC7.5 (+IN), J2.3, R2.1, R5.1, R14.1, R17.1, R20.1, R34.1, R35.2, R37.1, R39.2, RFB2.2, T1.2 (E), T2.2 (E), T3.2 (E), T4.2 (E), T5.2 (E), T6.2 (E), T7.2 (E), T8.2 (E), T9.2 (E), T10.2 (E), T11.2 (E), T12.2 (E), T13.2 (E), T14.2 (E), T15.2 (E), T16.2 (E), T17.2 (E), T18.2 (E), T19.2 (E), T20.2 (E), T21.2 (E), T22.2 (E), T23.2 (E), T24.2 (E), T25.2 (E), T26.2 (E), T27.2 (E), T28.2 (E), T29.2 (E), T30.2 (E), U1.2 (GND), U2.2 (GND)
HP_OUT: D104.2 (A), IC7.7 (OUT), R24.2
IN2,1V: C38.2, J2.1
MAIN-5V: C14.2, C43.1, C44.1, J2.4, R103.1
unnamed: C1.1, C6.1, R8.2, R9.1
unnamed: IC1.2 (-IN), R9.2, R10.1
unnamed: C2.1, C3.1, R7.2, R8.1
unnamed: C31.1, IC5.7 (OUT), R1.1, R7.1, R13.1, R23.2, R33.1
unnamed: IC2.9 (-IN), R3.2, R6.1
unnamed: IC1.1 (OUT), R10.2, R11.1
unnamed: IC3.9 (-IN), R19.2, R25.1
unnamed: IC1.6 (-IN), R11.2, R12.1
unnamed: C15.2, C16.1, R1.2, R2.2
unnamed: C16.2, IC2.2 (-IN), R28.1
unnamed: C15.1, IC2.1 (OUT), R4.1, R28.2
unnamed: C19.2, C20.1, R13.2, R14.2
unnamed: C17.1, R29.2
unnamed: C18.2, IC2.6 (-IN), R29.1
unnamed: C21.1, IC3.7 (OUT), R18.2, R19.1
unnamed: C20.2, IC3.2 (-IN), R15.1
unnamed: C19.1, IC3.1 (OUT), R15.2, R16.1
unnamed: R32.1, U2.4 (SHDN)
unnamed: CF.2, R31.1, R35.1, U2.3 (FB)
unnamed: C21.2, C22.1, R16.2, R17.2
unnamed: C22.2, IC3.6 (-IN), R18.1
unnamed: IC4.8 (OUT), IC4.12 (+IN), R42.2
unnamed: C23.1, IC4.1 (OUT), R36.1, R40.2
unnamed: C23.2, C24.1, R33.2, R34.2
unnamed: C24.2, IC4.2 (-IN), R40.1
unnamed: IC5.6 (-IN), R23.1, R30.2
unnamed: D15.C, D17.A, R77.2
unnamed: C25.2, C26.1, R36.2, R37.2
unnamed: C26.2, IC4.6 (-IN), R38.1
unnamed: D17.C, D18.A, R76.2
unnamed: C30.2, IC7.3 (+IN), R20.2
unnamed: C17.2, C18.1, R4.2, R5.2
unnamed: IC7.1 (OUT), IC7.2 (-IN), R21.1, R22.2
unnamed: D23.C, D24.A, R89.2
unnamed: C30.1, C31.2, R21.2
unnamed: IC7.6 (-IN), R22.1, R24.1
unnamed: LD6.C, R43.1
unnamed: LD5.C, R44.1
unnamed: IC5.1 (OUT), IC5.2 (-IN), R30.1
unnamed: LD4.C, R45.1
unnamed: LD3.C, R46.1
unnamed: LD2.C, R47.1
unnamed: LD1.C, R48.1
unnamed: C38.1, IC5.3 (+IN), R39.1
unnamed: C25.1, IC4.7 (OUT), R38.2, R41.1
unnamed: R43.2, T6.3 (C)
unnamed: R44.2, T5.3 (C)
unnamed: R45.2, T4.3 (C)
unnamed: R46.2, T3.3 (C)
unnamed: R47.2, T2.3 (C)
unnamed: R48.2, T1.3 (C)
unnamed: R49.1, T6.1 (B)
unnamed: R50.1, T5.1 (B)
unnamed: R51.1, T4.1 (B)
unnamed: R52.1, T3.1 (B)
unnamed: R53.1, T2.1 (B)
unnamed: R54.1, T1.1 (B)
unnamed: C33.1, D1.A, D100.1 (C)
unnamed: D1.C, D2.A, R54.2
unnamed: D2.C, D3.A, R53.2
unnamed: D3.C, D4.A, R52.2
unnamed: D4.C, D6.A, R51.2
unnamed: D5.A, D6.C, R50.2
unnamed: D5.C, R49.2
unnamed: LD11.C, R55.1
unnamed: LD10.C, R56.1
unnamed: LD9.C, R57.1
unnamed: LD8.C, R58.1
unnamed: LD7.C, R59.1
unnamed: LD12.C, R60.1
unnamed: D7.2 (A), L1.2, U2.1 (SW)
unnamed: R55.2, T7.3 (C)
unnamed: R56.2, T8.3 (C)
unnamed: R57.2, T9.3 (C)
unnamed: R58.2, T10.3 (C)
unnamed: R59.2, T11.3 (C)
unnamed: R60.2, T12.3 (C)
unnamed: R61.1, T7.1 (B)
unnamed: R62.1, T8.1 (B)
unnamed: R63.1, T9.1 (B)
unnamed: R64.1, T10.1 (B)
unnamed: R65.1, T11.1 (B)
unnamed: R66.1, T12.1 (B)
unnamed: C34.1, D16.A, D101.1 (C)
unnamed: D8.A, D16.C, R66.2
unnamed: D8.C, D9.A, R65.2
unnamed: D9.C, D10.A, R64.2
unnamed: D10.C, D11.A, R63.2
unnamed: D11.C, D12.A, R62.2
unnamed: D12.C, R61.2
unnamed: LD18.C, R67.1
unnamed: LD17.C, R68.1
unnamed: LD16.C, R69.1
unnamed: LD15.C, R70.1
unnamed: LD14.C, R71.1
unnamed: LD13.C, R72.1
unnamed: IC3.8 (OUT), IC3.12 (+IN), R25.2
unnamed: R67.2, T18.3 (C)
unnamed: R68.2, T17.3 (C)
unnamed: R69.2, T16.3 (C)
unnamed: R70.2, T15.3 (C)
unnamed: R71.2, T14.3 (C)
unnamed: R72.2, T13.3 (C)
unnamed: R73.1, T18.1 (B)
unnamed: R74.1, T17.1 (B)
unnamed: R75.1, T16.1 (B)
unnamed: R76.1, T15.1 (B)
unnamed: R77.1, T14.1 (B)
unnamed: R78.1, T13.1 (B)
unnamed: C35.1, D13.A, D102.1 (C)
unnamed: D13.C, D15.A, R78.2
unnamed: IC2.8 (OUT), IC2.12 (+IN), R6.2
unnamed: D18.C, D19.A, R75.2
unnamed: D19.C, D20.A, R74.2
unnamed: D20.C, R73.2
unnamed: LD24.C, R79.1
unnamed: LD23.C, R80.1
unnamed: LD22.C, R81.1
unnamed: LD21.C, R82.1
unnamed: LD20.C, R83.1
unnamed: LD19.C, R84.1
unnamed: CCUK.2, D14.2 (A), L3.1
unnamed: R79.2, T24.3 (C)
unnamed: R80.2, T23.3 (C)
unnamed: R81.2, T22.3 (C)
unnamed: R82.2, T21.3 (C)
unnamed: R83.2, T20.3 (C)
unnamed: R84.2, T19.3 (C)
unnamed: R85.1, T24.1 (B)
unnamed: R86.1, T23.1 (B)
unnamed: R87.1, T22.1 (B)
unnamed: R88.1, T21.1 (B)
unnamed: R89.1, T20.1 (B)
unnamed: R90.1, T19.1 (B)
unnamed: C36.1, D22.A, D103.1 (C)
unnamed: D22.C, D23.A, R90.2
unnamed: CCUK.1, L2.2, U1.1 (SW)
unnamed: D24.C, D25.A, R88.2
unnamed: D25.C, D26.A, R87.2
unnamed: D26.C, D27.A, R86.2
unnamed: D27.C, R85.2
unnamed: LD29.C, R91.1
unnamed: LD28.C, R92.1
unnamed: LD27.C, R93.1
unnamed: LD26.C, R94.1
unnamed: LD25.C, R95.1
unnamed: LD30.C, R96.1
unnamed: CFF.2, RFB1.2, RFB2.1, U1.3 (NFB)
unnamed: R91.2, T30.3 (C)
unnamed: R92.2, T29.3 (C)
unnamed: R93.2, T28.3 (C)
unnamed: R94.2, T27.3 (C)
unnamed: R95.2, T26.3 (C)
unnamed: R96.2, T25.3 (C)
unnamed: R97.1, T30.1 (B)
unnamed: R98.1, T29.1 (B)
unnamed: R99.1, T28.1 (B)
unnamed: R100.1, T27.1 (B)
unnamed: R101.1, T26.1 (B)
unnamed: R102.1, T25.1 (B)
unnamed: C37.1, D29.A, D104.1 (C)
unnamed: D29.C, D30.A, R102.2
unnamed: D30.C, D31.A, R101.2
unnamed: D31.C, D32.A, R100.2
unnamed: D32.C, D33.A, R99.2
unnamed: D33.C, D34.A, R98.2
unnamed: D34.C, R97.2
unnamed: IC2.7 (OUT), R3.1
unnamed: IC4.9 (-IN), R41.2, R42.1
PB5V: C5.1, C40.2, C41.1, C42.1, J2.2, L1.1, R26.1, R26.2, R32.2, R104.2, U2.5 (VIN)
TP_OUT: D100.2 (A), IC1.7 (OUT), R12.2
V+: C9.1, C27.1, C28.1, C29.1, C32.1, C39.1, IC1.8 (V+), IC2.4 (V+), IC3.4 (V+), IC4.4 (V+), IC5.8 (V+), IC7.8 (V+), LD1.A, LD2.A, LD3.A, LD4.A, LD5.A, LD6.A, LD7.A, LD8.A, LD9.A, LD10.A, LD11.A, LD12.A, LD13.A, LD14.A, LD15.A, LD16.A, LD17.A, LD18.A, LD19.A, LD20.A, LD21.A, LD22.A, LD23.A, LD24.A, LD25.A, LD26.A, LD27.A, LD28.A, LD29.A, LD30.A, R27.2, R104.1
V-: C4.2, C8.2, C10.2, C11.2, C12.2, C13.2, IC1.4 (V-), IC2.11 (V-), IC3.11 (V-), IC4.11 (V-), IC5.4 (V-), IC7.4 (V-), R103.2, R105.2

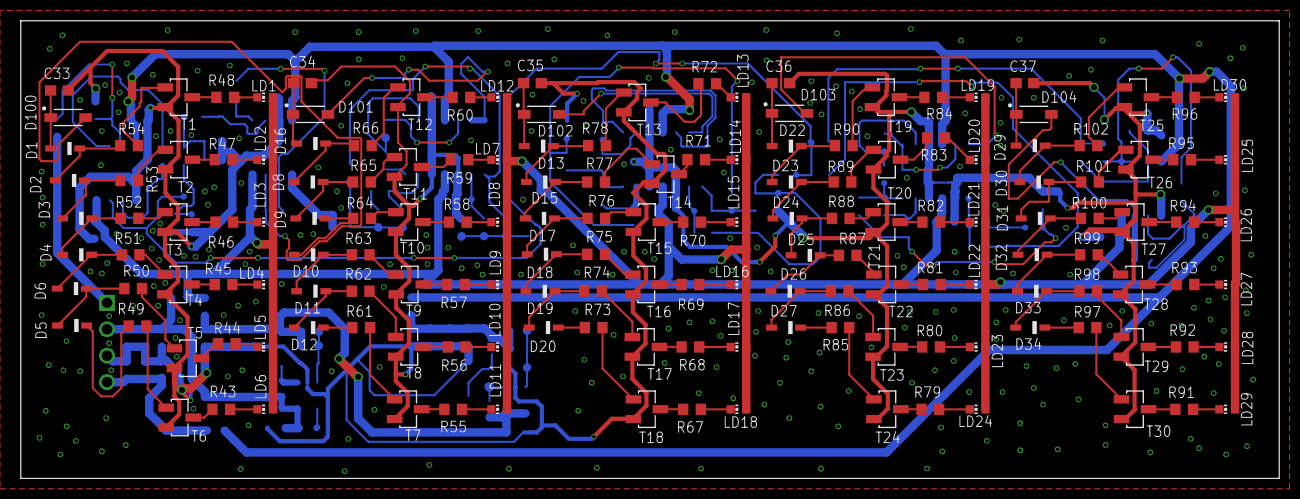
[picture p58: board DSP_Lab_SS21_Equalizer_VUMeter_fin.brd from above]

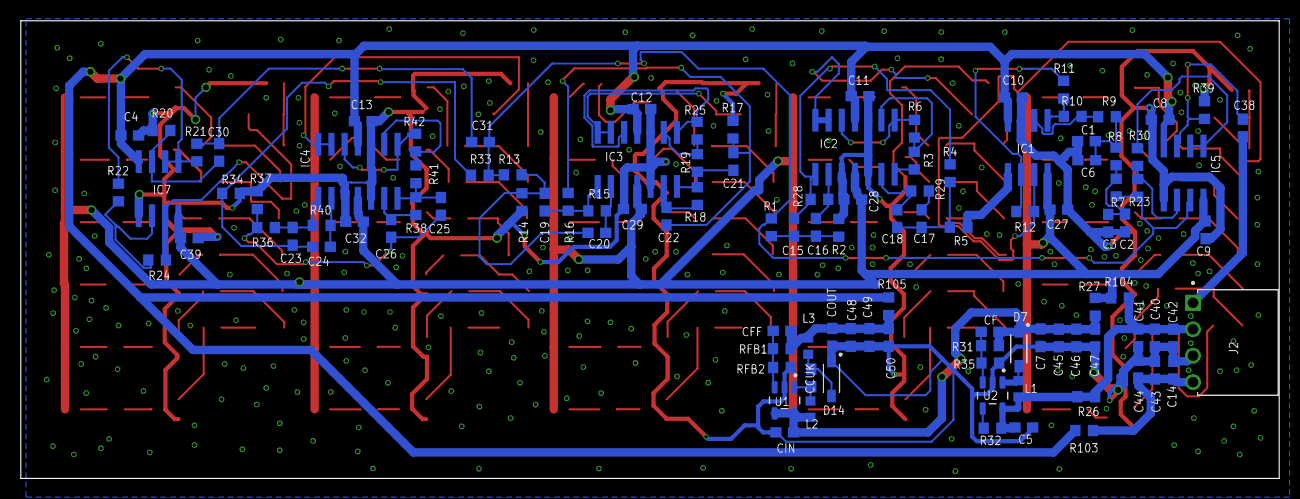
[picture p59: board DSP_Lab_SS21_Equalizer_VUMeter_fin.brd from below]

Board: 2 copper layers, 121.0 x 44.0 mm, 271 parts (111 on the bottom side), 182 nets.
