pmamatis/The-Body-Synthesizer/Keyboard/DSP_Lab_SS21_Keyboard_V2.brd

## EAGLE design Keyboard/DSP_Lab_SS21_Keyboard_V2.brd (2021-07-20)

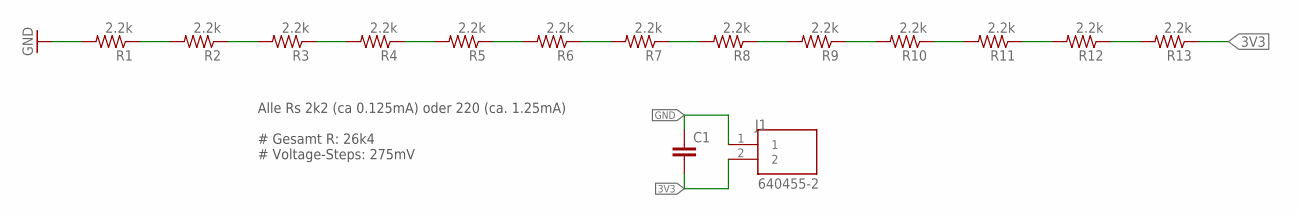
[picture p60: schematic DSP_Lab_SS21_Keyboard_V2.sch]

Parts:
C1: C-EUC0603; C0603
J1: 640455-2; TE_640455-2
R1, R2, R3, R4, R5, R6, R7, R8, R9, R10, R11, R12, R13: 2.2k; R0603

Connections:
3V3: C1.2, J1.2, R13.1
GND: C1.1, J1.1, R1.2
STEP1: R1.1, R2.2
STEP2: R2.1, R3.2
STEP3: R3.1, R4.2
STEP4: R4.1, R5.2
STEP5: R5.1, R6.2
STEP6: R6.1, R7.2
STEP7: R7.1, R8.2
STEP8: R8.1, R9.2
STEP9: R9.1, R10.2
STEP10: R10.1, R11.2
STEP11: R11.1, R12.2
STEP12: R12.1, R13.2

Notes on the sheet:
Alle Rs 2k2 (ca 0.125mA) oder 220 (ca. 1.25mA) # Gesamt R: 26k4 # Voltage-Steps: 275mV

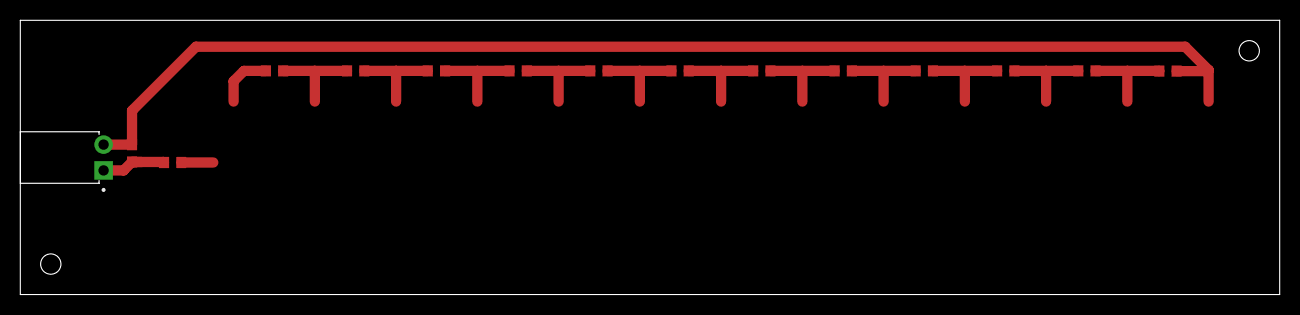
[picture p61: board DSP_Lab_SS21_Keyboard_V2.brd from above]

Board: 2 copper layers, 124.0 x 27.0 mm, 15 parts (0 on the bottom side), 14 nets.
