pmamatis/The-Body-Synthesizer/ACC/ACC.brd

## EAGLE design ACC/ACC.brd (2020-05-15)

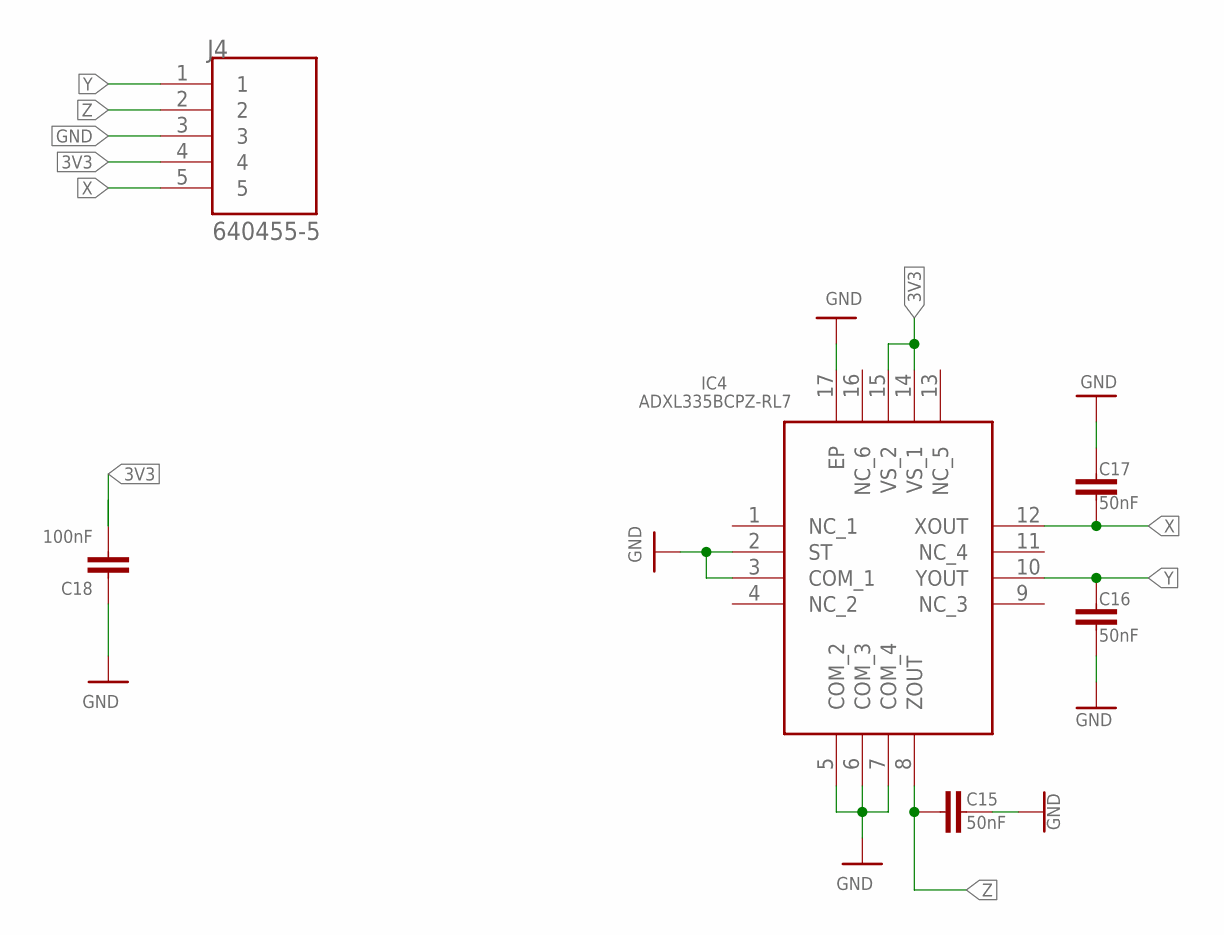
[picture p62: schematic ACC.sch]

Parts:
C15, C16, C17: 50nF; C0603
C18: 100nF; C0603
IC4: ADXL335BCPZ-RL7; QFN65P400X400X150-17N
J4: 640455-5; TE_640455-5

Connections:
3V3: C18.2, IC4.14 (VS_1), IC4.15 (VS_2), J4.4
GND: C15.1, C16.2, C17.1, C18.1, IC4.2 (ST), IC4.3 (COM_1), IC4.5 (COM_2), IC4.6 (COM_3), IC4.7 (COM_4), IC4.17 (EP), J4.3
X: C17.2, IC4.12 (XOUT), J4.5
Y: C16.1, IC4.10 (YOUT), J4.1
Z: C15.2, IC4.8 (ZOUT), J4.2

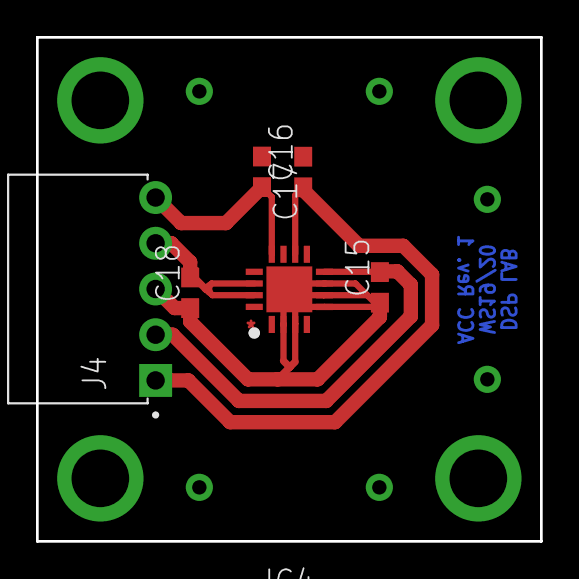
[picture p63: board ACC.brd from above]

Board: 2 copper layers, 28.0 x 28.0 mm, 6 parts (0 on the bottom side), 5 nets.
