pmamatis/The-Body-Synthesizer/Keyboard/Production/DSP_Lab_SS21_Keyboard_panelized.brd

## EAGLE design Keyboard/Production/DSP_Lab_SS21_Keyboard_panelized.brd (2021-06-02)

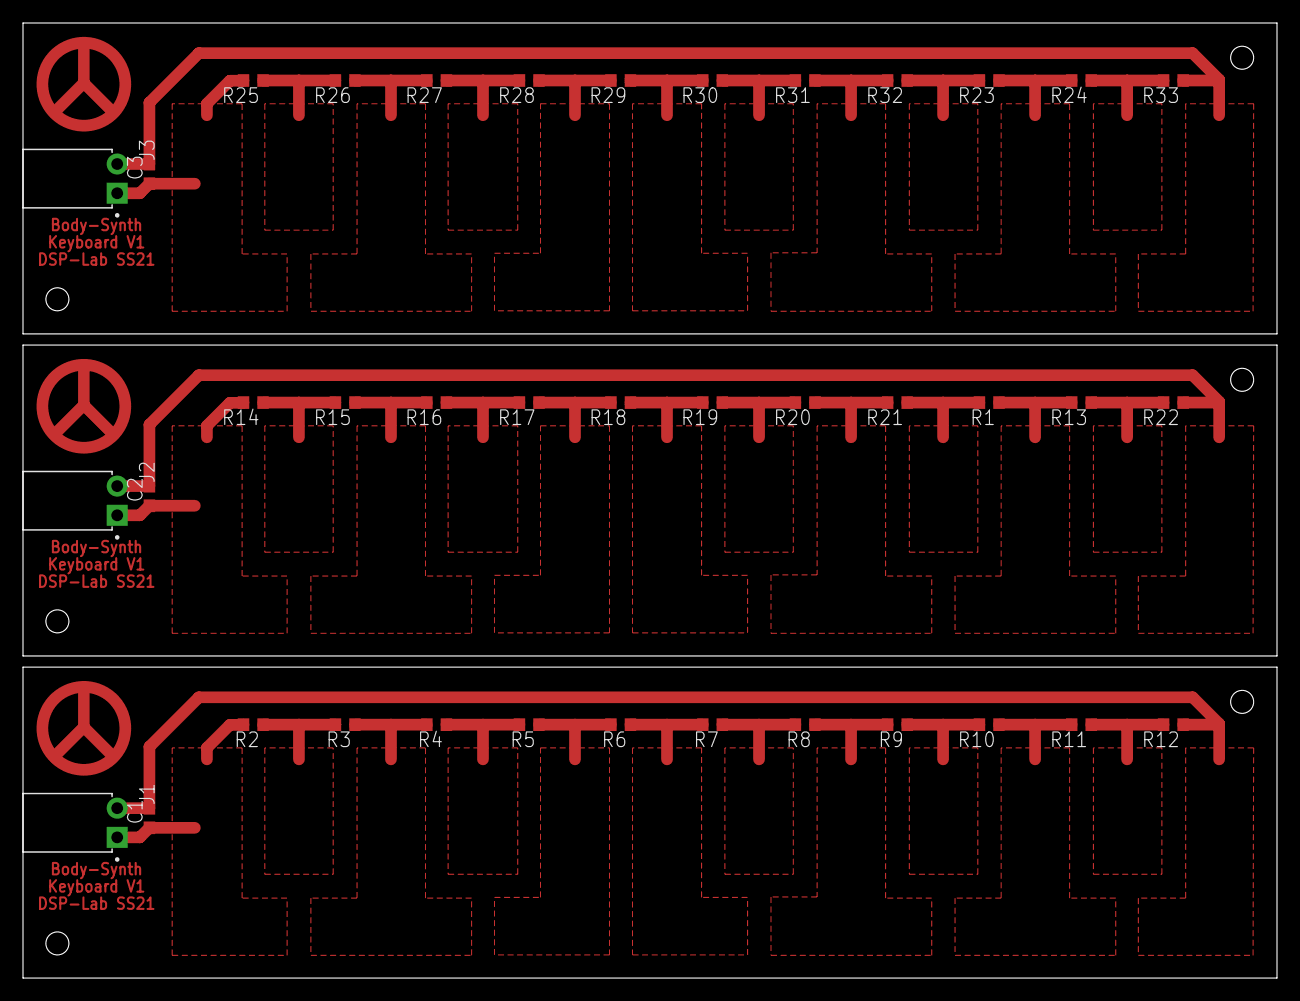
[picture p64: board DSP_Lab_SS21_Keyboard_panelized.brd from above]

Board: 2 copper layers, 109.0 x 83.0 mm, 39 parts (0 on the bottom side), 36 nets.

Parts:
C1, C2, C3: C0603
J1, J2, J3: 640455-2; TE_640455-2
R1, R2, R3, R4, R5, R6, R7, R8, R9, R10, R11, R12, R13, R14, R15, R16, R17, R18, R19, R20, R21, R22, R23, R24, R25, R26, R27, R28, R29, R30, R31, R32, R33: 2.2k; R0603

Connections:
3V1: C2.2, J2.2, R22.1
3V2: C3.2, J3.2, R33.1
3V3: C1.2, J1.2, R12.1
GND: C1.1, J1.1, R2.2
GND1: C2.1, J2.1, R14.2
GND2: C3.1, J3.1, R25.2
STEP1: R19.1, R20.2
STEP2: R2.1, R3.2
STEP3: R3.1, R4.2
STEP4: R4.1, R5.2
STEP5: R5.1, R6.2
STEP6: R6.1, R7.2
STEP7: R7.1, R8.2
STEP8: R8.1, R9.2
STEP9: R9.1, R10.2
STEP10: R10.1, R11.2
STEP11: R11.1, R12.2
STEP12: R14.1, R15.2
STEP13: R15.1, R16.2
STEP14: R16.1, R17.2
STEP15: R17.1, R18.2
STEP16: R18.1, R19.2
STEP17: R20.1, R21.2
STEP18: R1.2, R21.1
STEP19: R1.1, R13.2
STEP20: R13.1, R22.2
STEP21: R30.1, R31.2
STEP22: R25.1, R26.2
STEP23: R26.1, R27.2
STEP24: R27.1, R28.2
STEP25: R28.1, R29.2
STEP26: R29.1, R30.2
STEP27: R31.1, R32.2
STEP28: R23.2, R32.1
STEP29: R23.1, R24.2
STEP30: R24.1, R33.2
