pmamatis/The-Body-Synthesizer/(commit log)

2020-05-15 eagle branch added, all boards up to date
    [ACC.brd, ACC.sch, EMG.brd, EMG.sch, Keyboard.brd, Keyboard.sch, Mainboard.sch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]
2021-03-04 Upload New File
    [Equalizer_VUMeter.brd]
2021-04-25 EMG board updates
2021-06-01 Keyboard slightly edited (2 drills) for manufacturing
    [DSP_Lab_SS21_Keyboard.brd, DSP_Lab_SS21_Keyboard.sch]
2021-06-02 Keyboard panelized
    [DSP_Lab_SS21_Keyboard_panelized.brd, DSP_Lab_SS21_Keyboard_panelized.sch]
2021-06-13 Mainboard created
    [Mainboard.brd]
2021-06-21 Display-Board Updated!
    [User_Interface_Board.kicad_pcb, User_Interface_Board.sch]
2021-06-21 changed orientation of the display
    [User_Interface_Board.kicad_pcb, User_Interface_Board.sch]
2021-06-28 Bemaßung hinzugefügt
    [User_Interface_Board.kicad_pcb]
2021-07-09 Mainboard updated
    [Mainboard.brd, Mainboard.sch]
2021-07-10 Mainboard updated II
    [Mainboard.brd, Mainboard.sch]
2021-07-15 # Mainboard updated
    # Keyboard V2:
    # Bug fixed (lowest Pad not GND)
    # 1 more key (upper C)
    # PEACE sign corrected
    # General cleanup
    [DSP_Lab_SS21_Keyboard.brd, DSP_Lab_SS21_Keyboard.sch, DSP_Lab_SS21_Keyboard_V2.brd, DSP_Lab_SS21_Keyboard_V2.sch, DSP_Lab_SS21_Keyboard_panelized.brd, DSP_Lab_SS21_Keyboard_panelized.sch, Equalizer_VUMeter.brd, Equalizer_VUMeter.sch]
2021-07-15 Mainboard updated IV
    [Mainboard.brd, Mainboard.sch]
2021-07-17 # Mainboard updated V
    # Keys finalizing production
    # EQ finalizing production
    [DSP_Lab_SS21_Keyboard_V2.brd, Equalizer_VUMeter.brd, Mainboard.brd, Mainboard.sch]
2021-07-18 Mainboard updated VI (ready2route)
    [Mainboard.brd, Mainboard.sch]
2021-07-18 Mainboard updated VII
    [Mainboard.brd, Mainboard.sch]
2021-07-18 Mainboard updated VIII: routed completely, only need to check SD Card size
    [Mainboard.brd, Mainboard.sch]
2021-07-19 # Mainboard updated IX: final version (sd card size checked)
    # EQ/VU-Meter final version added
    [Equalizer_VUMeter_fin.brd, Equalizer_VUMeter_fin.sch, Mainboard.brd]
2021-07-20 Production data for ordering Mainboard, Keys, UI and EQ at JLCPCB
    [DSP_Lab_SS21_Equalizer_VUMeter_fin.brd, DSP_Lab_SS21_Equalizer_VUMeter_fin.sch, DSP_Lab_SS21_Keyboard_V2.brd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]
2021-07-21 BOMs uploaded
    [BOM_DSP_Lab_SS21_Equalizer_VUMeter_fin.xlsx, BOM_DSP_Lab_SS21_Keyboard_V2.xlsx, BOM_DSP_Lab_SS21_Mainboard.xlsx]
2021-08-12 Production data updated, Mainboard Housing added
    [Mainboard Bottom.stl, Mainboard Top.stl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]
2021-08-13 EQ BOM updated
    [BOM_DSP_Lab_SS21_Equalizer_VUMeter_fin.xlsx, DSP_Lab_SS21_Equalizer_VUMeter_fin.brd]
2021-08-15 BOM updated
    [BOM_DSP_Lab_SS21_Equalizer_VUMeter_fin.xlsx]
2021-09-02 Added pictures for EMG and Mainboard for final report
    [DSP_Lab_SS21_Mainboard.brd, DSP_Lab_SS21_Mainboard.sch, EMG.brd, EMG.sch]
2022-02-20 keyboard sch text edited
    [DSP_Lab_SS21_Keyboard_V2.sch]
2022-02-20 Keyboard pictures added and sch updated
    [DSP_Lab_SS21_Keyboard.sch, DSP_Lab_SS21_Keyboard_V2.sch]
